rjhelms/compe6502/README.md

# compe6502

A very much work-in-progress homebrew 6502 system.

Hardware is currently built off of a 6502 protoboard, available at https://github.com/rjhelms/6502proto.

All hardware CC-BY-SA 4.0. All software zlib license unless otherwise specified.
