rjhelms/compe6502/examples/clock/README.md

# Clock

An analog clock display, as a demonstration of TGI and clock implementations.

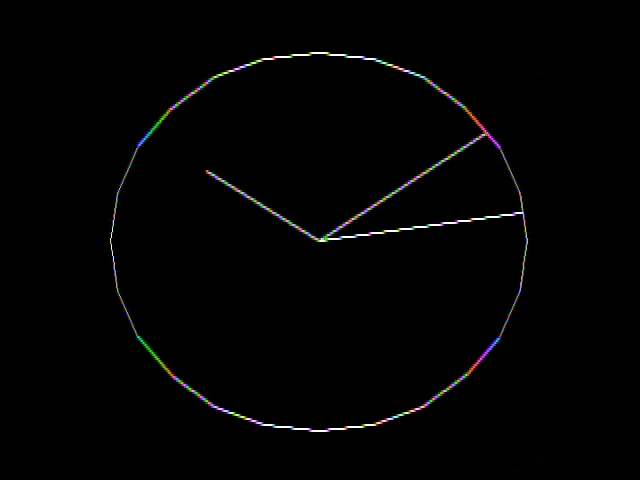
[picture p1: examples/clock/img/clock_1.jpg]

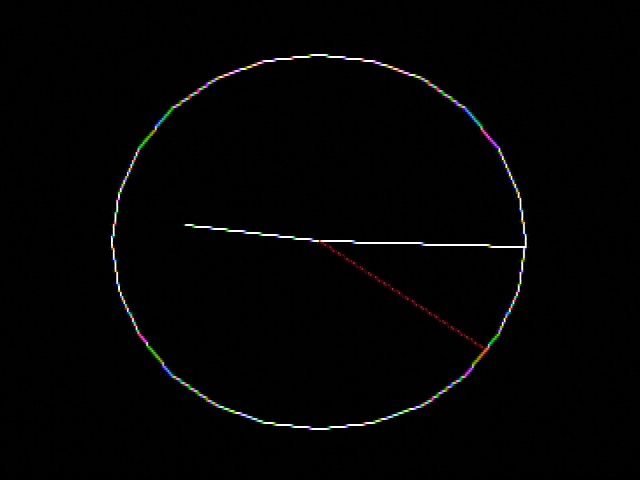
[picture p2: examples/clock/img/clock_2.jpg]

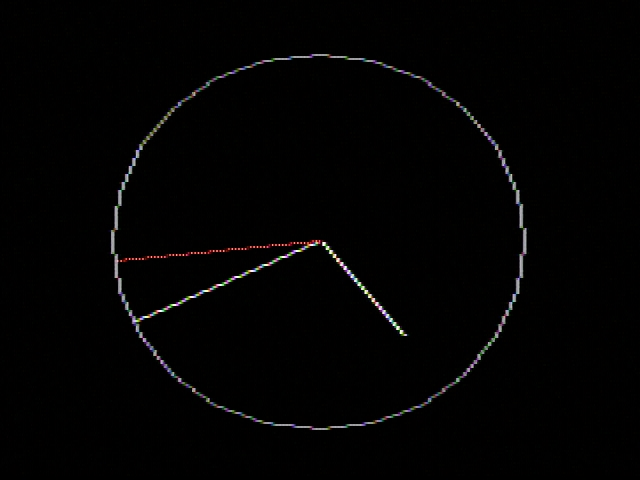
[picture p3: examples/clock/img/clock_3.jpg]


## Building

To choose a TGI driver (and therefore graphics mode), set the MODE variable when
building:

* `_1BPP`: 640x192 monochrome
* `_4BPP`: 320x192 16-color
* `_8BPP`: 160x192 256-color
