rjhelms/compe6502/examples/hangman/README.md

# Hangman

A simple implenetation of the classic game Hangman, as a modest example of the cc65 buildchain for the Compe6502.

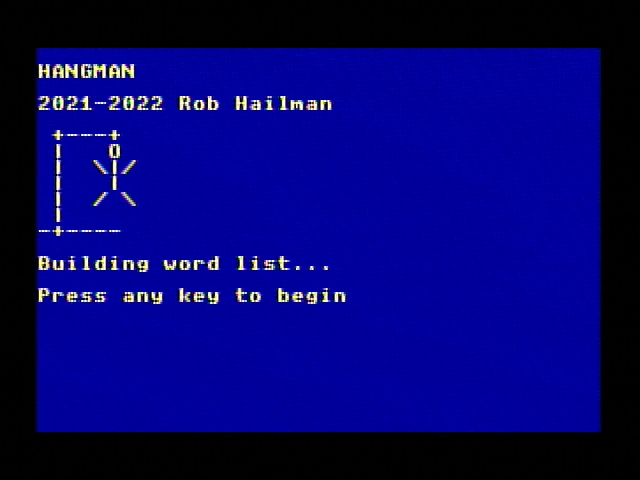
[picture p4: examples/hangman/img/hangman_1.jpg]

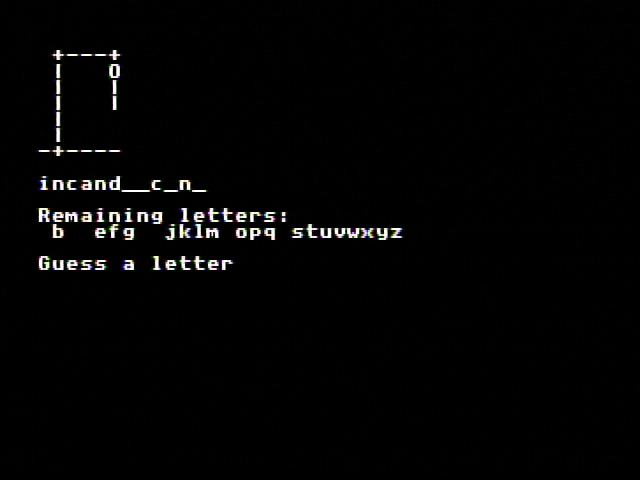
[picture p5: examples/hangman/img/hangman_2.jpg]

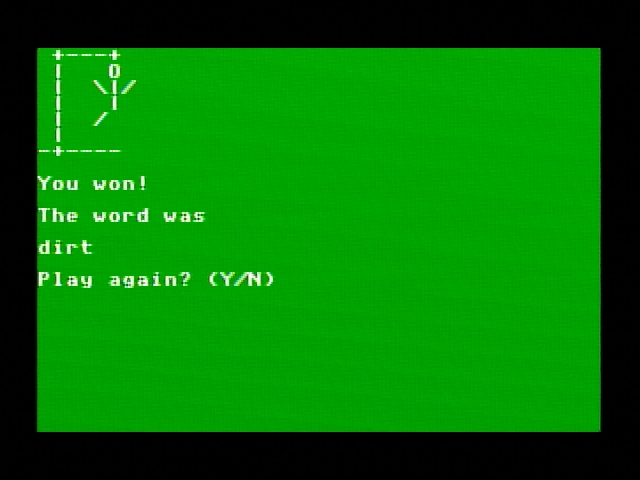
[picture p6: examples/hangman/img/hangman_3.jpg]
