rjhelms/compe6502/Hardware/backplane/backplane.png

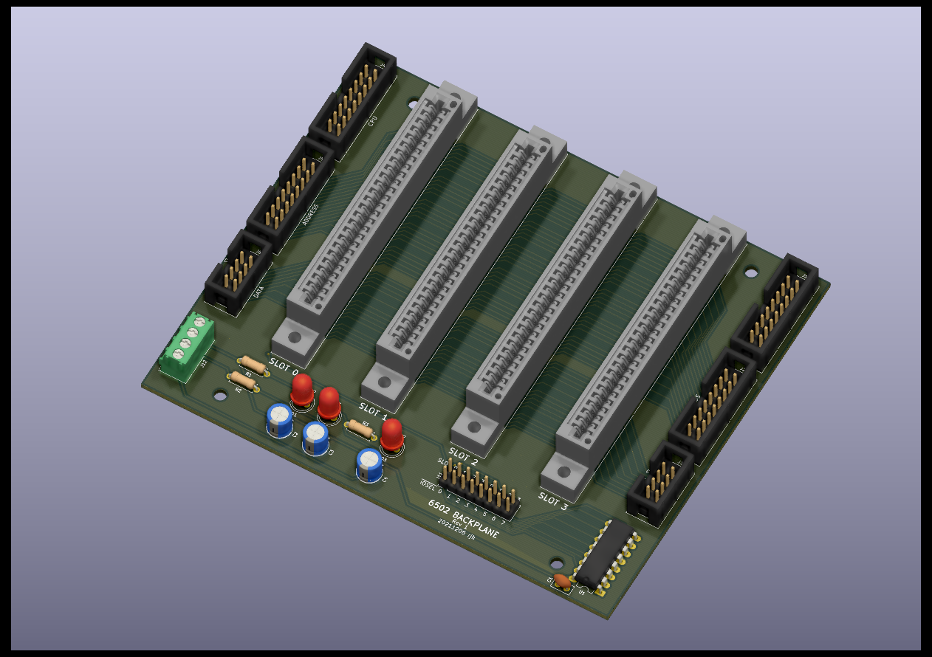
Hardware/backplane/backplane.png
