rjhelms/compe6502/Hardware/io_card/io_card.png

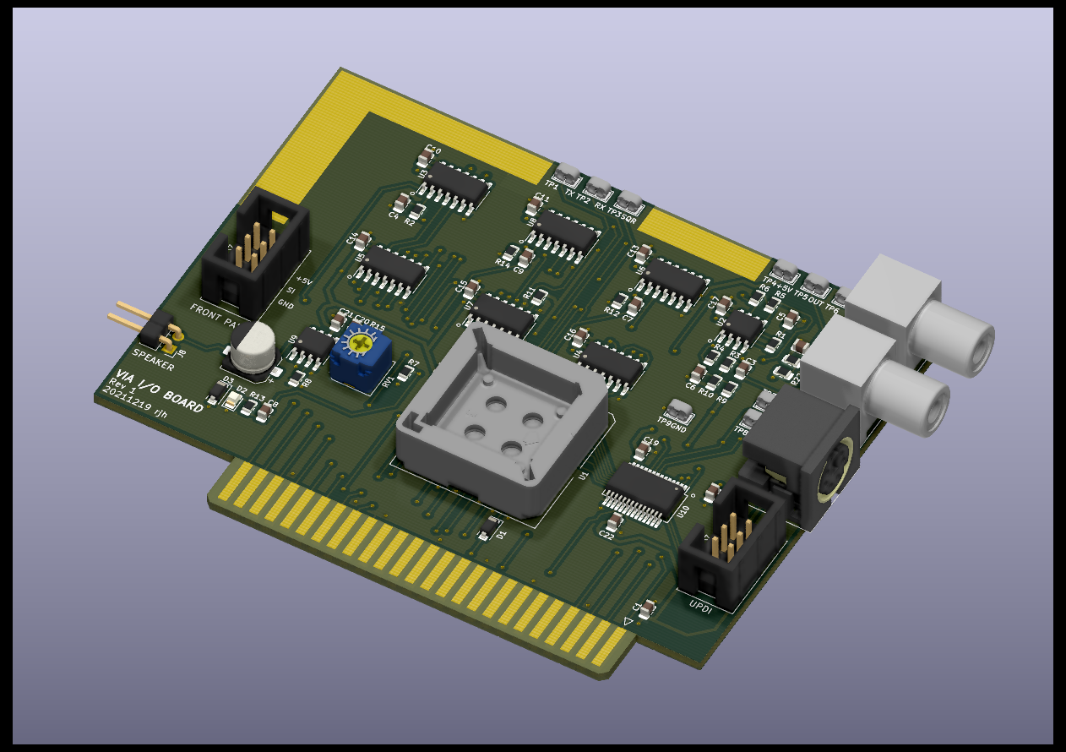
Hardware/io_card/io_card.png
