rjhelms/compe6502/Hardware/proto_card/proto_card.png

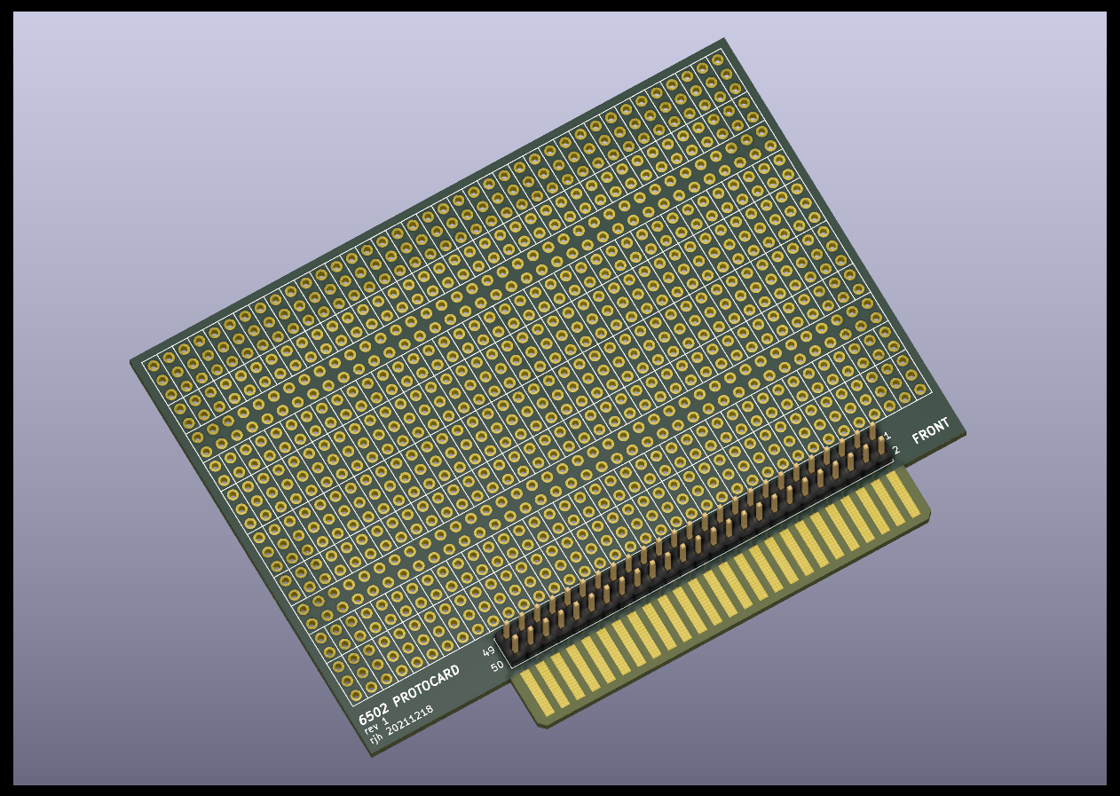
Hardware/proto_card/proto_card.png
