rjhelms/compe6502/Hardware/video_ribbons/video_ribbons.png

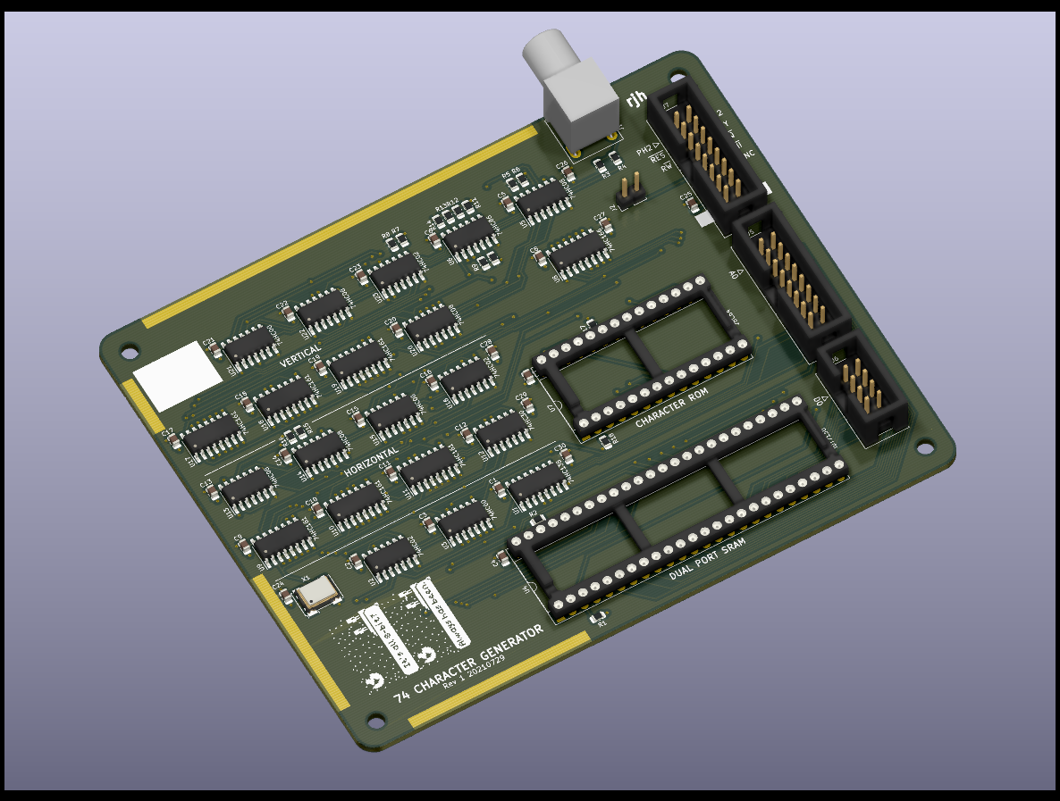
Hardware/video_ribbons/video_ribbons.png
