rjhelms/compe6502/(threads)

Thread 3 (2021-12-24):

Address decode bits wrong on backplane

rjhelms, 2021-12-24:
This is fine for prototyping, but not what I intended.

Select bits should be A11-A13, to give each IOSEL a 1kB space. Backplane currently uses A12-A14, so each IOSEL space is 2kb and IOSEL4-7 are in ROM space.

rjhelms, 2022-01-03:
Verified working on bodged backplane

Closed 2022-01-03.

Thread 4 (2021-12-24):

Bad resistors on backplane power LEDs

rjhelms, 2021-12-24:
R3 should be between -12V LED and -12V rail, not between LED and ground.

rjhelms, 2022-01-03:
Verified working on bodged backplane

Closed 2022-01-03.

Thread 5 (2021-12-24):

Video: Clear on U8 tied to ground, preventing video output

rjhelms, 2021-12-24:
Clear (pin 9) is active low, so should be tied to +5V.

rjhelms, 2022-01-03:
Verified working on bodged video card

Closed 2022-01-03.

Thread 7 (2022-01-04):

VIO I/O Card: Cassette output generates half expected frequency

rjhelms, 2022-01-04:
Generating 600Hz and 1200Hz, instead of 1200Hz and 2400Hz.

Seems to be because of the wrong outputs on U3 - using Q5 and Q6 when it should be Q4 and Q5.

Thread 9 (2022-01-05):

VIA I/O Card: occasional erroneous cassette input

rjhelms, 2022-01-05:
Under some unknown circumstance, cassette input 0 can momentarily be received as a 1:

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

This seems to not occur when a scope probe is attached to pin 3 (Q7) of U6 - perhaps it is ringing on that signal which could be resolved by a small (30pF-ish?) capacitor.

rjhelms, 2022-01-06:
Seems to be resolved by bodging on a 47pF capacitor between pin 3 of U6 and ground

rjhelms, 2022-08-08:
47pF cap has seemingly fully resolved this. Need to check if this is reflected in the KiCad project.

Thread 16 (2022-01-10):

BASIC: cast tokens to uppercase

rjhelms, 2022-01-10:
GET_UPPER in misc3.s (KBD patch) should point in the right direction.

rjhelms, 2022-01-10:
This is working for tokens but not for variable names, which still need to be all upper case or throw a syntax error. Perhaps there is another KBD patch that accomplishes this?

rjhelms, 2022-02-02:
Last commit gets variables cast to uppercase at runtime - which is OK but could be better.

Thread 20 (2022-08-08):

Add cursor support to PicoVGA

rjhelms, 2022-08-08:
Probably a command to show / hide cursor - blink (ie flip high bit) of current text location.

Need some way to remember what the value _should_ be so can be restored when cursor moves. Also probably need new text position routines as a result.

rjhelms, 2022-08-16:
Gonna call this done at cd69d0797e4d5688349c50266f85382210b345ff

Closed 2022-08-16.

Thread 29 (2022-08-18):

Add cc65 clock support

rjhelms, 2022-08-18:
Need to consider if I want this in cc65 lib or in ROM - but could use VIA timer to fire an interrupt that increments a counter.

Need to consider how many ticks per second is desired - balancing time spent in interrupt, accuracy of timer, and amount of data stored.

Some possibilities:
1000 ticks per second: timer 1000, 4.6 hours in 24 bits, 49 days in 32 bits
100 ticks per second: timer 10000, 46 hours in 24 bits, 497 days in 32 bits
60 ticks per second: timer 16666, 77 hours in 24 bits, 828 days in 32 bits
16 ticks per second: timer 62500, 291 hours in 24 bits,  3106 days in 32 bits

rjhelms, 2022-08-28:
Ended up at 64 ticks per second as it divides evenly into 1MHz. Will need to reconsider after switching to 1.023MHz clock.

Closed 2022-08-28.
