rjhelms/compe6502/Hardware/video_ribbons/video_ribbons.pdf

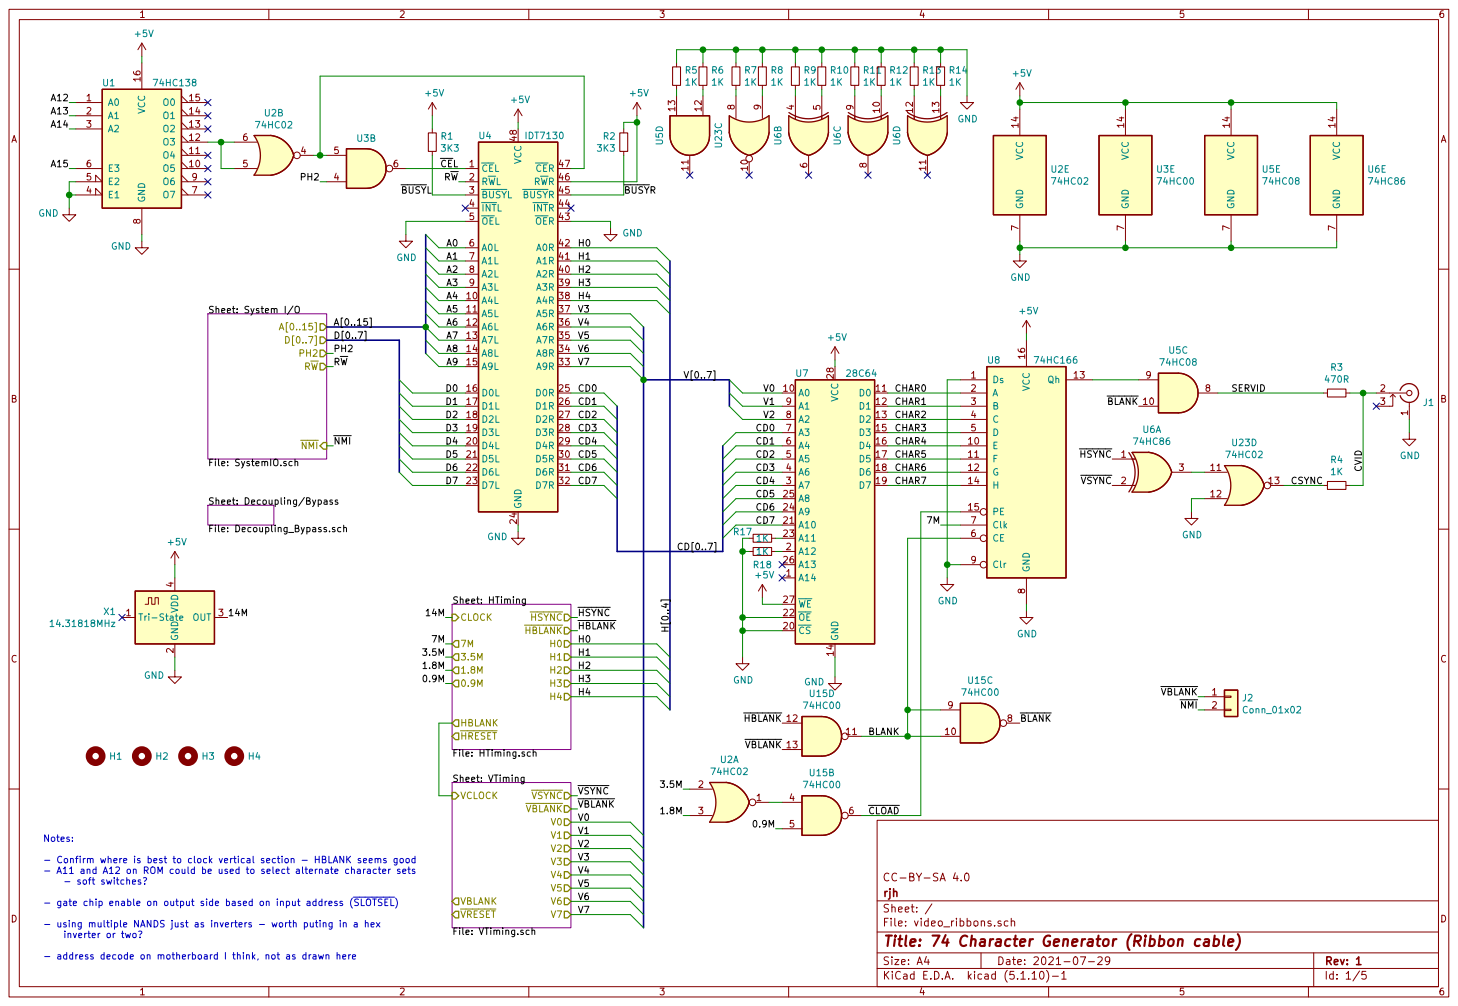
[picture p15: page 1]

8 Clr 9 U8 74HC166 A14 1 A0 10 D0 11 D1 12 D2 13 GND 14 D3 15 D4 16 D5 17 D6 18 D7 19 A12 2 CS 20 A10 21 OE 22 A11 23 A9 24 A8 25 A13 26 WE 27 VCC 28 A7 3 A6 4 A5 5 A4 6 A3 7 A2 8 A1 9 U7 28C64 +5V GND

NMI Sheet: Decoupling/Bypass
File: SystemIO.sch

File: video_ribbons.sch Sheet: / rjhCC-BY-SA 4.0 Sheet: HTiming

HBLANK Notes: - Confirm where is best to clock vertical section - HBLANK seems good

- A11 and A12 on ROM could be used to select alternate character sets
- soft switches?

- gate chip enable on output side based on input address (SLOTSEL)
- using multiple NANDS just as inverters - worth puting in a hex
inverter or two?

Id: 1/5 Title: 74 Character Generator (Ribbon cable)

- address decode on motherboard I think, not as drawn here

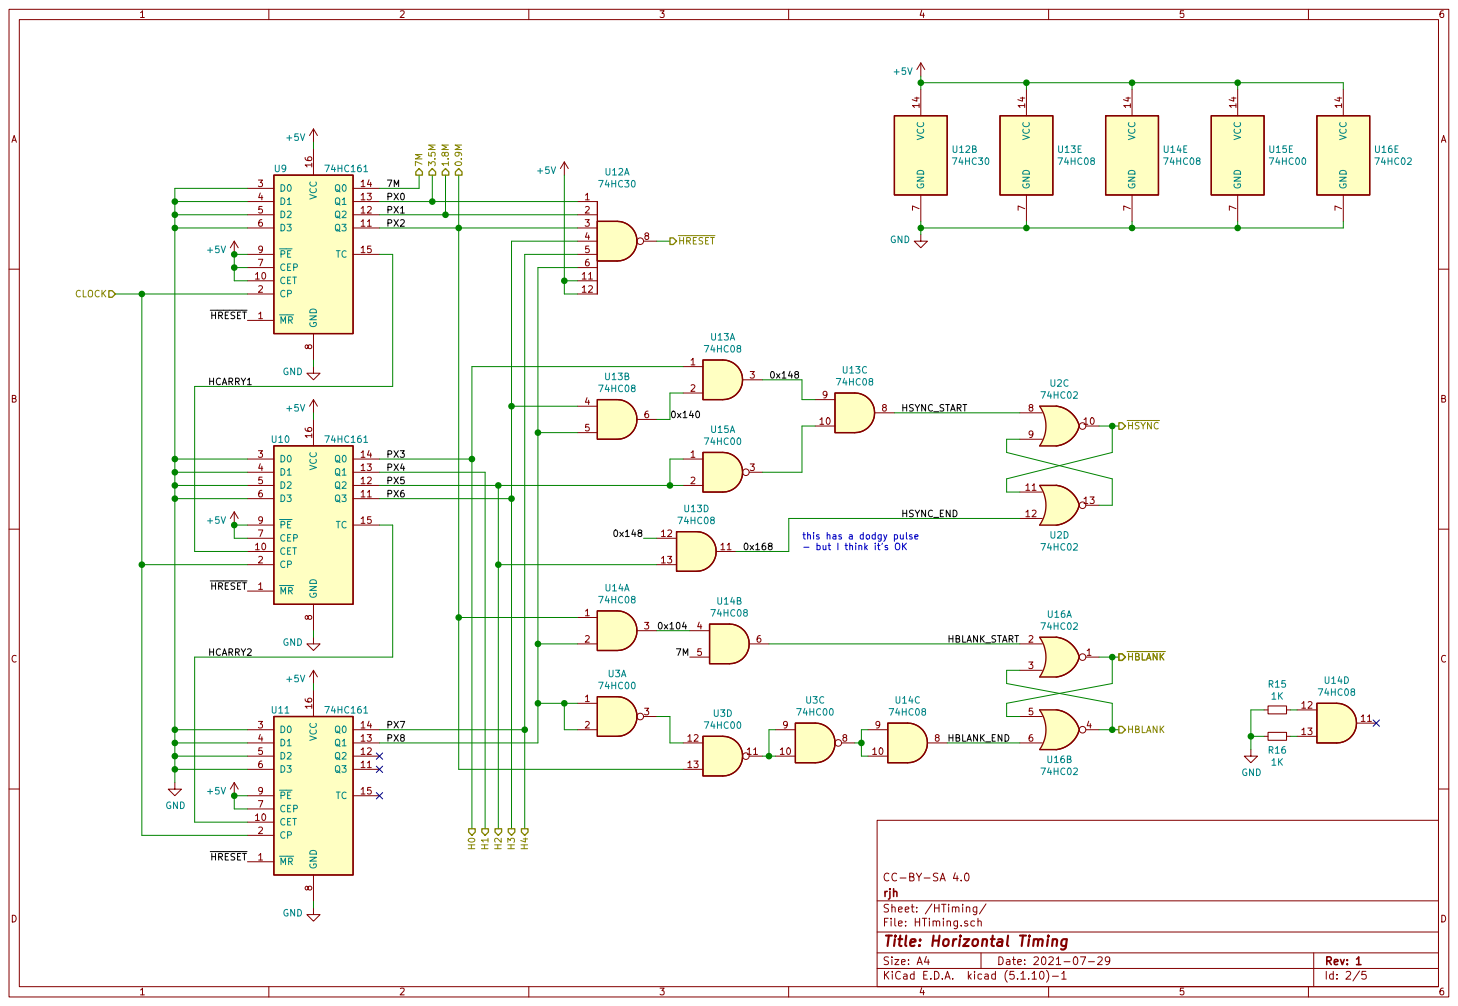
[picture p16: page 2]

this has a dodgy pulse
- but I think it's OK

Sheet: /HTiming/
File: HTiming.sch
Id: 2/5 Title: Horizontal Timing

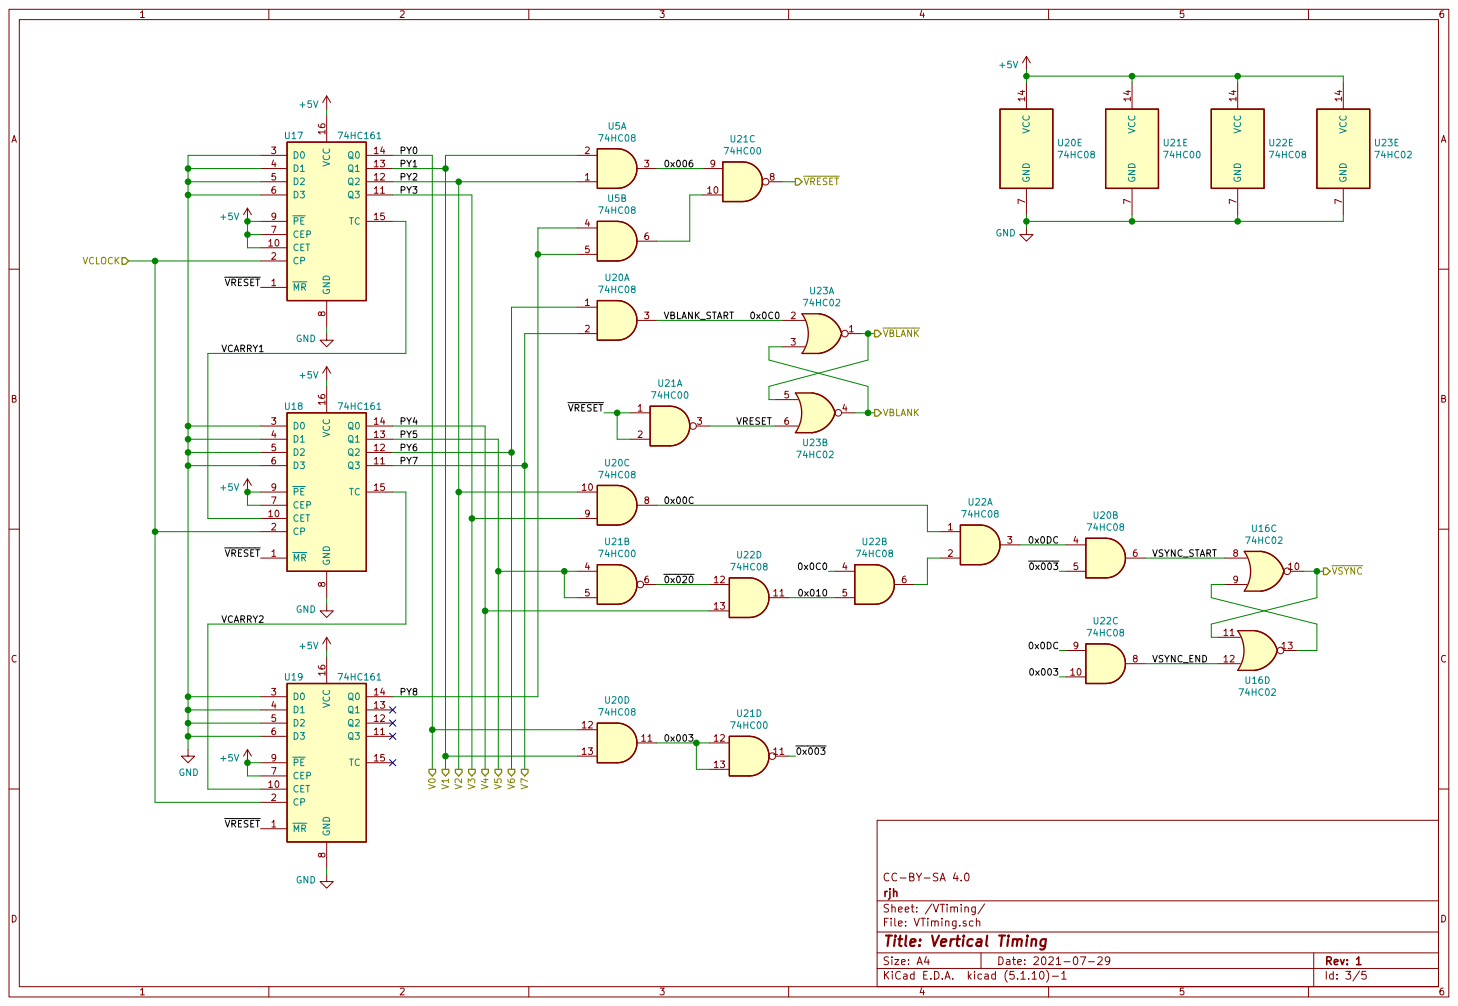
[picture p17: page 3]

8 PE 9 U18 74HC161 MR 1 CET 10 Q3 11 Q2 12 Q1 13 Q0 14 TC 15 VCC 16 CP 2 D0 3 D1 4 D2 5 D3 6 CEP 7 GND

Sheet: /VTiming/
File: VTiming.sch
Id: 3/5 Title: Vertical Timing

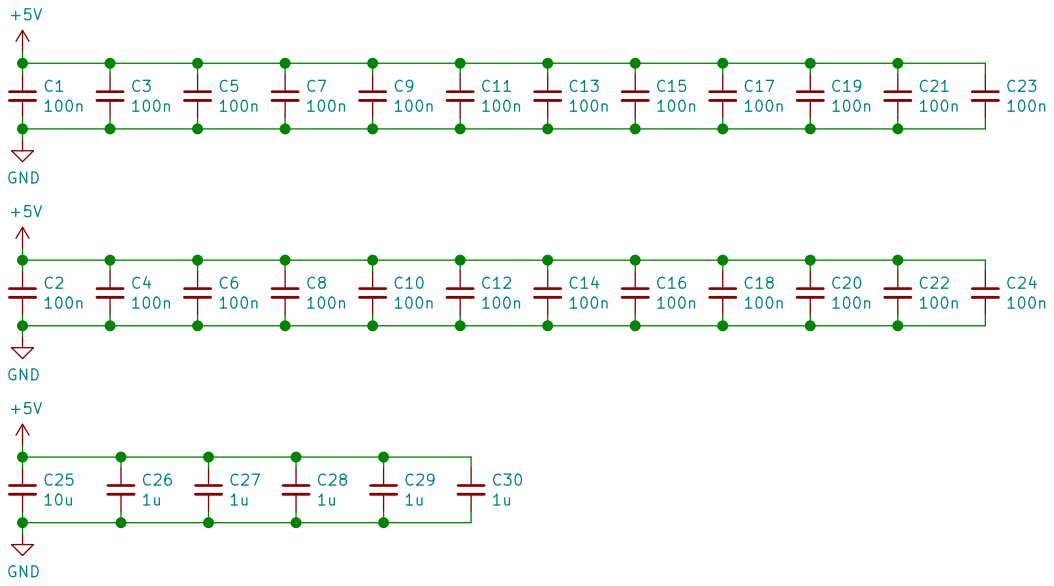
[picture p18: page 4]

Sheet: /Decoupling/Bypass/
File: Decoupling_Bypass.sch
Id: 4/5 Title: Decoupling / Bypass Capacitors

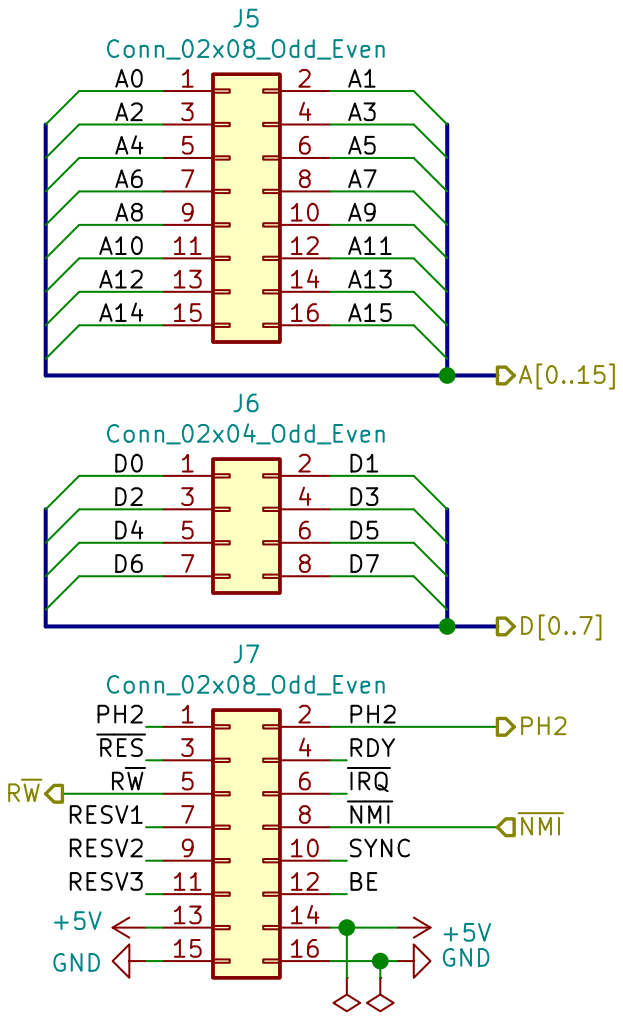
[picture p19: page 5]
