rjhelms/compe6502/Hardware/backplane/backplane.pdf

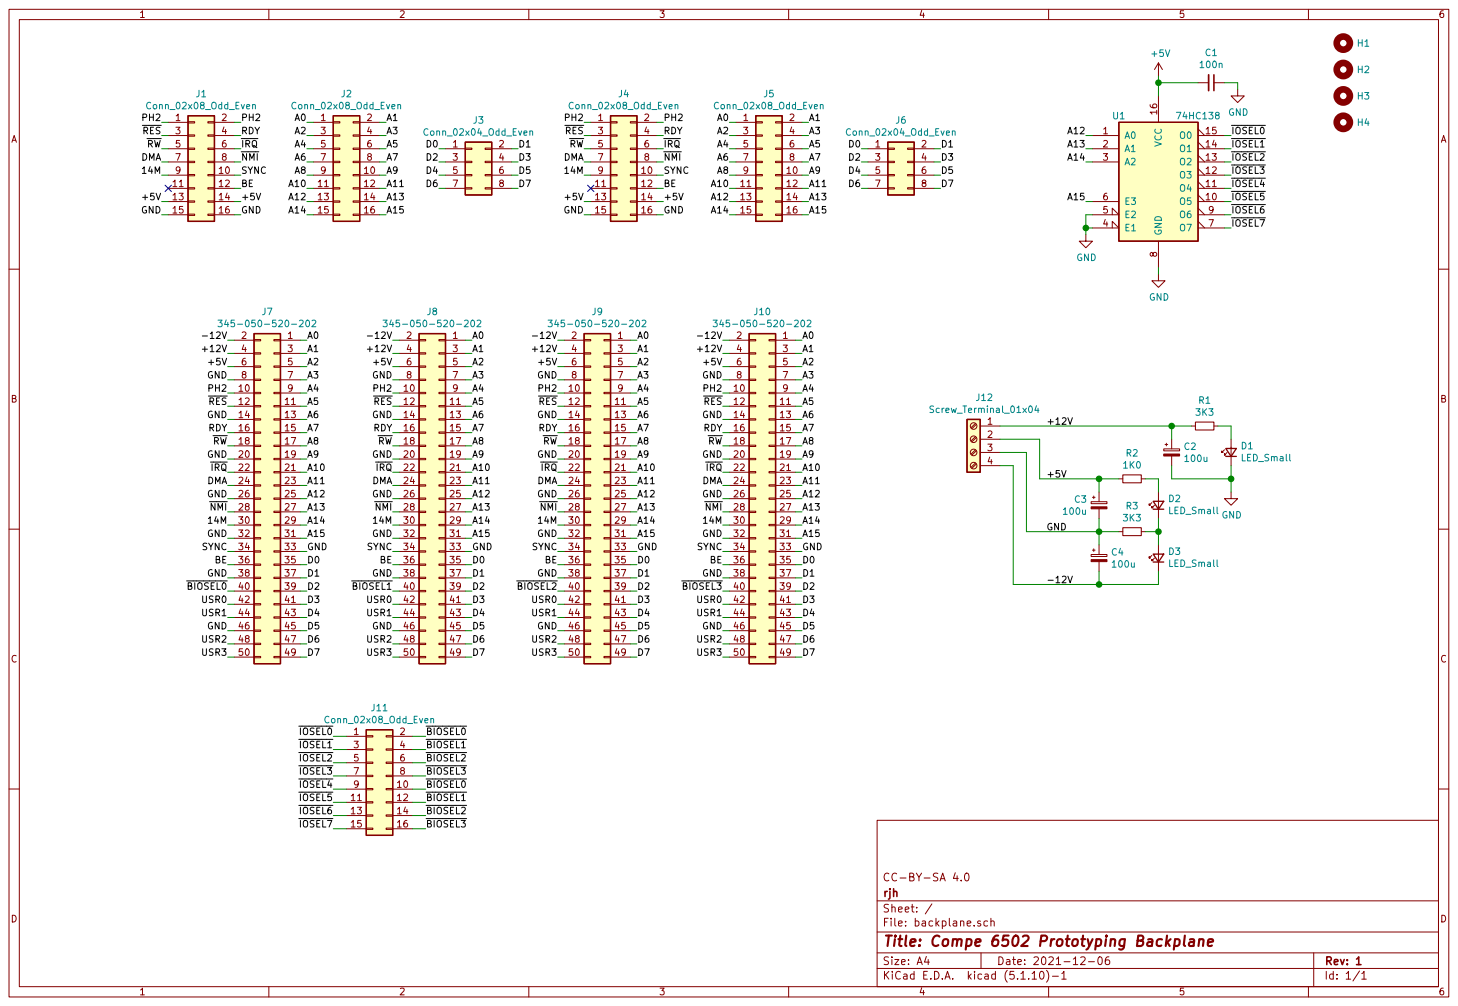
[picture p20: page 1]

File: backplane.sch Sheet: / rjhCC-BY-SA 4.0

Id: 1/1 Title: Compe 6502 Prototyping Backplane
