rjhelms/compe6502/Hardware/io_card/io_card.pdf

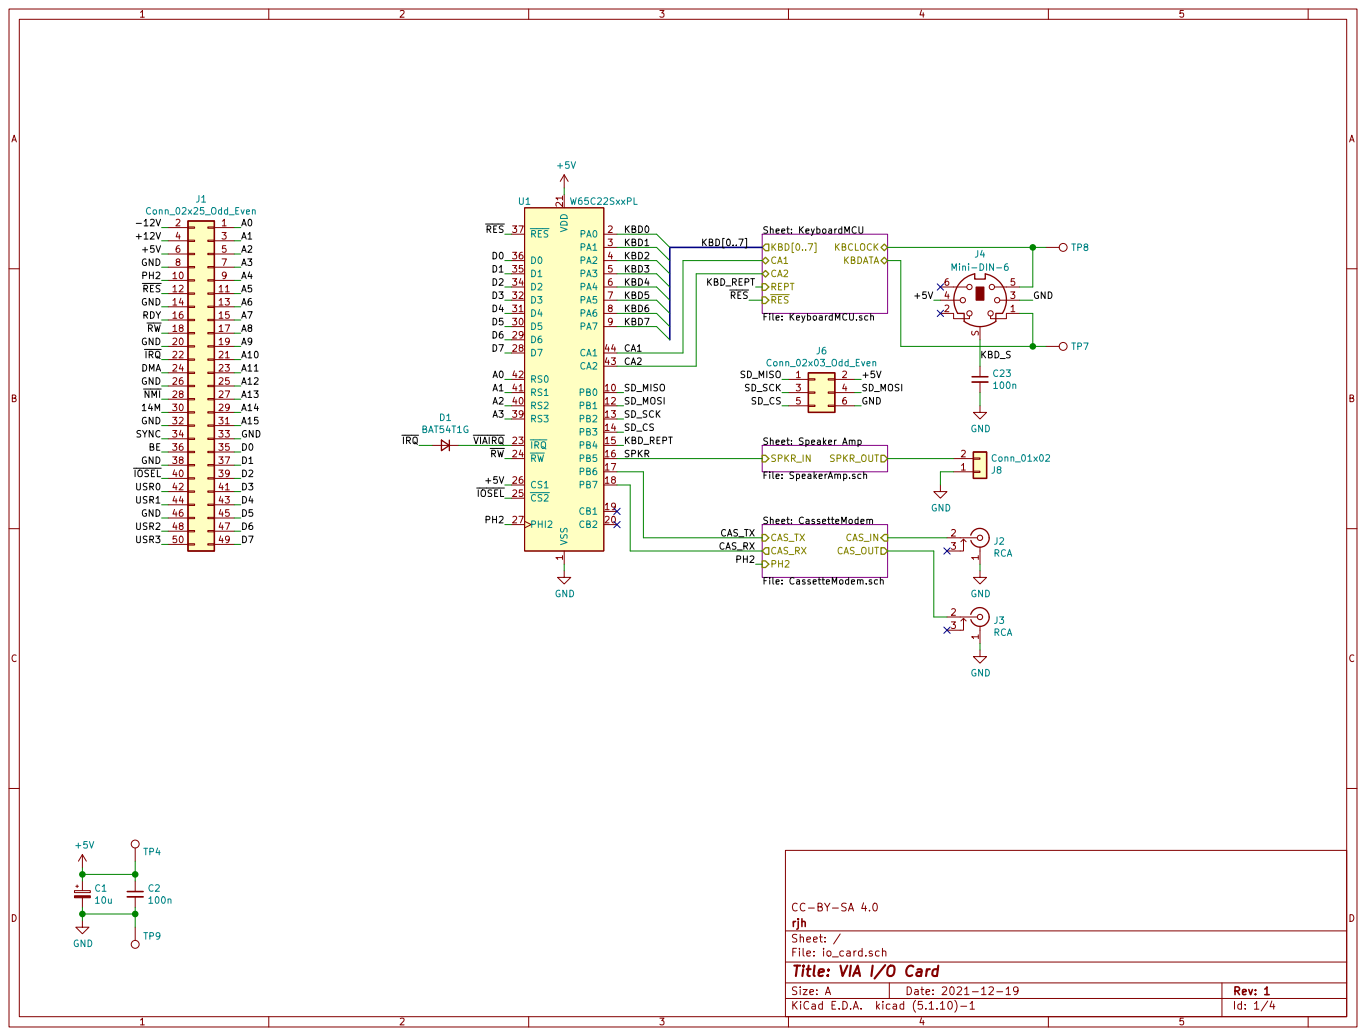
[picture p21: page 1]

File: io_card.sch Sheet: / rjhCC-BY-SA 4.0

Id: 1/4 Title: VIA I/O Card

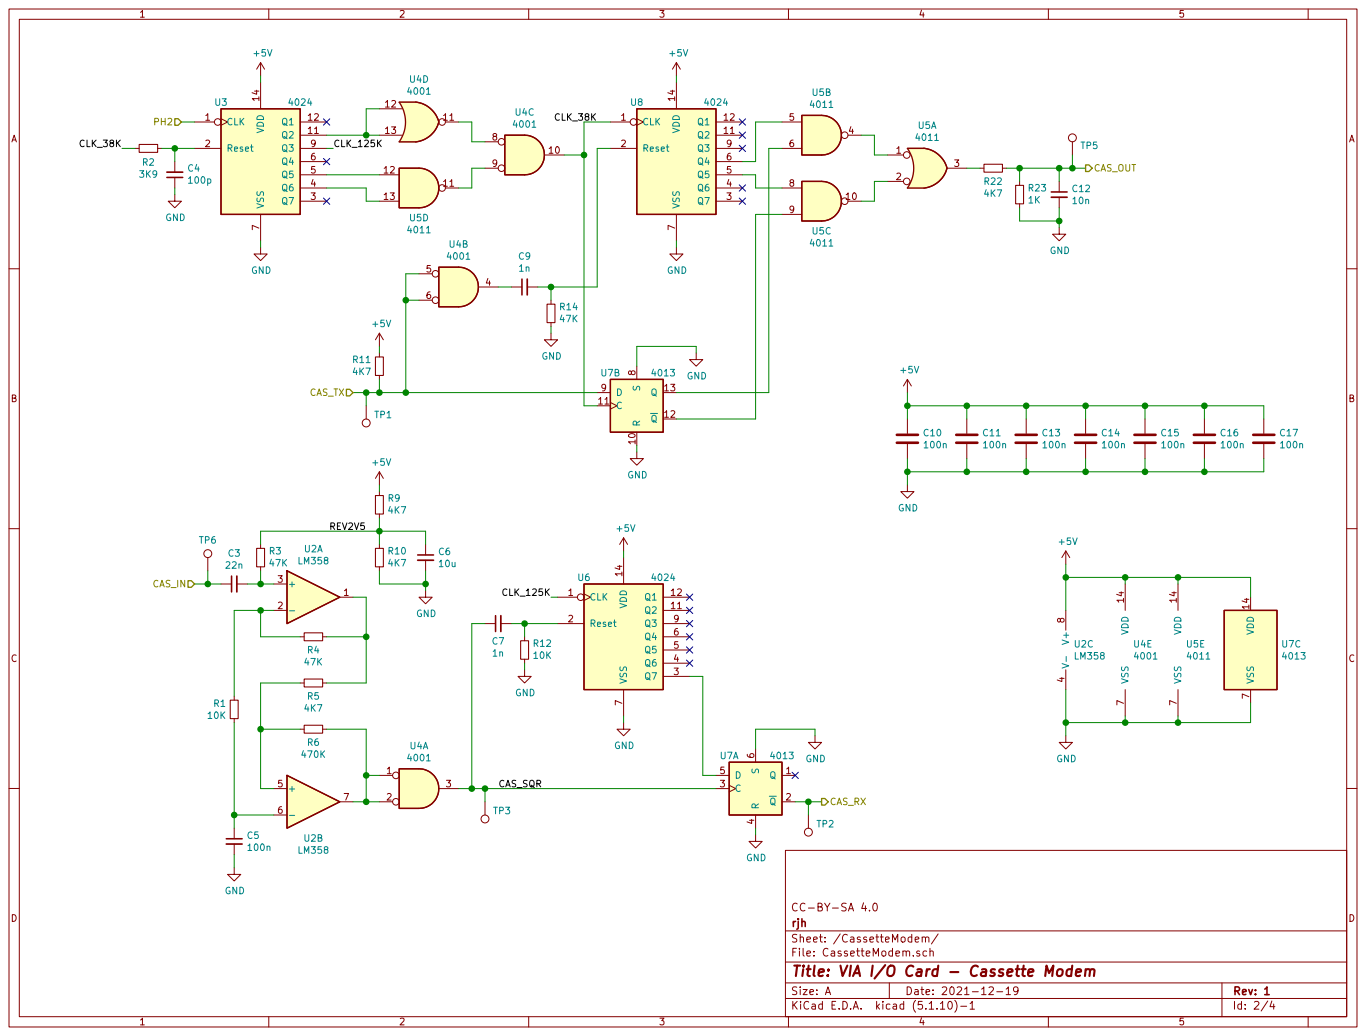
[picture p22: page 2]

File: CassetteModem.sch Sheet: /CassetteModem/ rjhCC-BY-SA 4.0

Id: 2/4 Title: VIA I/O Card - Cassette Modem

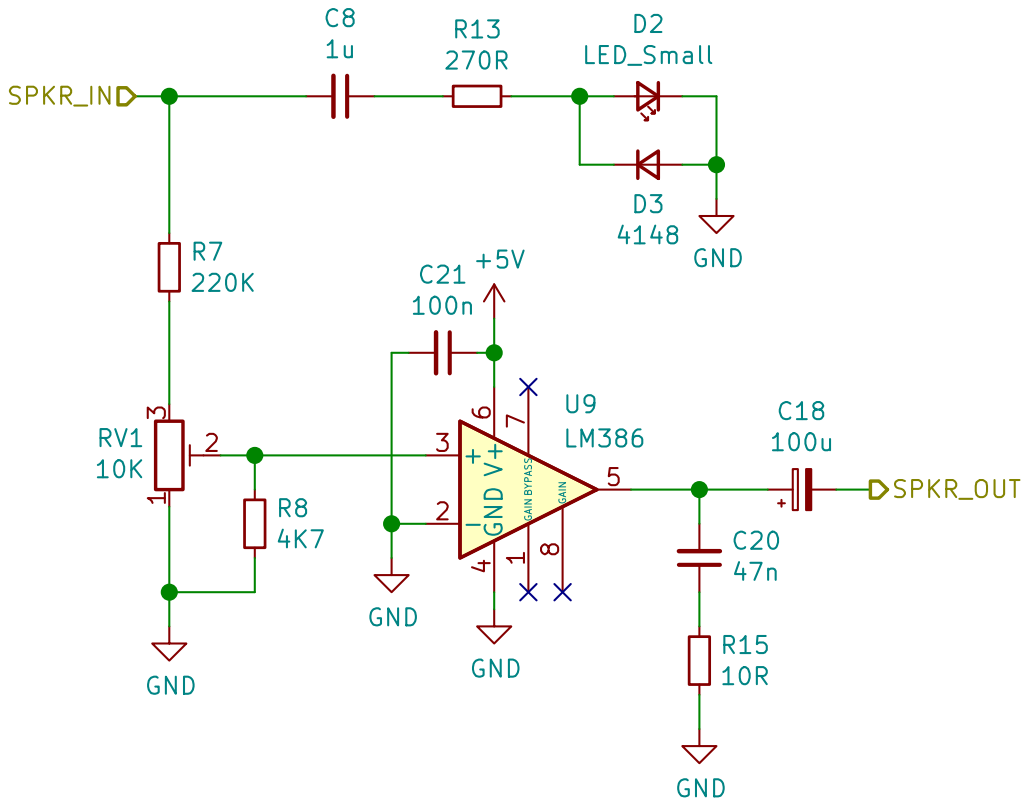
[picture p23: page 3]

rjhCC-BY-SA 4.0
Sheet: /Speaker Amp/
File: SpeakerAmp.sch
Id: 3/4 Title: VIA I/O Card - Speaker Amplifier

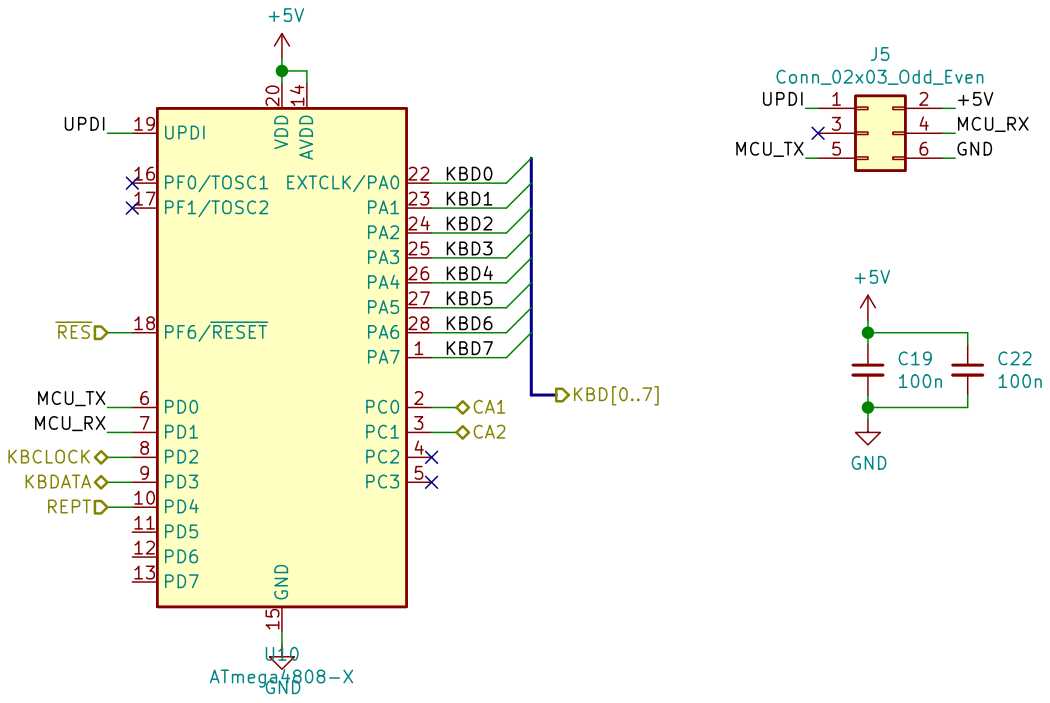
[picture p24: page 4]

rjhCC-BY-SA 4.0 GND

Sheet: /KeyboardMCU/
File: KeyboardMCU.sch
Id: 4/4 Title: VIA I/O Card - Keyboard MCU
