rjhelms/compe6502/Hardware/proto_card/proto_card.pdf

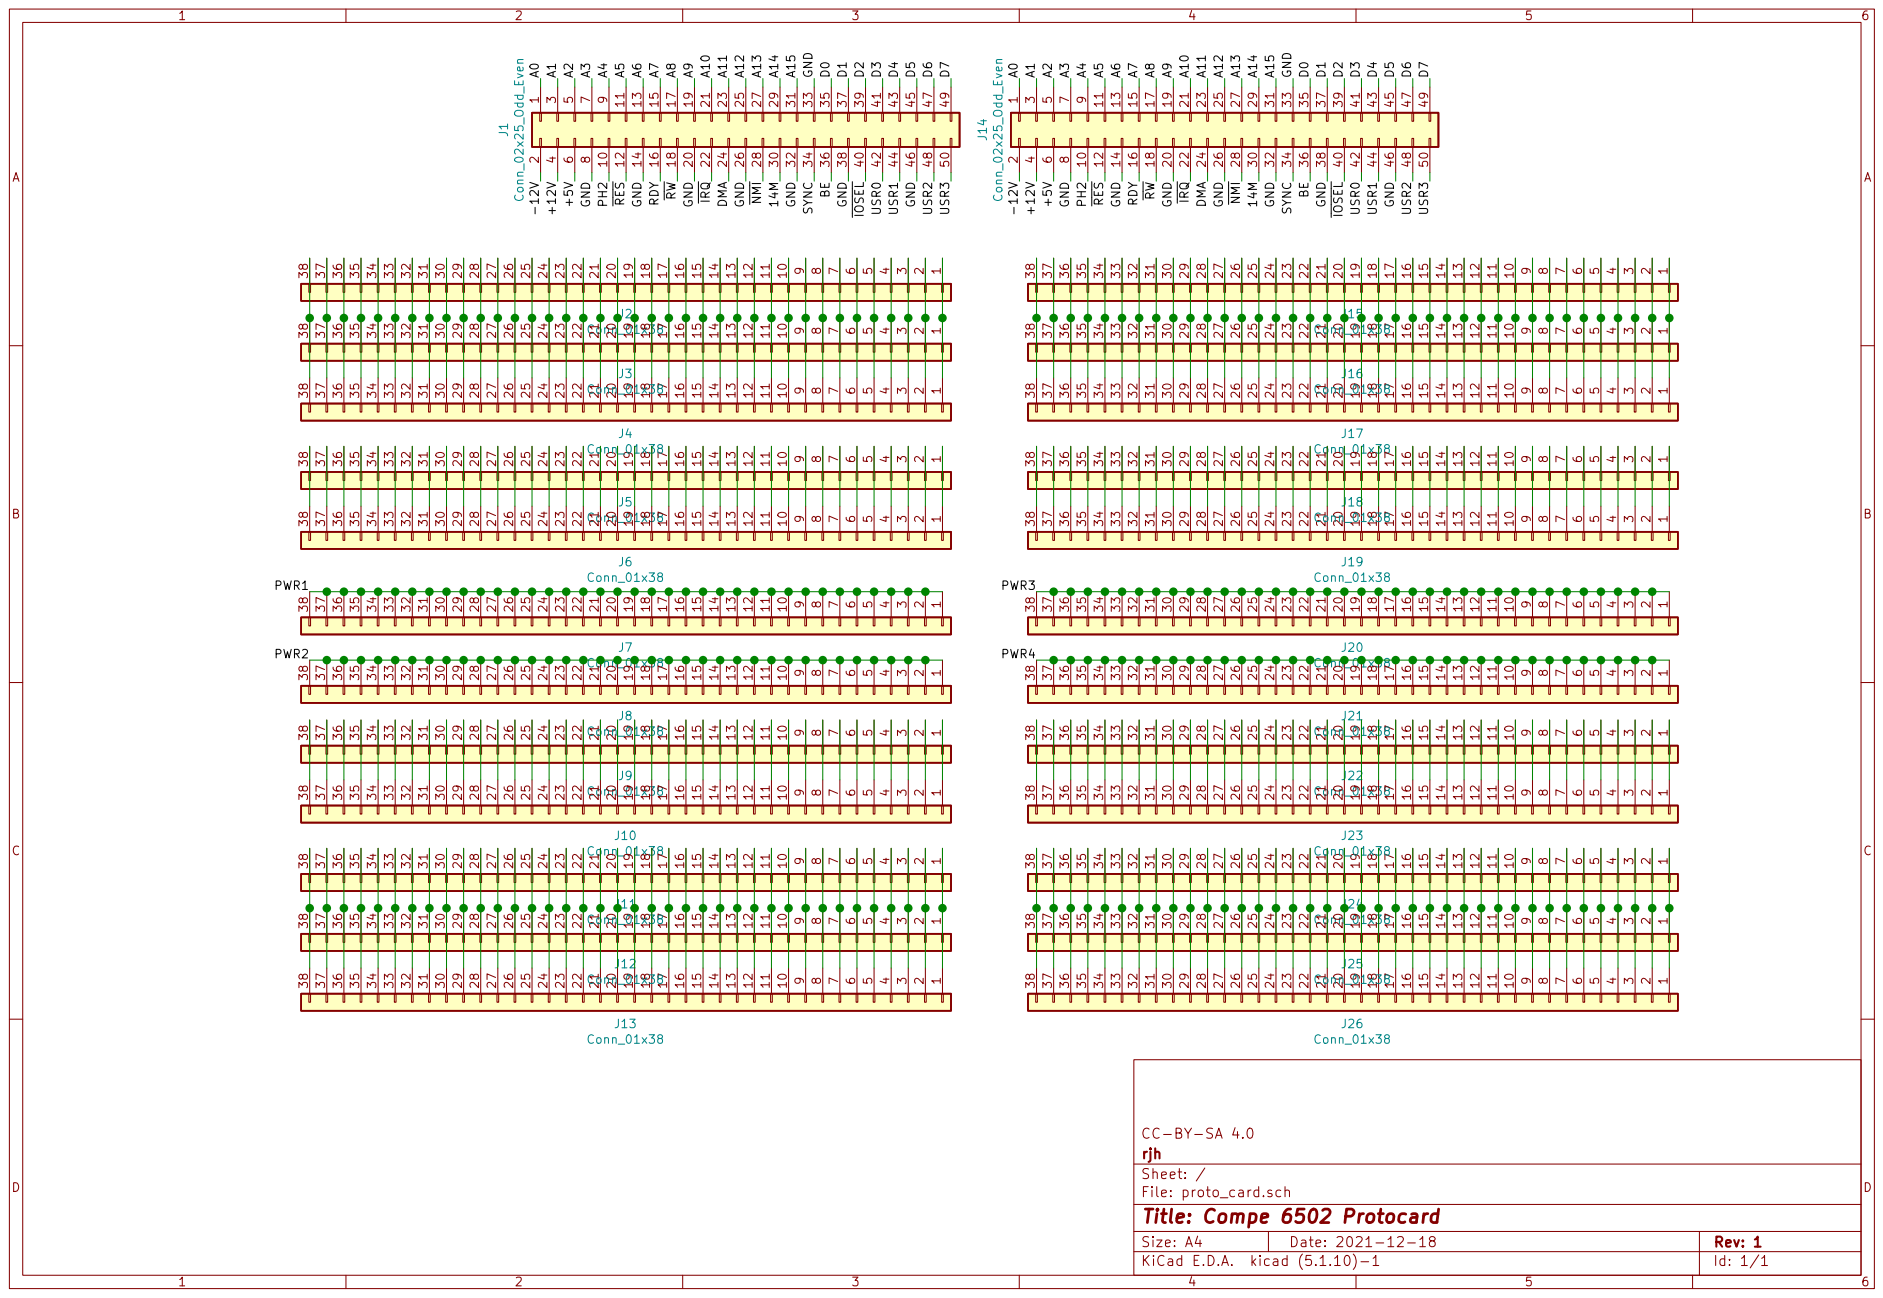
[picture p25: page 1]

Id: 1/1 Title: Compe 6502 Protocard
