rjhelms/compe6502/Hardware/motherboard/motherboard.kicad_pcb

## KiCad design Hardware/motherboard/motherboard.kicad_pcb (2022-02-02)

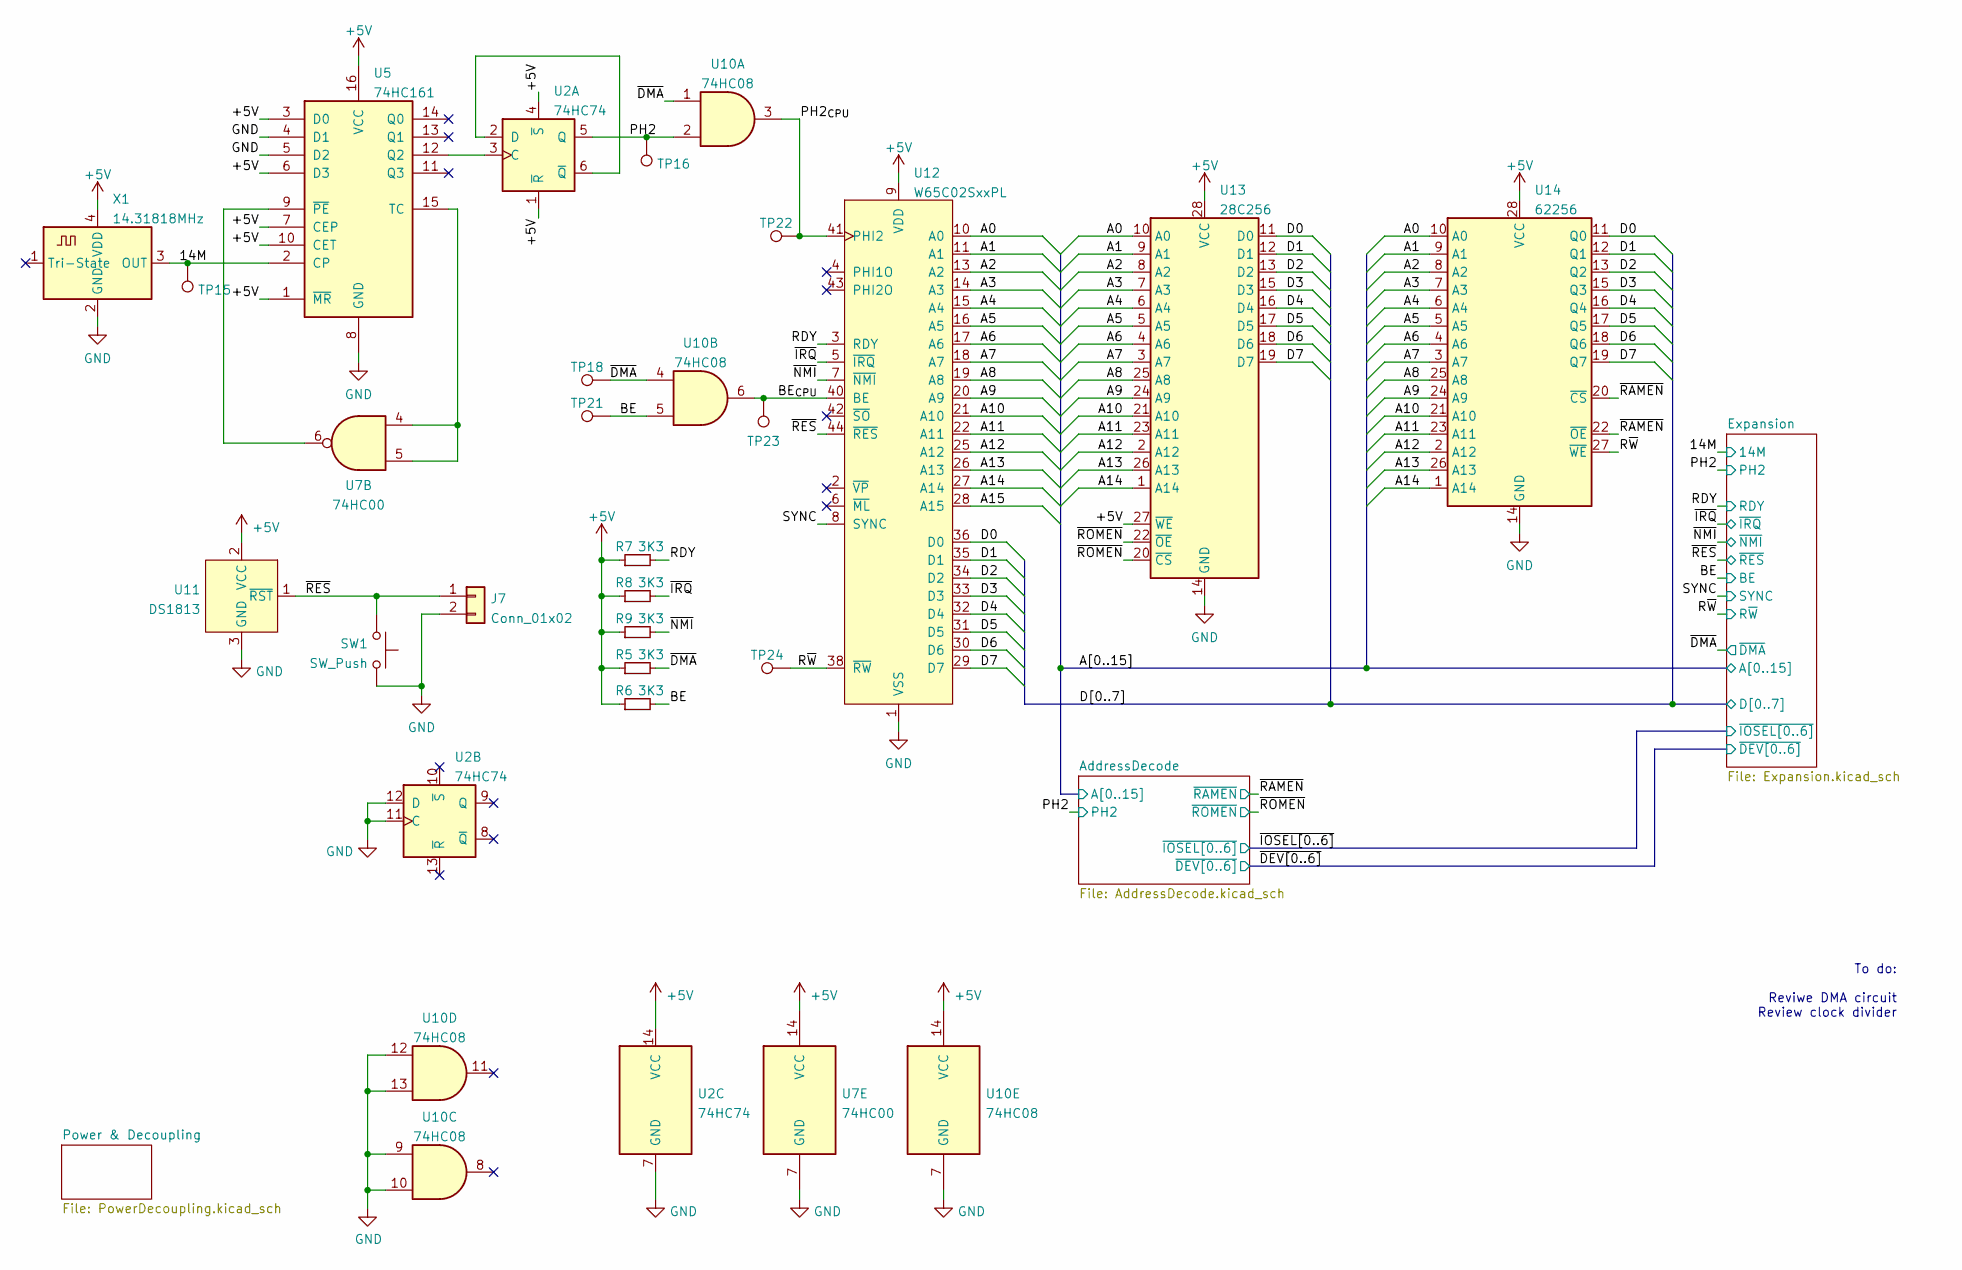
[picture p26: schematic motherboard.kicad_sch]

Parts:
J7: Conn_01x02; PinHeader_1x02_P2.54mm_Vertical
R5, R6, R7, R8, R9: 3K3; R_0805_2012Metric
SW1: SW_Push; SW_SPST_B3S-1000
TP15, TP16, TP18, TP21, TP22, TP23, TP24: TestPoint; TestPoint_THTPad_D1.5mm_Drill0.7mm
U2: 74HC74; SOIC-14_3.9x8.7mm_P1.27mm
U5: 74HC161; SOIC-16_3.9x9.9mm_P1.27mm
U7: 74HC00; SOIC-14_3.9x8.7mm_P1.27mm
U10: 74HC08; SOIC-14_3.9x8.7mm_P1.27mm
U11: DS1813; TO-92_Inline
U12: W65C02SxxPL; PLCC-44_THT-Socket
U13: 28C256; DIP-28_W15.24mm_Socket_LongPads
U14: 62256; SOIC-28W_7.5x18.7mm_P1.27mm
X1: 14.31818MHz; Oscillator_SMD_IQD_IQXO70-4Pin_7.5x5.0mm

Connections:
+5V: R5.1, R6.1, R7.1, R8.1, R9.1, U2.1 (~R), U2.4 (~S), U2.14 (VCC), U5.1 (~MR), U5.3 (D0), U5.6 (D3), U5.7 (CEP), U5.10 (CET), U5.16 (VCC), U7.14 (VCC), U10.14 (VCC), U11.2 (VCC), U12.9 (VDD), U12.37 (VDD), U13.27 (~WE), U13.28 (VCC), U14.28 (VCC), X1.4 (VDD); also elsewhere on the board
/14M: TP15.1, U5.2 (CP), X1.3 (OUT); also elsewhere on the board
/A0: U12.10 (A0), U13.10 (A0), U14.10 (A0); also elsewhere on the board
/A1: U12.11 (A1), U13.9 (A1), U14.9 (A1); also elsewhere on the board
/A2: U12.13 (A2), U13.8 (A2), U14.8 (A2); also elsewhere on the board
/A3: U12.14 (A3), U13.7 (A3), U14.7 (A3); also elsewhere on the board
/A4: U12.15 (A4), U13.6 (A4), U14.6 (A4); also elsewhere on the board
/A5: U12.16 (A5), U13.5 (A5), U14.5 (A5); also elsewhere on the board
/A6: U12.17 (A6), U13.4 (A6), U14.4 (A6); also elsewhere on the board
/A7: U12.18 (A7), U13.3 (A7), U14.3 (A7); also elsewhere on the board
/A8: U12.19 (A8), U13.25 (A8), U14.25 (A8); also elsewhere on the board
/A9: U12.20 (A9), U13.24 (A9), U14.24 (A9); also elsewhere on the board
/A10: U12.21 (A10), U13.21 (A10), U14.21 (A10); also elsewhere on the board
/A11: U12.22 (A11), U13.23 (A11), U14.23 (A11); also elsewhere on the board
/A12: U12.25 (A12), U13.2 (A12), U14.2 (A12); also elsewhere on the board
/A13: U12.26 (A13), U13.26 (A13), U14.26 (A13); also elsewhere on the board
/A14: U12.27 (A14), U13.1 (A14), U14.1 (A14); also elsewhere on the board
/A15: U12.28 (A15); also elsewhere on the board
/BE: R6.2, TP21.1, U10.5; also elsewhere on the board
/BE_{CPU}: TP23.1, U10.6, U12.40 (BE)
/D0: U12.36 (D0), U13.11 (D0), U14.11 (Q0); also elsewhere on the board
/D1: U12.35 (D1), U13.12 (D1), U14.12 (Q1); also elsewhere on the board
/D2: U12.34 (D2), U13.13 (D2), U14.13 (Q2); also elsewhere on the board
/D3: U12.33 (D3), U13.15 (D3), U14.15 (Q3); also elsewhere on the board
/D4: U12.32 (D4), U13.16 (D4), U14.16 (Q4); also elsewhere on the board
/D5: U12.31 (D5), U13.17 (D5), U14.17 (Q5); also elsewhere on the board
/D6: U12.30 (D6), U13.18 (D6), U14.18 (Q6); also elsewhere on the board
/D7: U12.29 (D7), U13.19 (D7), U14.19 (Q7); also elsewhere on the board
/PH2: TP16.1, U2.5 (Q), U10.2; also elsewhere on the board
/PH2_{CPU}: TP22.1, U10.3, U12.41 (PHI2)
/RDY: R7.2, U12.3 (RDY); also elsewhere on the board
/R~W: TP24.1, U12.38 (~RW), U14.27 (~WE); also elsewhere on the board
/SYNC: U12.8 (SYNC); also elsewhere on the board
/~DMA: R5.2, TP18.1, U10.1, U10.4; also elsewhere on the board
/~IRQ: R8.2, U12.5 (~IRQ); also elsewhere on the board
/~NMI: R9.2, U12.7 (~NMI); also elsewhere on the board
/~RAMEN: U14.20 (~CS), U14.22 (~OE); also elsewhere on the board
/~RES: J7.1, SW1.1, U11.1 (~RST), U12.44 (~RES); also elsewhere on the board
/~ROMEN: U13.20 (~CS), U13.22 (~OE); also elsewhere on the board
GND: J7.2, SW1.2, U2.7 (GND), U2.11 (C), U2.12 (D), U5.4 (D1), U5.5 (D2), U5.8 (GND), U7.7 (GND), U10.7 (GND), U10.9, U10.10, U10.12, U10.13, U11.3 (GND), U12.1 (VSS), U12.23 (VSS), U12.24 (VSS), U13.14 (GND), U14.14 (GND), X1.2 (GND); also elsewhere on the board
unnamed: U2.2 (D), U2.6 (~Q)
unnamed: U2.3 (C), U5.12 (Q2)
unnamed: U5.9 (~PE), U7.6
unnamed: U5.15 (TC), U7.4, U7.5

Notes on the sheet:
To do: Reviwe DMA circuit Review clock divider

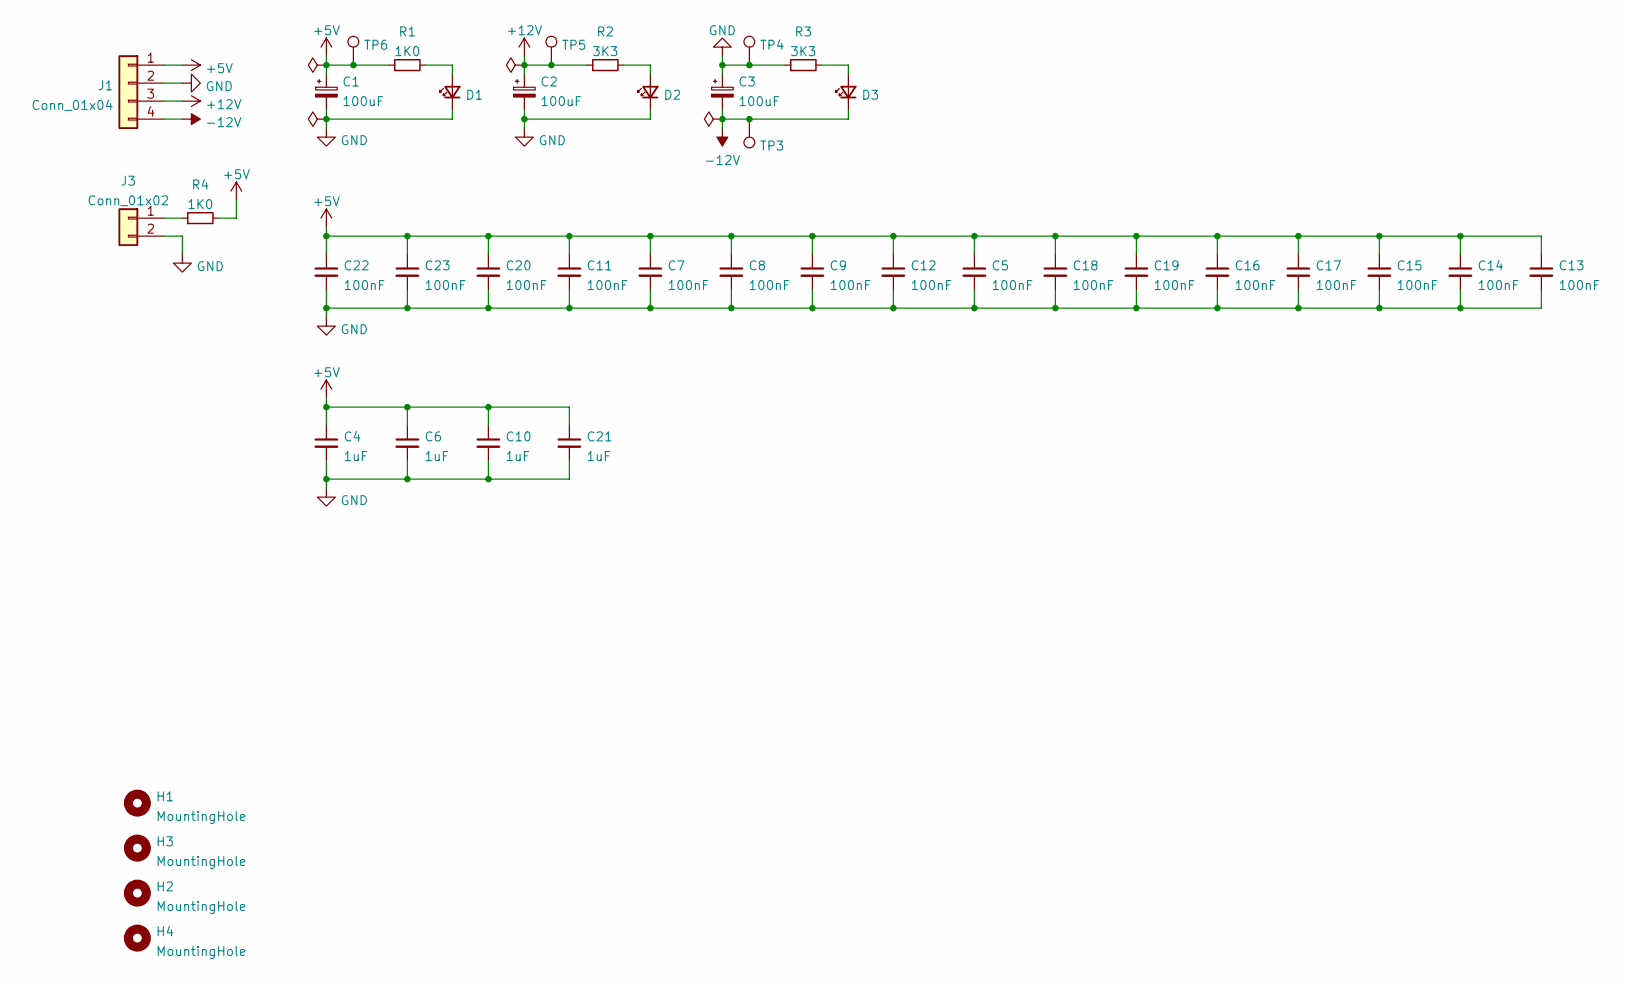
[picture p27: schematic PowerDecoupling.kicad_sch]

Parts:
C1, C2, C3: 100uF; CP_Elec_6.3x7.7
C4, C6, C10, C21: 1uF; C_0805_2012Metric
C5, C7, C8, C9, C11, C12, C13, C14, C15, C16, C17, C18, C19, C20, C22, C23: 100nF; C_0805_2012Metric
D1, D2, D3: LED; LED_0805_2012Metric
H1, H2, H3, H4: MountingHole; MountingHole_3.2mm_M3
J1: Conn_01x04; Molex_Micro-Fit_3.0_43045-0400_2x02_P3.00mm_Horizontal
J3: Conn_01x02; PinHeader_1x02_P2.54mm_Vertical
R1, R4: 1K0; R_0805_2012Metric
R2, R3: 3K3; R_0805_2012Metric
TP3, TP4, TP5, TP6: TestPoint; TestPoint_THTPad_D1.5mm_Drill0.7mm

Connections:
+5V: C1.1, C4.1, C5.1, C6.1, C7.1, C8.1, C9.1, C10.1, C11.1, C12.1, C13.1, C14.1, C15.1, C16.1, C17.1, C18.1, C19.1, C20.1, C21.1, C22.1, C23.1, J1.1, R1.1, R4.2, TP6.1; also elsewhere on the board
+12V: C2.1, J1.3, R2.1, TP5.1; also elsewhere on the board
-12V: C3.2, D3.1 (K), J1.4, TP3.1; also elsewhere on the board
GND: C1.2, C2.2, C3.1, C4.2, C5.2, C6.2, C7.2, C8.2, C9.2, C10.2, C11.2, C12.2, C13.2, C14.2, C15.2, C16.2, C17.2, C18.2, C19.2, C20.2, C21.2, C22.2, C23.2, D1.1 (K), D2.1 (K), J1.2, J3.2, R3.1, TP4.1; also elsewhere on the board
unnamed: D1.2 (A), R1.2
unnamed: D2.2 (A), R2.2
unnamed: D3.2 (A), R3.2
unnamed: J3.1, R4.1

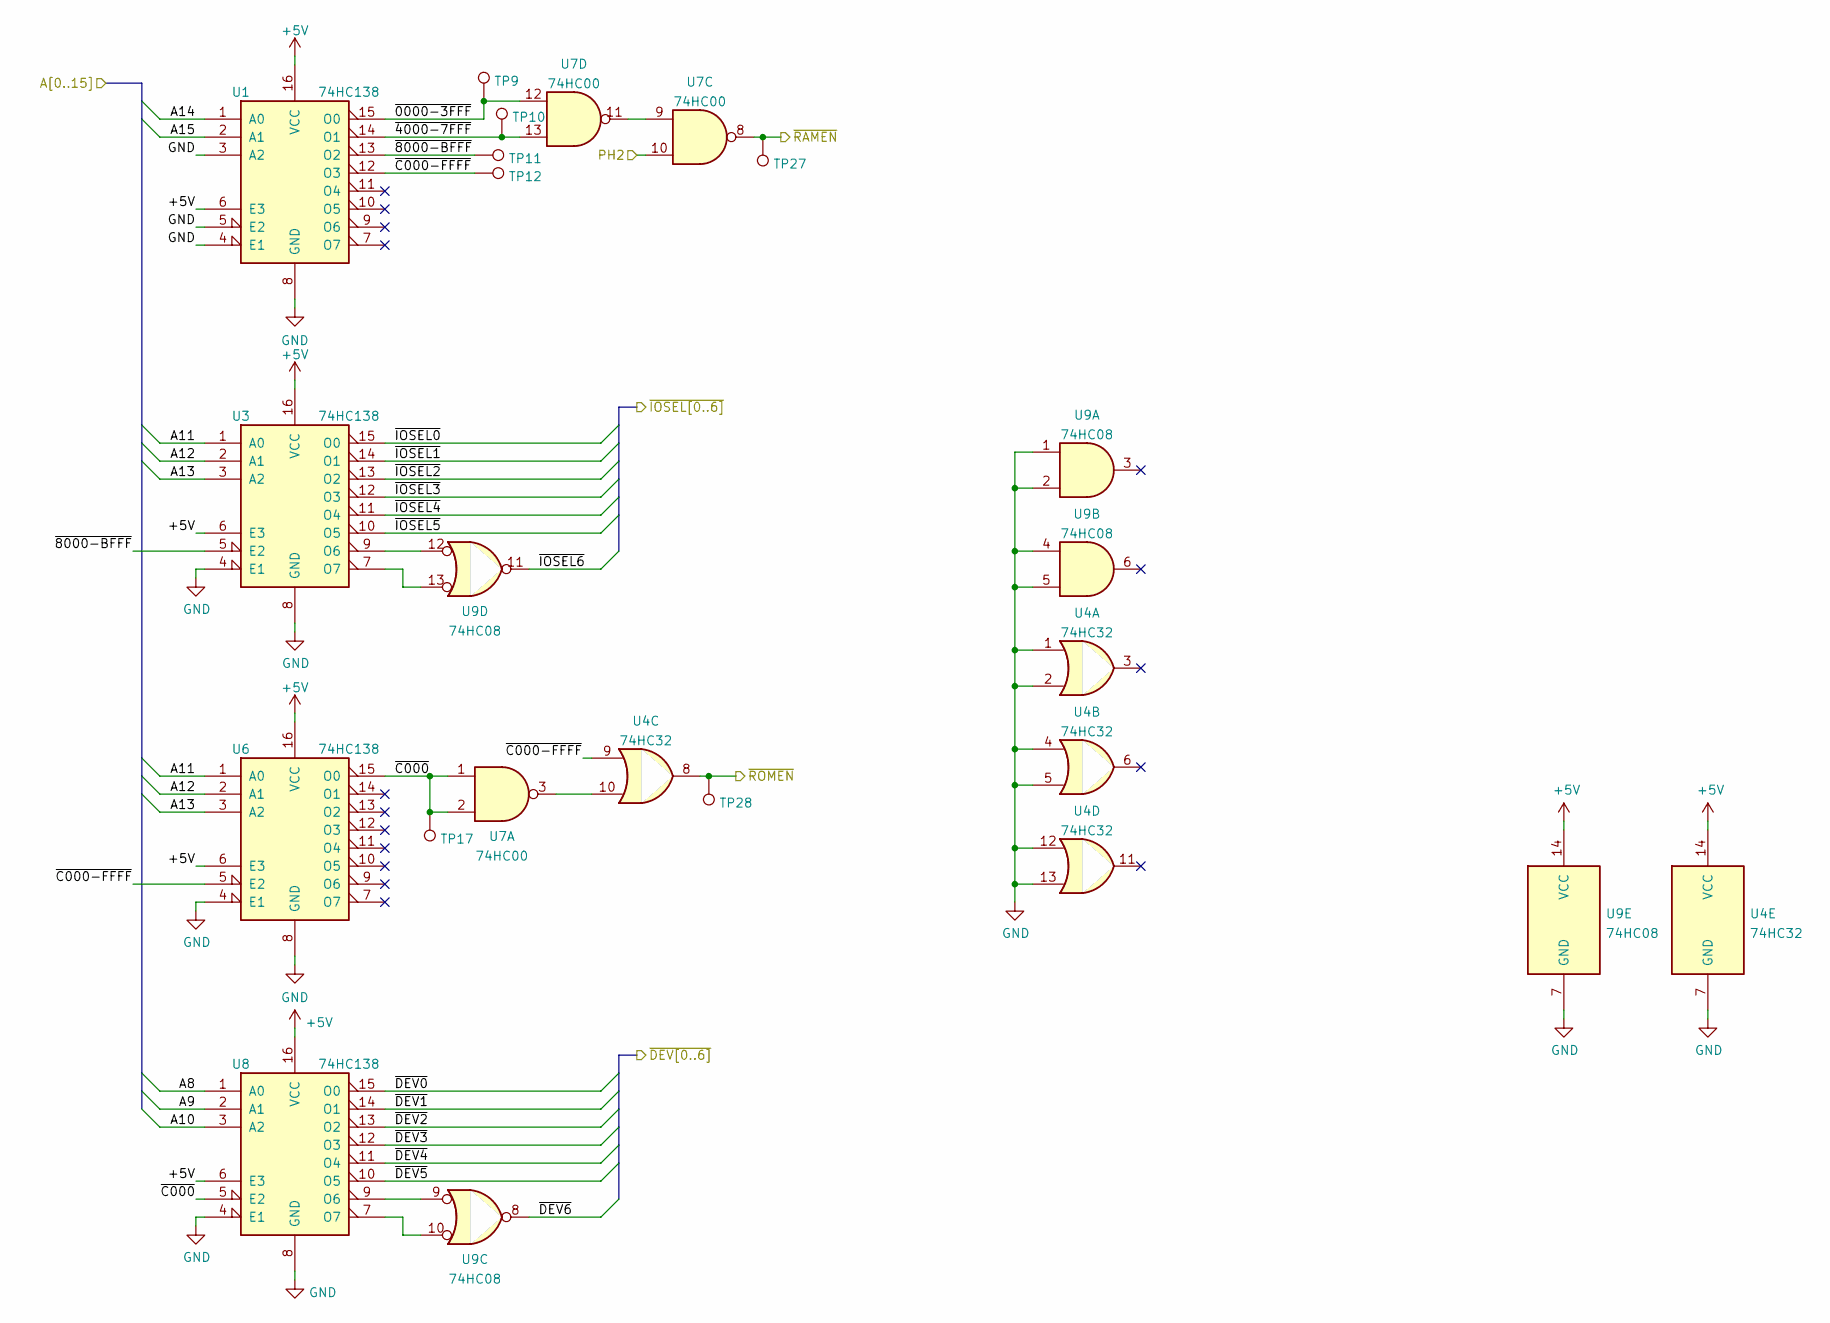
[picture p28: schematic AddressDecode.kicad_sch]

Parts:
TP9, TP10, TP11, TP12, TP17, TP27, TP28: TestPoint; TestPoint_THTPad_D1.5mm_Drill0.7mm
U1, U3, U6, U8: 74HC138; SOIC-16_3.9x9.9mm_P1.27mm; MPN SN74HC138N
U4: 74HC32; SOIC-14_3.9x8.7mm_P1.27mm
U7: 74HC00; SOIC-14_3.9x8.7mm_P1.27mm
U9: 74HC08; SOIC-14_3.9x8.7mm_P1.27mm

Connections:
+5V: U1.6 (E3), U1.16 (VCC), U3.6 (E3), U3.16 (VCC), U4.14 (VCC), U6.6 (E3), U6.16 (VCC), U8.6 (E3), U8.16 (VCC), U9.14 (VCC); also elsewhere on the board
/A8: U8.1 (A0); also elsewhere on the board
/A9: U8.2 (A1); also elsewhere on the board
/A10: U8.3 (A2); also elsewhere on the board
/A11: U3.1 (A0), U6.1 (A0); also elsewhere on the board
/A12: U3.2 (A1), U6.2 (A1); also elsewhere on the board
/A13: U3.3 (A2), U6.3 (A2); also elsewhere on the board
/A14: U1.1 (A0); also elsewhere on the board
/A15: U1.2 (A1); also elsewhere on the board
/AddressDecode/~0000-3FFF: TP9.1, U1.15 (O0), U7.12
/AddressDecode/~4000-7FFF: TP10.1, U1.14 (O1), U7.13
/AddressDecode/~8000-BFFF: TP11.1, U1.13 (O2), U3.5 (E2)
/AddressDecode/~C000-FFFF: TP12.1, U1.12 (O3), U4.9, U6.5 (E2)
/AddressDecode/~C000: TP17.1, U6.15 (O0), U7.1, U7.2, U8.5 (E2)
/PH2: U7.10; also elsewhere on the board
/~DEV0: U8.15 (O0); also elsewhere on the board
/~DEV1: U8.14 (O1); also elsewhere on the board
/~DEV2: U8.13 (O2); also elsewhere on the board
/~DEV3: U8.12 (O3); also elsewhere on the board
/~DEV4: U8.11 (O4); also elsewhere on the board
/~DEV5: U8.10 (O5); also elsewhere on the board
/~DEV6: U9.8; also elsewhere on the board
/~IOSEL0: U3.15 (O0); also elsewhere on the board
/~IOSEL1: U3.14 (O1); also elsewhere on the board
/~IOSEL2: U3.13 (O2); also elsewhere on the board
/~IOSEL3: U3.12 (O3); also elsewhere on the board
/~IOSEL4: U3.11 (O4); also elsewhere on the board
/~IOSEL5: U3.10 (O5); also elsewhere on the board
/~IOSEL6: U9.11; also elsewhere on the board
/~RAMEN: TP27.1, U7.8; also elsewhere on the board
/~ROMEN: TP28.1, U4.8; also elsewhere on the board
GND: U1.3 (A2), U1.4 (E1), U1.5 (E2), U1.8 (GND), U3.4 (E1), U3.8 (GND), U4.1, U4.2, U4.4, U4.5, U4.7 (GND), U4.12, U4.13, U6.4 (E1), U6.8 (GND), U8.4 (E1), U8.8 (GND), U9.1, U9.2, U9.4, U9.5, U9.7 (GND); also elsewhere on the board
unnamed: U3.7 (O7), U9.13
unnamed: U3.9 (O6), U9.12
unnamed: U4.10, U7.3
unnamed: U7.9, U7.11
unnamed: U8.7 (O7), U9.10
unnamed: U8.9 (O6), U9.9

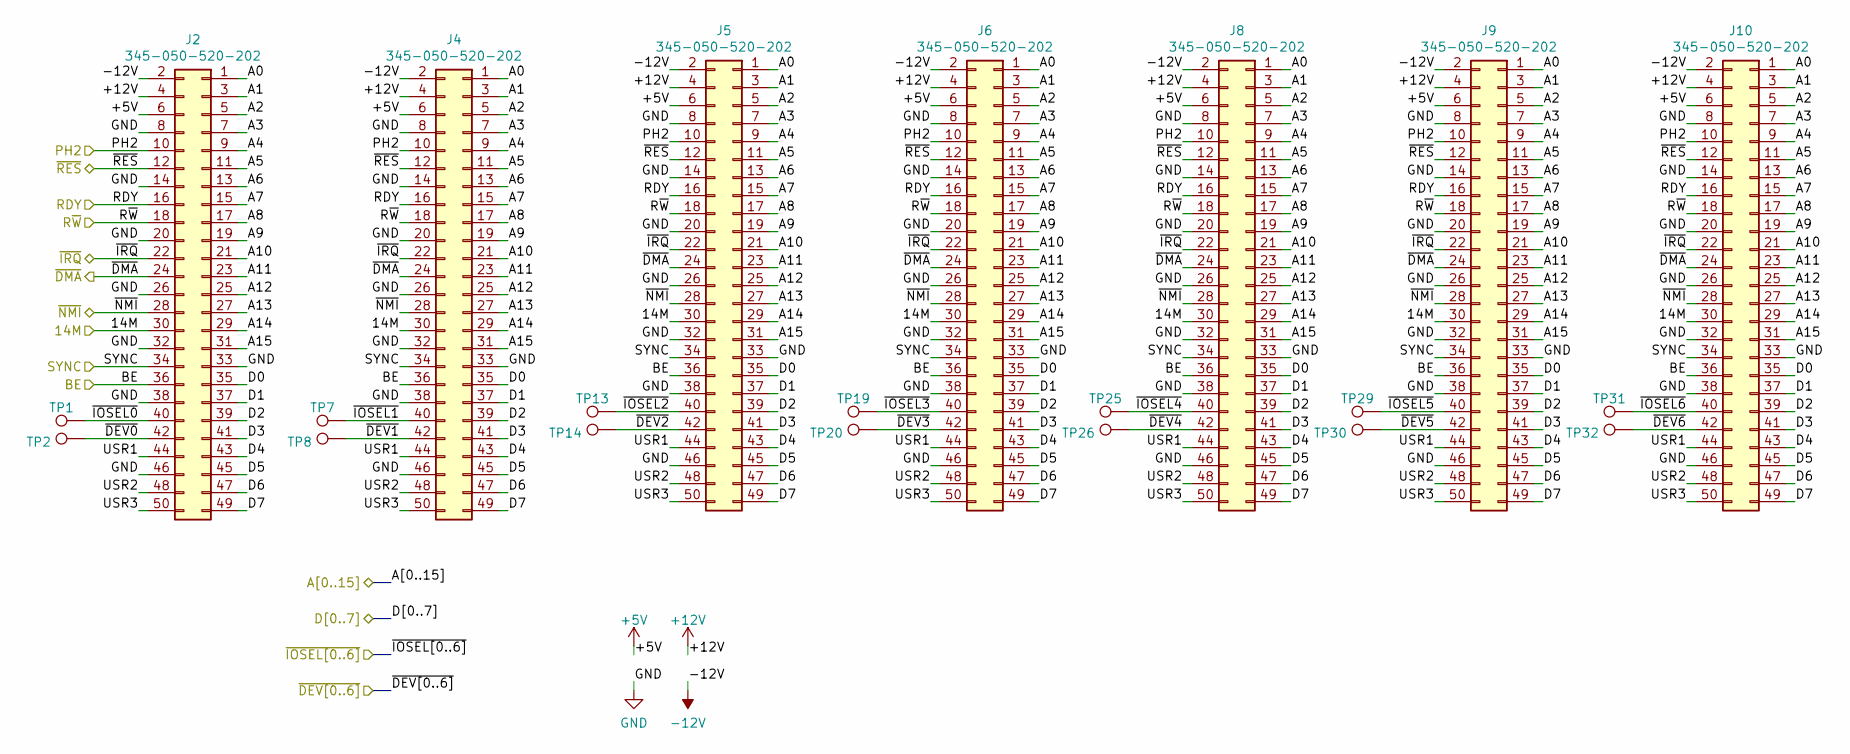
[picture p29: schematic Expansion.kicad_sch]

Parts:
J2, J4, J5, J6, J8, J9, J10: 345-050-520-202; EDAC_345-050-520-202; MPN 345-050-520-202
TP1, TP2, TP7, TP8, TP13, TP14, TP19, TP20, TP25, TP26, TP29, TP30, TP31, TP32: TestPoint; TestPoint_THTPad_D1.5mm_Drill0.7mm

Connections:
+5V: J2.6, J4.6, J5.6, J6.6, J8.6, J9.6, J10.6; also elsewhere on the board
+12V: J2.4, J4.4, J5.4, J6.4, J8.4, J9.4, J10.4; also elsewhere on the board
-12V: J2.2, J4.2, J5.2, J6.2, J8.2, J9.2, J10.2; also elsewhere on the board
/14M: J2.30, J4.30, J5.30, J6.30, J8.30, J9.30, J10.30; also elsewhere on the board
/A0: J2.1, J4.1, J5.1, J6.1, J8.1, J9.1, J10.1; also elsewhere on the board
/A1: J2.3, J4.3, J5.3, J6.3, J8.3, J9.3, J10.3; also elsewhere on the board
/A2: J2.5, J4.5, J5.5, J6.5, J8.5, J9.5, J10.5; also elsewhere on the board
/A3: J2.7, J4.7, J5.7, J6.7, J8.7, J9.7, J10.7; also elsewhere on the board
/A4: J2.9, J4.9, J5.9, J6.9, J8.9, J9.9, J10.9; also elsewhere on the board
/A5: J2.11, J4.11, J5.11, J6.11, J8.11, J9.11, J10.11; also elsewhere on the board
/A6: J2.13, J4.13, J5.13, J6.13, J8.13, J9.13, J10.13; also elsewhere on the board
/A7: J2.15, J4.15, J5.15, J6.15, J8.15, J9.15, J10.15; also elsewhere on the board
/A8: J2.17, J4.17, J5.17, J6.17, J8.17, J9.17, J10.17; also elsewhere on the board
/A9: J2.19, J4.19, J5.19, J6.19, J8.19, J9.19, J10.19; also elsewhere on the board
/A10: J2.21, J4.21, J5.21, J6.21, J8.21, J9.21, J10.21; also elsewhere on the board
/A11: J2.23, J4.23, J5.23, J6.23, J8.23, J9.23, J10.23; also elsewhere on the board
/A12: J2.25, J4.25, J5.25, J6.25, J8.25, J9.25, J10.25; also elsewhere on the board
/A13: J2.27, J4.27, J5.27, J6.27, J8.27, J9.27, J10.27; also elsewhere on the board
/A14: J2.29, J4.29, J5.29, J6.29, J8.29, J9.29, J10.29; also elsewhere on the board
/A15: J2.31, J4.31, J5.31, J6.31, J8.31, J9.31, J10.31; also elsewhere on the board
/BE: J2.36, J4.36, J5.36, J6.36, J8.36, J9.36, J10.36; also elsewhere on the board
/D0: J2.35, J4.35, J5.35, J6.35, J8.35, J9.35, J10.35; also elsewhere on the board
/D1: J2.37, J4.37, J5.37, J6.37, J8.37, J9.37, J10.37; also elsewhere on the board
/D2: J2.39, J4.39, J5.39, J6.39, J8.39, J9.39, J10.39; also elsewhere on the board
/D3: J2.41, J4.41, J5.41, J6.41, J8.41, J9.41, J10.41; also elsewhere on the board
/D4: J2.43, J4.43, J5.43, J6.43, J8.43, J9.43, J10.43; also elsewhere on the board
/D5: J2.45, J4.45, J5.45, J6.45, J8.45, J9.45, J10.45; also elsewhere on the board
/D6: J2.47, J4.47, J5.47, J6.47, J8.47, J9.47, J10.47; also elsewhere on the board
/D7: J2.49, J4.49, J5.49, J6.49, J8.49, J9.49, J10.49; also elsewhere on the board
/Expansion/USR1: J2.44, J4.44, J5.44, J6.44, J8.44, J9.44, J10.44
/Expansion/USR2: J2.48, J4.48, J5.48, J6.48, J8.48, J9.48, J10.48
/Expansion/USR3: J2.50, J4.50, J5.50, J6.50, J8.50, J9.50, J10.50
/PH2: J2.10, J4.10, J5.10, J6.10, J8.10, J9.10, J10.10; also elsewhere on the board
/RDY: J2.16, J4.16, J5.16, J6.16, J8.16, J9.16, J10.16; also elsewhere on the board
/R~W: J2.18, J4.18, J5.18, J6.18, J8.18, J9.18, J10.18; also elsewhere on the board
/SYNC: J2.34, J4.34, J5.34, J6.34, J8.34, J9.34, J10.34; also elsewhere on the board
/~DEV0: J2.42, TP2.1; also elsewhere on the board
/~DEV1: J4.42, TP8.1; also elsewhere on the board
/~DEV2: J5.42, TP14.1; also elsewhere on the board
/~DEV3: J6.42, TP20.1; also elsewhere on the board
/~DEV4: J8.42, TP26.1; also elsewhere on the board
/~DEV5: J9.42, TP30.1; also elsewhere on the board
/~DEV6: J10.42, TP32.1; also elsewhere on the board
/~DMA: J2.24, J4.24, J5.24, J6.24, J8.24, J9.24, J10.24; also elsewhere on the board
/~IOSEL0: J2.40, TP1.1; also elsewhere on the board
/~IOSEL1: J4.40, TP7.1; also elsewhere on the board
/~IOSEL2: J5.40, TP13.1; also elsewhere on the board
/~IOSEL3: J6.40, TP19.1; also elsewhere on the board
/~IOSEL4: J8.40, TP25.1; also elsewhere on the board
/~IOSEL5: J9.40, TP29.1; also elsewhere on the board
/~IOSEL6: J10.40, TP31.1; also elsewhere on the board
/~IRQ: J2.22, J4.22, J5.22, J6.22, J8.22, J9.22, J10.22; also elsewhere on the board
/~NMI: J2.28, J4.28, J5.28, J6.28, J8.28, J9.28, J10.28; also elsewhere on the board
/~RES: J2.12, J4.12, J5.12, J6.12, J8.12, J9.12, J10.12; also elsewhere on the board
GND: J2.8, J2.14, J2.20, J2.26, J2.32, J2.33, J2.38, J2.46, J4.8, J4.14, J4.20, J4.26, J4.32, J4.33, J4.38, J4.46, J5.8, J5.14, J5.20, J5.26, J5.32, J5.33, J5.38, J5.46, J6.8, J6.14, J6.20, J6.26, J6.32, J6.33, J6.38, J6.46, J8.8, J8.14, J8.20, J8.26, J8.32, J8.33, J8.38, J8.46, J9.8, J9.14, J9.20, J9.26, J9.32, J9.33, J9.38, J9.46, J10.8, J10.14, J10.20, J10.26, J10.32, J10.33, J10.38, J10.46; also elsewhere on the board

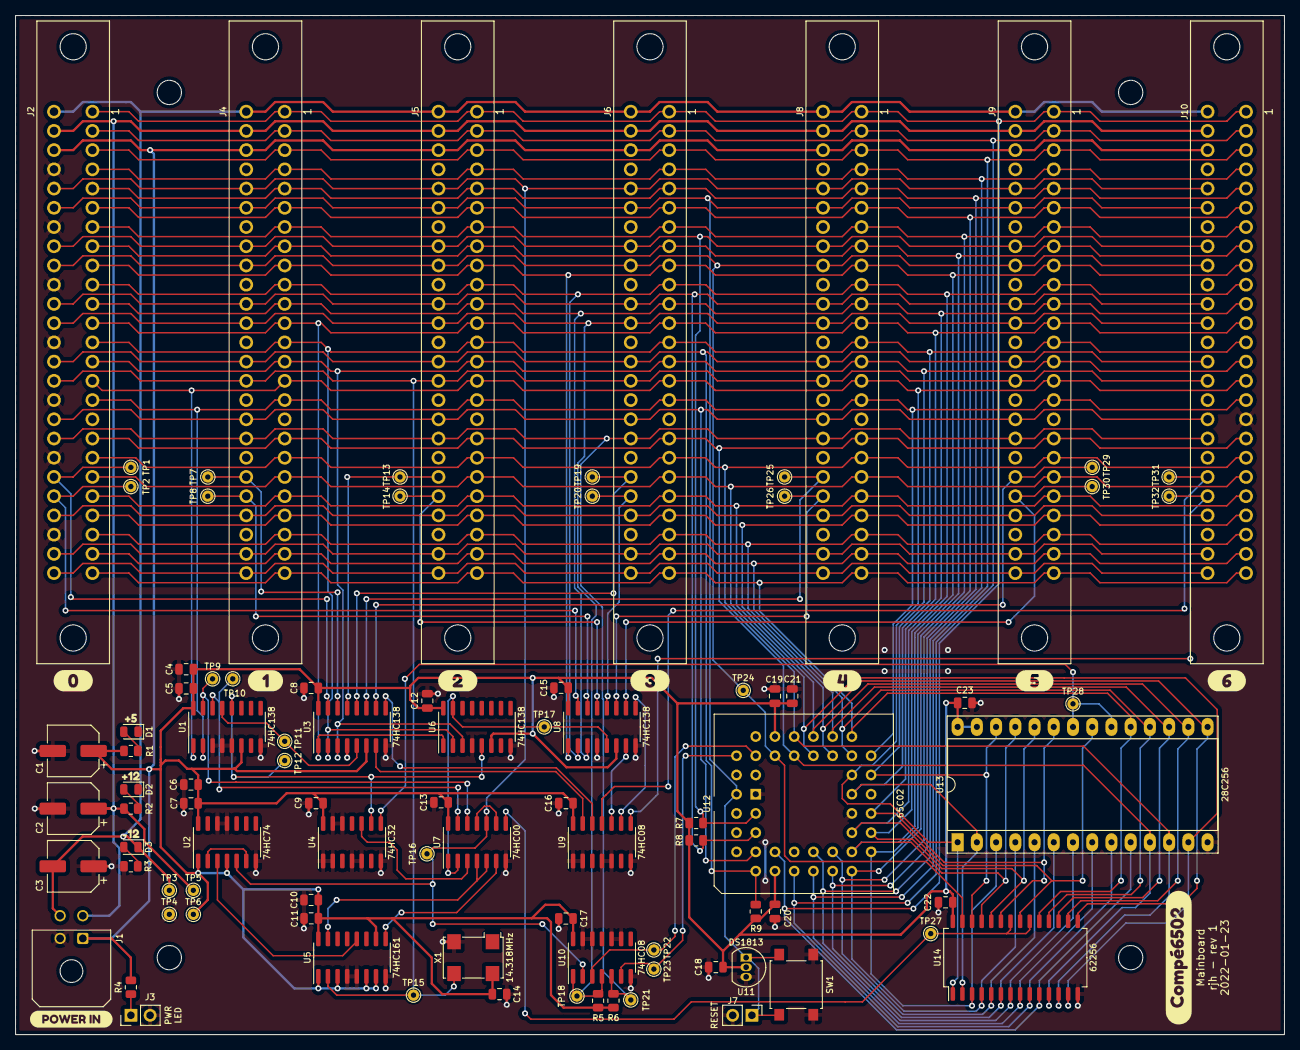
[picture p30: board motherboard.kicad_pcb from above]

Board: 2 copper layers, 167.6 x 134.6 mm, 110 parts (1 on the bottom side), 78 nets.

Other parts of the board:
kibuzzard-1: G***; kibuzzard-61E47B61
kibuzzard-2: G***; kibuzzard-61E4A308
kibuzzard-3: G***; kibuzzard-61E48162
kibuzzard-4: G***; kibuzzard-61E4816D
kibuzzard-5: G***; kibuzzard-61E48181
kibuzzard-6: G***; kibuzzard-61E47B68
kibuzzard-7: G***; kibuzzard-61E47B6E
kibuzzard-8: G***; kibuzzard-61E47B74
kibuzzard-9: G***; kibuzzard-61E47B79
kibuzzard-10: G***; kibuzzard-61E47B7F
kibuzzard-11, kibuzzard-13: G***; kibuzzard-61E4DE7F
kibuzzard-12: G***; kibuzzard-61E47B85
