rjhelms/compe6502/Hardware/sd_panel/sd_panel.kicad_pcb

## KiCad design Hardware/sd_panel/sd_panel.kicad_pcb (2022-02-02)

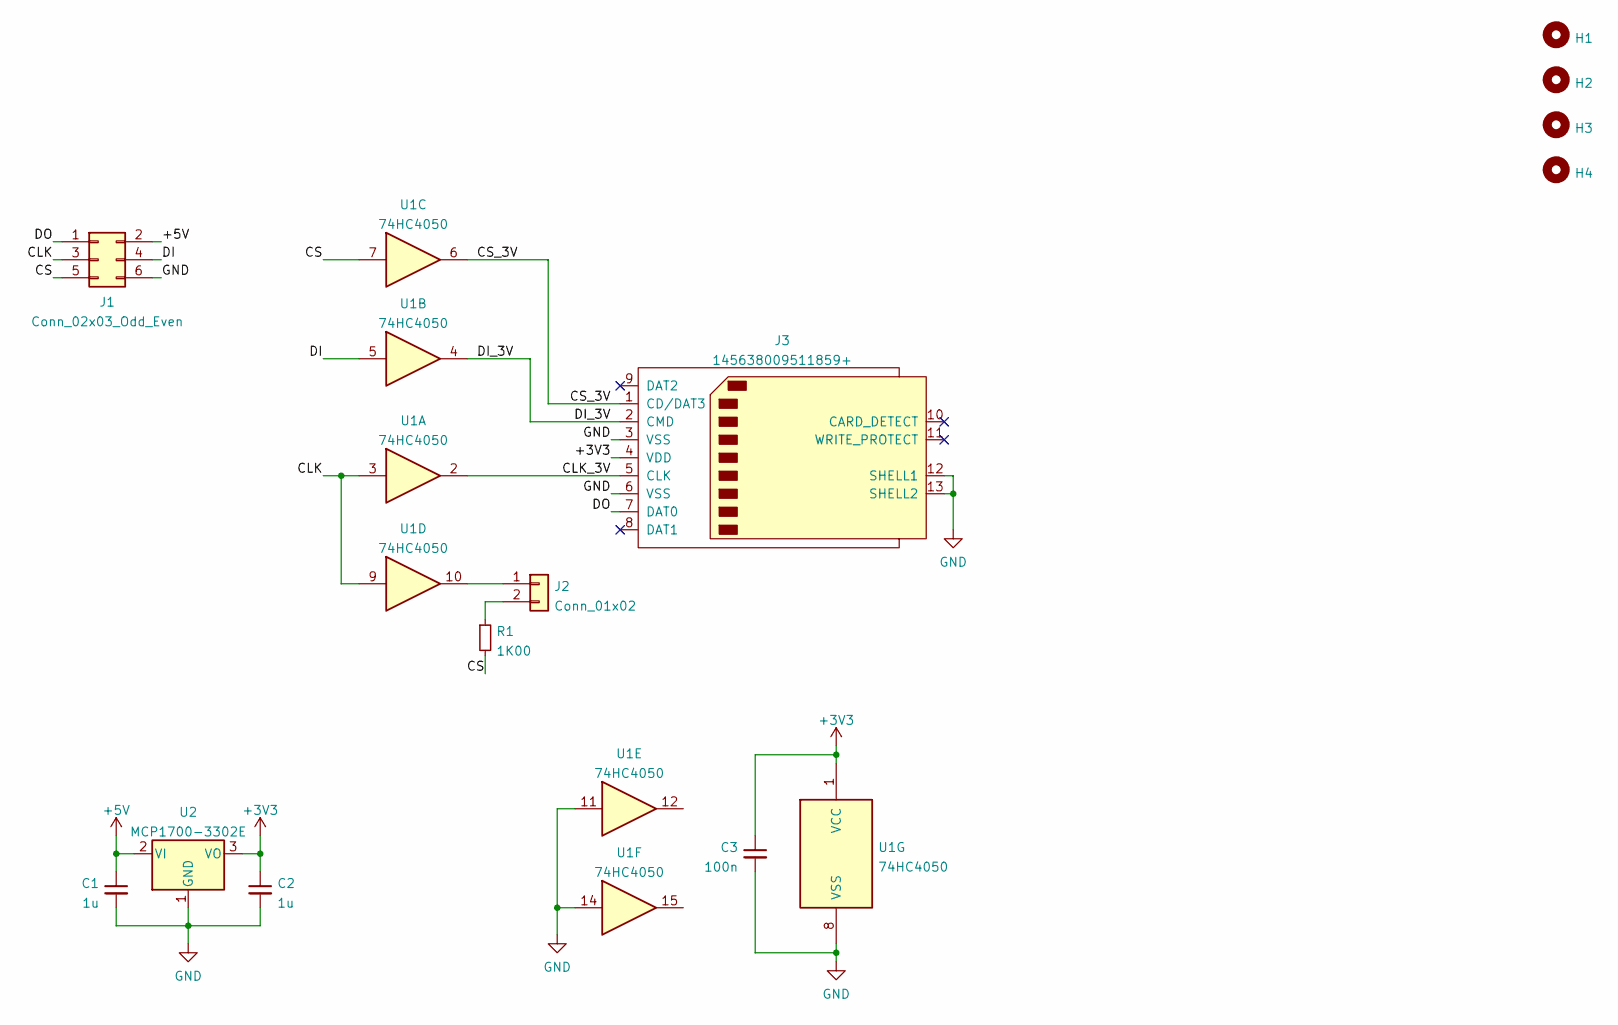
[picture p31: schematic sd_panel.kicad_sch, Compe6502 SD Breakout]

Parts:
C1, C2: 1u; C_0805_2012Metric
C3: 100n; C_0805_2012Metric
H1, H2, H3, H4: MountingHole; MountingHole_3.2mm_M3
J1: Conn_02x03_Odd_Even; PinHeader_2x03_P2.54mm_Vertical
J2: Conn_01x02; PinHeader_1x02_P2.54mm_Vertical
J3: 145638009511859+; SD_Kyocera_145638009511859+
R1: 1K00; R_0805_2012Metric
U1: 74HC4050; SOIC-16_3.9x9.9mm_P1.27mm
U2: MCP1700-3302E; SOT-23

Connections:
+3V3: C2.1, C3.1, J3.4 (VDD), U1.1 (VCC), U2.3 (VO)
+5V: C1.1, J1.2, U2.2 (VI)
/CLK: J1.3, U1.3, U1.9
/CLK_3V: J3.5 (CLK), U1.2
/CS: J1.5, R1.2, U1.7
/CS_3V: J3.1 (CD/DAT3), U1.6
/DI: J1.4, U1.5
/DI_3V: J3.2 (CMD), U1.4
/DO: J1.1, J3.7 (DAT0)
GND: C1.2, C2.2, C3.2, J1.6, J3.3 (VSS), J3.6 (VSS), J3.12 (SHELL1), J3.13 (SHELL2), U1.8 (VSS), U1.11, U1.14, U2.1 (GND)
unnamed: J2.2, R1.1
unnamed: J2.1, U1.10

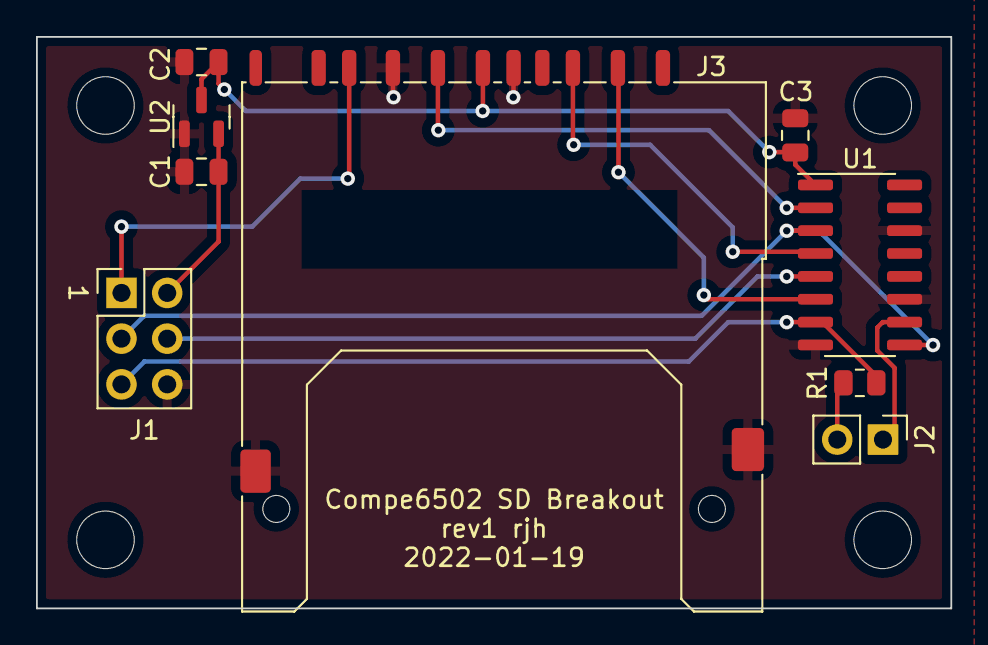
[picture p32: board sd_panel.kicad_pcb from above]

Board: 2 copper layers, 50.8 x 31.8 mm, 13 parts (0 on the bottom side), 12 nets.
