rjhelms/compe6502/Hardware/video_ribbons/video_ribbons.kicad_pcb

## KiCad design Hardware/video_ribbons/video_ribbons.kicad_pcb (2022-01-03)

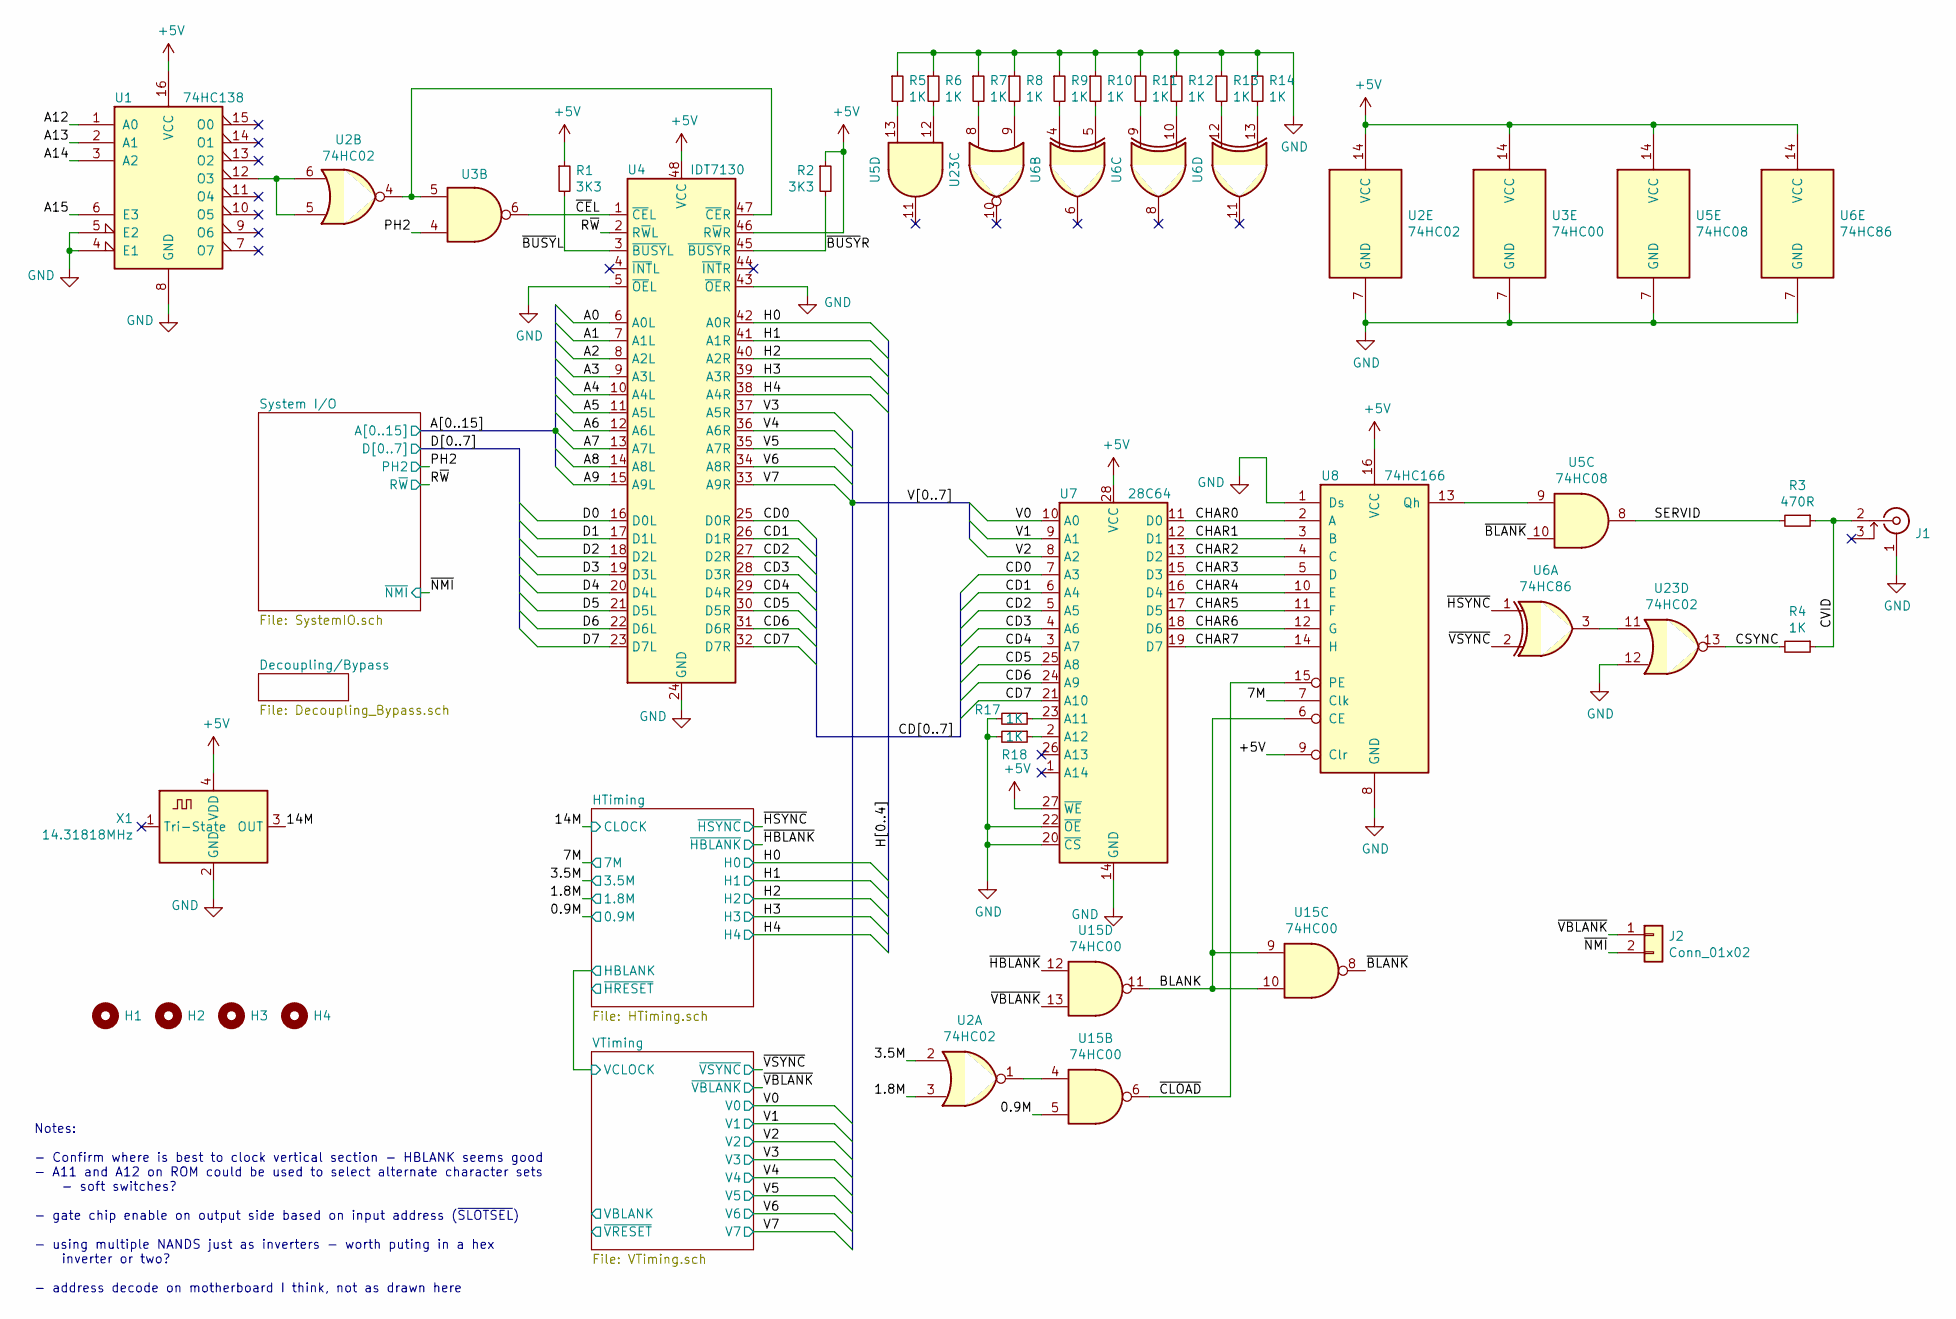
[picture p33: schematic video_ribbons.sch, 74 Character Generator (Ribbon cable)]

Parts:
H1, H2, H3, H4: MountingHole; MountingHole_3.2mm_M3
J1: Conn_Coaxial_Sleeve_Pin2Tip; Jack_RCA_Switchcraft_PJRAN1X1UxxX
J2: Conn_01x02; PinHeader_1x02_P2.54mm_Vertical
R1, R2: 3K3; R_0805_2012Metric
R3: 470R; R_0805_2012Metric
R4, R5, R6, R7, R8, R9, R10, R11, R12, R13, R14, R17, R18: 1K; R_0805_2012Metric
U1: 74HC138; SOIC-16_3.9x9.9mm_P1.27mm
U2, U23: 74HC02; SOIC-14_3.9x8.7mm_P1.27mm
U3, U15: 74HC00; SOIC-14_3.9x8.7mm_P1.27mm
U4: IDT7130; DIP-48_W15.24mm_Socket_LongPads
U5: 74HC08; SOIC-14_3.9x8.7mm_P1.27mm
U6: 74HC86; SOIC-14_3.9x8.7mm_P1.27mm
U7: 28C64; DIP-28_W15.24mm_Socket_LongPads
U8: 74HC166; SOIC-16_3.9x9.9mm_P1.27mm
X1: 14.31818MHz; Oscillator_SMD_IQD_IQXO70-4Pin_7.5x5.0mm

Connections:
+5V: R1.1, R2.1, U1.16 (VCC), U2.14 (VCC), U3.14 (VCC), U4.46 (R~W~R), U4.48 (VCC), U5.14 (VCC), U6.14 (VCC), U7.27 (~WE), U7.28 (VCC), U8.9 (Clr), U8.16 (VCC), X1.4 (VDD); also elsewhere on the board
/0.9M: U15.5; also elsewhere on the board
/1.8M: U2.3; also elsewhere on the board
/3.5M: U2.2; also elsewhere on the board
/7M: U8.7 (Clk); also elsewhere on the board
/14M: X1.3 (OUT); also elsewhere on the board
/A0: U4.6 (A0L); also elsewhere on the board
/A1: U4.7 (A1L); also elsewhere on the board
/A2: U4.8 (A2L); also elsewhere on the board
/A3: U4.9 (A3L); also elsewhere on the board
/A4: U4.10 (A4L); also elsewhere on the board
/A5: U4.11 (A5L); also elsewhere on the board
/A6: U4.12 (A6L); also elsewhere on the board
/A7: U4.13 (A7L); also elsewhere on the board
/A8: U4.14 (A8L); also elsewhere on the board
/A9: U4.15 (A9L); also elsewhere on the board
/A12: U1.1 (A0); also elsewhere on the board
/A13: U1.2 (A1); also elsewhere on the board
/A14: U1.3 (A2); also elsewhere on the board
/A15: U1.6 (E3); also elsewhere on the board
/BLANK: U8.6 (CE), U15.9, U15.10, U15.11
/CD0: U4.25 (D0R), U7.7 (A3)
/CD1: U4.26 (D1R), U7.6 (A4)
/CD2: U4.27 (D2R), U7.5 (A5)
/CD3: U4.28 (D3R), U7.4 (A6)
/CD4: U4.29 (D4R), U7.3 (A7)
/CD5: U4.30 (D5R), U7.25 (A8)
/CD6: U4.31 (D6R), U7.24 (A9)
/CD7: U4.32 (D7R), U7.21 (A10)
/CHAR0: U7.11 (D0), U8.2 (A)
/CHAR1: U7.12 (D1), U8.3 (B)
/CHAR2: U7.13 (D2), U8.4 (C)
/CHAR3: U7.15 (D3), U8.5 (D)
/CHAR4: U7.16 (D4), U8.10 (E)
/CHAR5: U7.17 (D5), U8.11 (F)
/CHAR6: U7.18 (D6), U8.12 (G)
/CHAR7: U7.19 (D7), U8.14 (H)
/CSYNC: R4.2, U23.13
/CVID: J1.2 (In), R3.1, R4.1
/D0: U4.16 (D0L); also elsewhere on the board
/D1: U4.17 (D1L); also elsewhere on the board
/D2: U4.18 (D2L); also elsewhere on the board
/D3: U4.19 (D3L); also elsewhere on the board
/D4: U4.20 (D4L); also elsewhere on the board
/D5: U4.21 (D5L); also elsewhere on the board
/D6: U4.22 (D6L); also elsewhere on the board
/D7: U4.23 (D7L); also elsewhere on the board
/H0: U4.42 (A0R); also elsewhere on the board
/H1: U4.41 (A1R); also elsewhere on the board
/H2: U4.40 (A2R); also elsewhere on the board
/H3: U4.39 (A3R); also elsewhere on the board
/H4: U4.38 (A4R); also elsewhere on the board
/PH2: U3.4; also elsewhere on the board
/R~W: U4.2 (R~W~L); also elsewhere on the board
/SERVID: R3.2, U5.8
/V0: U7.10 (A0); also elsewhere on the board
/V1: U7.9 (A1); also elsewhere on the board
/V2: U7.8 (A2); also elsewhere on the board
/V3: U4.37 (A5R); also elsewhere on the board
/V4: U4.36 (A6R); also elsewhere on the board
/V5: U4.35 (A7R); also elsewhere on the board
/V6: U4.34 (A8R); also elsewhere on the board
/V7: U4.33 (A9R); also elsewhere on the board
/~BLANK: U5.10, U15.8
/~BUSY~L: R1.2, U4.3 (~BUSY~L)
/~BUSY~R: R2.2, U4.45 (~BUSY~R)
/~CE~L: U3.6, U4.1 (~CE~L)
/~CLOAD: U8.15 (PE), U15.6
/~HBLANK: U15.12; also elsewhere on the board
/~HSYNC: U6.1; also elsewhere on the board
/~NMI: J2.2; also elsewhere on the board
/~VBLANK: J2.1, U15.13; also elsewhere on the board
/~VSYNC: U6.2; also elsewhere on the board
GND: J1.1 (Ext), R5.1, R6.1, R7.1, R8.1, R9.1, R10.1, R11.1, R12.1, R13.1, R14.1, R17.2, R18.2, U1.4 (E1), U1.5 (E2), U1.8 (GND), U2.7 (GND), U3.7 (GND), U4.5 (~OE~L), U4.24 (GND), U4.43 (~OE~R), U5.7 (GND), U6.7 (GND), U7.14 (GND), U7.20 (~CS), U7.22 (~OE), U8.1 (Ds), U8.8 (GND), U23.12, X1.2 (GND); also elsewhere on the board
unnamed: R5.2, U5.13
unnamed: R6.2, U5.12
unnamed: R7.2, U23.8
unnamed: R8.2, U23.9
unnamed: R9.2, U6.4
unnamed: R10.2, U6.5
unnamed: R11.2, U6.9
unnamed: R12.2, U6.10
unnamed: R13.2, U6.12
unnamed: R14.2, U6.13
unnamed: R17.1, U7.23 (A11)
unnamed: R18.1, U7.2 (A12)
unnamed: U1.12 (O3), U2.5, U2.6
unnamed: U2.4, U3.5, U4.47 (~CE~R)
unnamed: U5.9, U8.13 (Qh)
unnamed: U2.1, U15.4
unnamed: U6.3, U23.11

Notes on the sheet:
Notes: - Confirm where is best to clock vertical section - HBLANK seems good - A11 and A12 on ROM could be used to select alternate character sets - soft switches? - gate chip enable on output side based on input address (~SLOTSEL~) - using multiple NANDS just as inverters - worth puting in a hex i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

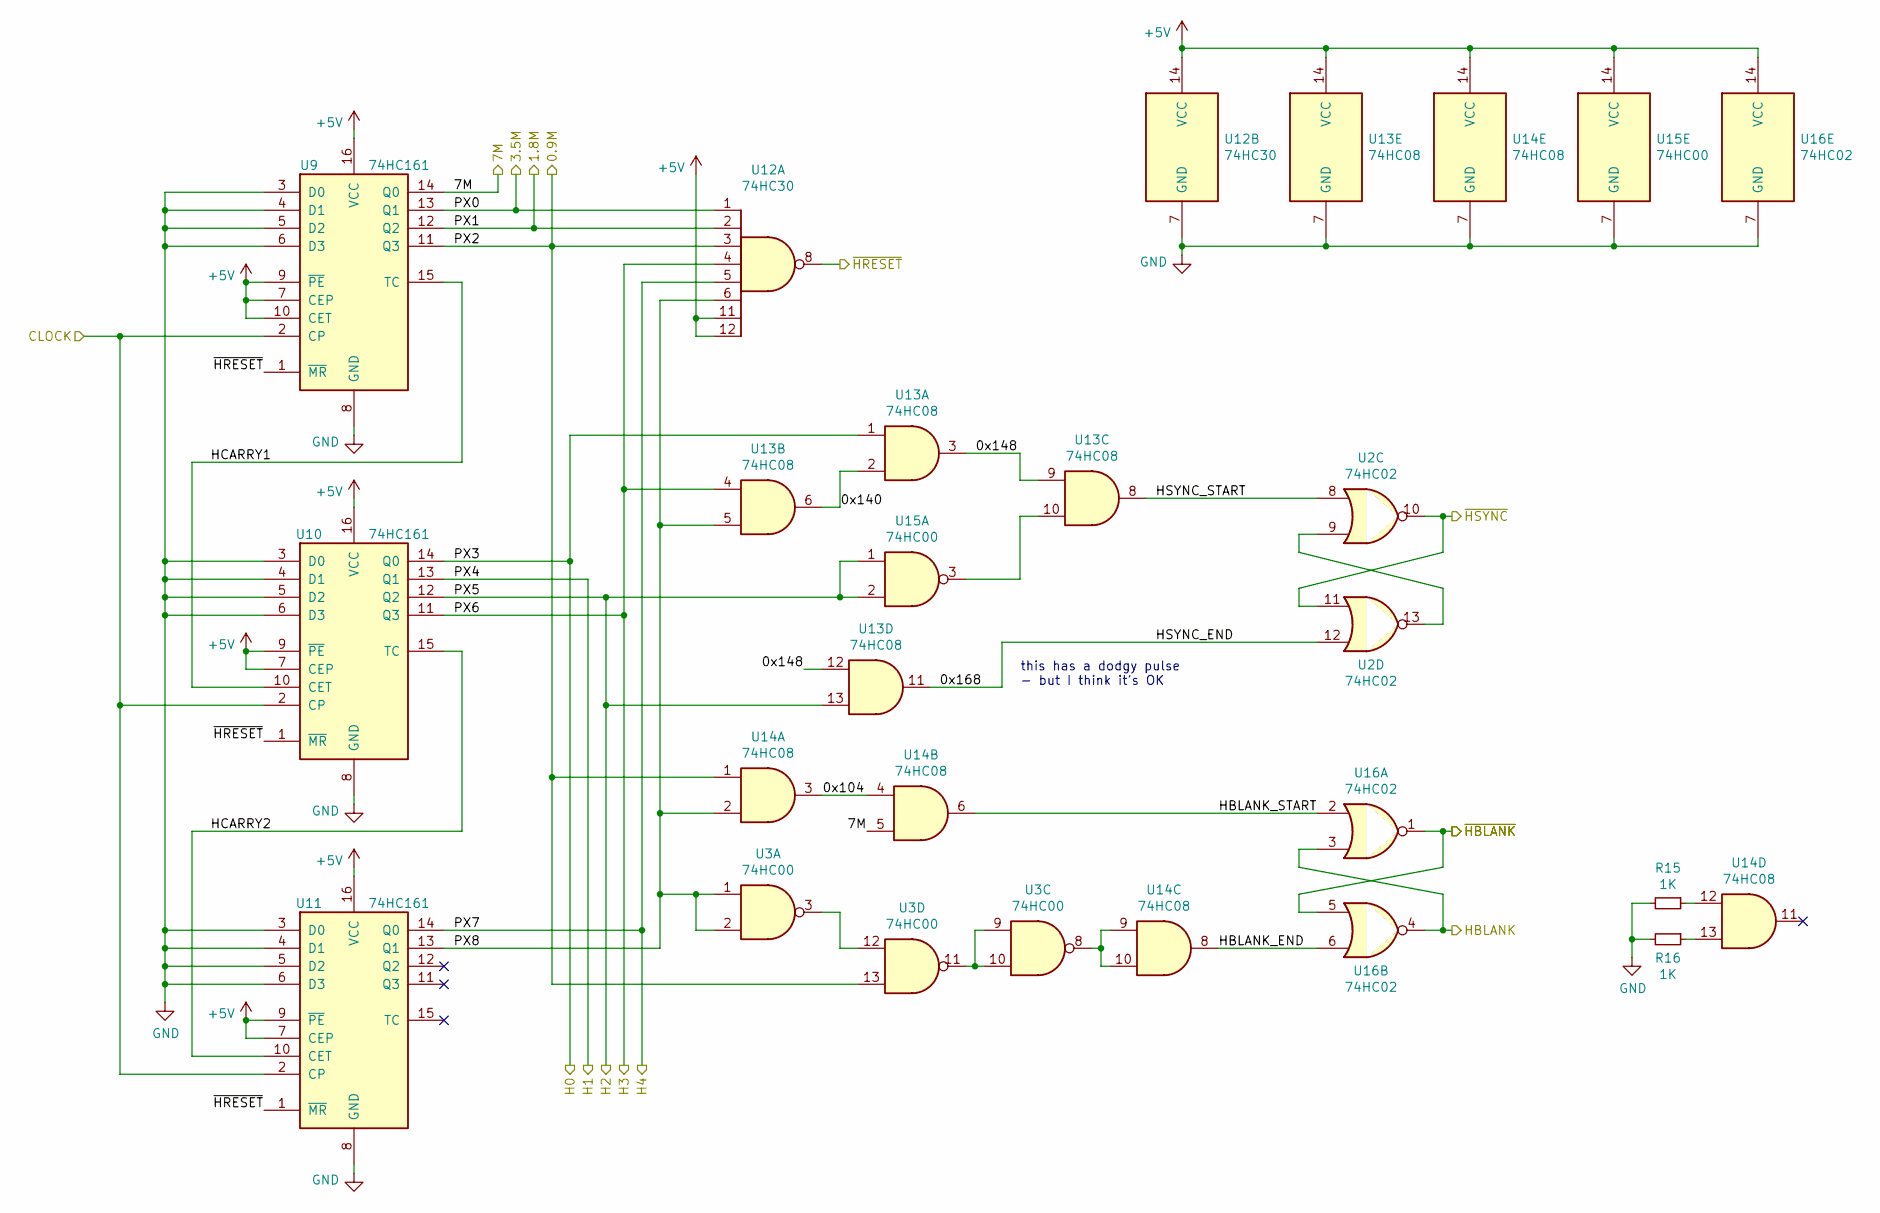
[picture p34: schematic HTiming.sch, Horizontal Timing]

Parts:
R15, R16: 1K; R_0805_2012Metric
U2, U16: 74HC02; SOIC-14_3.9x8.7mm_P1.27mm
U3, U15: 74HC00; SOIC-14_3.9x8.7mm_P1.27mm
U9, U10, U11: 74HC161; SOIC-16_3.9x9.9mm_P1.27mm
U12: 74HC30; SOIC-14_3.9x8.7mm_P1.27mm
U13, U14: 74HC08; SOIC-14_3.9x8.7mm_P1.27mm

Connections:
+5V: U9.7 (CEP), U9.9 (~PE), U9.10 (CET), U9.16 (VCC), U10.7 (CEP), U10.9 (~PE), U10.16 (VCC), U11.7 (CEP), U11.9 (~PE), U11.16 (VCC), U12.11, U12.12, U12.14 (VCC), U13.14 (VCC), U14.14 (VCC), U15.14 (VCC), U16.14 (VCC); also elsewhere on the board
/0.9M: U3.13, U9.11 (Q3), U12.3, U14.1; also elsewhere on the board
/1.8M: U9.12 (Q2), U12.2; also elsewhere on the board
/3.5M: U9.13 (Q1), U12.1; also elsewhere on the board
/7M: U9.14 (Q0), U14.5; also elsewhere on the board
/14M: U9.2 (CP), U10.2 (CP), U11.2 (CP); also elsewhere on the board
/H0: U10.14 (Q0), U13.1; also elsewhere on the board
/H1: U10.13 (Q1); also elsewhere on the board
/H2: U10.12 (Q2), U13.13, U15.1, U15.2; also elsewhere on the board
/H3: U10.11 (Q3), U12.4, U13.4; also elsewhere on the board
/H4: U11.14 (Q0), U12.5; also elsewhere on the board
/HTiming/0x104: U14.3, U14.4
/HTiming/0x140: U13.2, U13.6
/HTiming/0x148: U13.3, U13.9, U13.12
/HTiming/0x168: U2.12, U13.11
/HTiming/HBLANK: U16.3, U16.4; also elsewhere on the board
/HTiming/HBLANK_END: U14.8, U16.6
/HTiming/HBLANK_START: U14.6, U16.2
/HTiming/HCARRY1: U9.15 (TC), U10.10 (CET)
/HTiming/HCARRY2: U10.15 (TC), U11.10 (CET)
/HTiming/HSYNC_START: U2.8, U13.8
/HTiming/PX8: U3.1, U3.2, U11.13 (Q1), U12.6, U13.5, U14.2
/HTiming/~HRESET: U9.1 (~MR), U10.1 (~MR), U11.1 (~MR), U12.8
/~HBLANK: U16.1, U16.5; also elsewhere on the board
/~HSYNC: U2.10, U2.11; also elsewhere on the board
GND: R15.2, R16.2, U9.3 (D0), U9.4 (D1), U9.5 (D2), U9.6 (D3), U9.8 (GND), U10.3 (D0), U10.4 (D1), U10.5 (D2), U10.6 (D3), U10.8 (GND), U11.3 (D0), U11.4 (D1), U11.5 (D2), U11.6 (D3), U11.8 (GND), U12.7 (GND), U13.7 (GND), U14.7 (GND), U15.7 (GND), U16.7 (GND); also elsewhere on the board
unnamed: R15.1, U14.12
unnamed: R16.1, U14.13
unnamed: U2.9, U2.13
unnamed: U3.9, U3.10, U3.11
unnamed: U3.3, U3.12
unnamed: U13.10, U15.3
unnamed: U3.8, U14.9, U14.10

Notes on the sheet:
this has a dodgy pulse - but I think it's OK

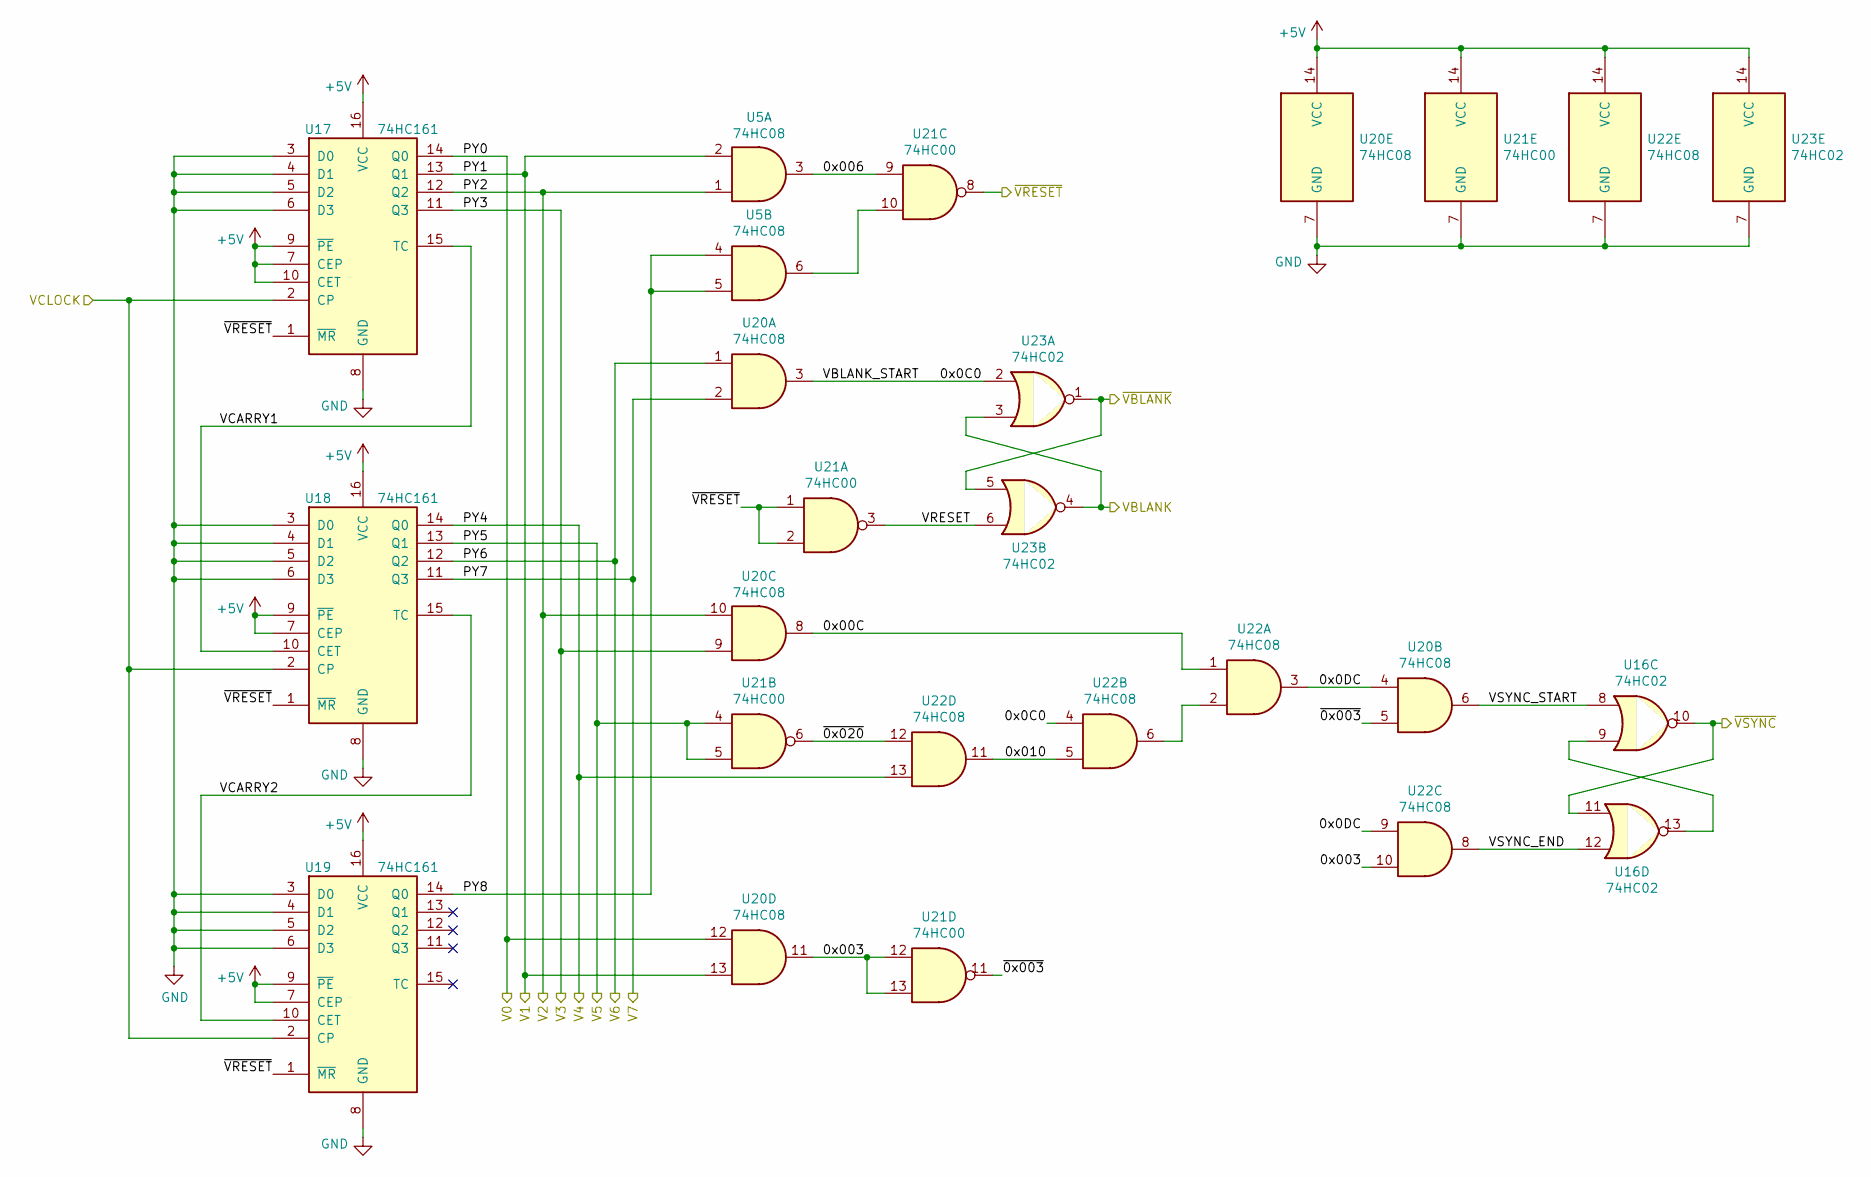
[picture p35: schematic VTiming.sch, Vertical Timing]

Parts:
U5, U20, U22: 74HC08; SOIC-14_3.9x8.7mm_P1.27mm
U16, U23: 74HC02; SOIC-14_3.9x8.7mm_P1.27mm
U17, U18, U19: 74HC161; SOIC-16_3.9x9.9mm_P1.27mm
U21: 74HC00; SOIC-14_3.9x8.7mm_P1.27mm

Connections:
+5V: U17.7 (CEP), U17.9 (~PE), U17.10 (CET), U17.16 (VCC), U18.7 (CEP), U18.9 (~PE), U18.16 (VCC), U19.7 (CEP), U19.9 (~PE), U19.16 (VCC), U20.14 (VCC), U21.14 (VCC), U22.14 (VCC), U23.14 (VCC); also elsewhere on the board
/HTiming/HBLANK: U17.2 (CP), U18.2 (CP), U19.2 (CP); also elsewhere on the board
/V0: U17.14 (Q0), U20.12; also elsewhere on the board
/V1: U5.2, U17.13 (Q1), U20.13; also elsewhere on the board
/V2: U5.1, U17.12 (Q2), U20.10; also elsewhere on the board
/V3: U17.11 (Q3), U20.9; also elsewhere on the board
/V4: U18.14 (Q0), U22.13; also elsewhere on the board
/V5: U18.13 (Q1), U21.4, U21.5; also elsewhere on the board
/V6: U18.12 (Q2), U20.1; also elsewhere on the board
/V7: U18.11 (Q3), U20.2; also elsewhere on the board
/VTiming/0x00C: U20.8, U22.1
/VTiming/0x0C0: U20.3, U22.4, U23.2
/VTiming/0x0DC: U20.4, U22.3, U22.9
/VTiming/0x003: U20.11, U21.12, U21.13, U22.10
/VTiming/0x006: U5.3, U21.9
/VTiming/0x010: U22.5, U22.11
/VTiming/PY8: U5.4, U5.5, U19.14 (Q0)
/VTiming/VBLANK: U23.3, U23.4
/VTiming/VCARRY1: U17.15 (TC), U18.10 (CET)
/VTiming/VCARRY2: U18.15 (TC), U19.10 (CET)
/VTiming/VRESET: U21.3, U23.6
/VTiming/VSYNC_END: U16.12, U22.8
/VTiming/VSYNC_START: U16.8, U20.6
/VTiming/~0x003: U20.5, U21.11
/VTiming/~0x020: U21.6, U22.12
/VTiming/~VRESET: U17.1 (~MR), U18.1 (~MR), U19.1 (~MR), U21.1, U21.2, U21.8
/~VBLANK: U23.1, U23.5; also elsewhere on the board
/~VSYNC: U16.10, U16.11; also elsewhere on the board
GND: U17.3 (D0), U17.4 (D1), U17.5 (D2), U17.6 (D3), U17.8 (GND), U18.3 (D0), U18.4 (D1), U18.5 (D2), U18.6 (D3), U18.8 (GND), U19.3 (D0), U19.4 (D1), U19.5 (D2), U19.6 (D3), U19.8 (GND), U20.7 (GND), U21.7 (GND), U22.7 (GND), U23.7 (GND); also elsewhere on the board
unnamed: U16.9, U16.13
unnamed: U5.6, U21.10
unnamed: U22.2, U22.6

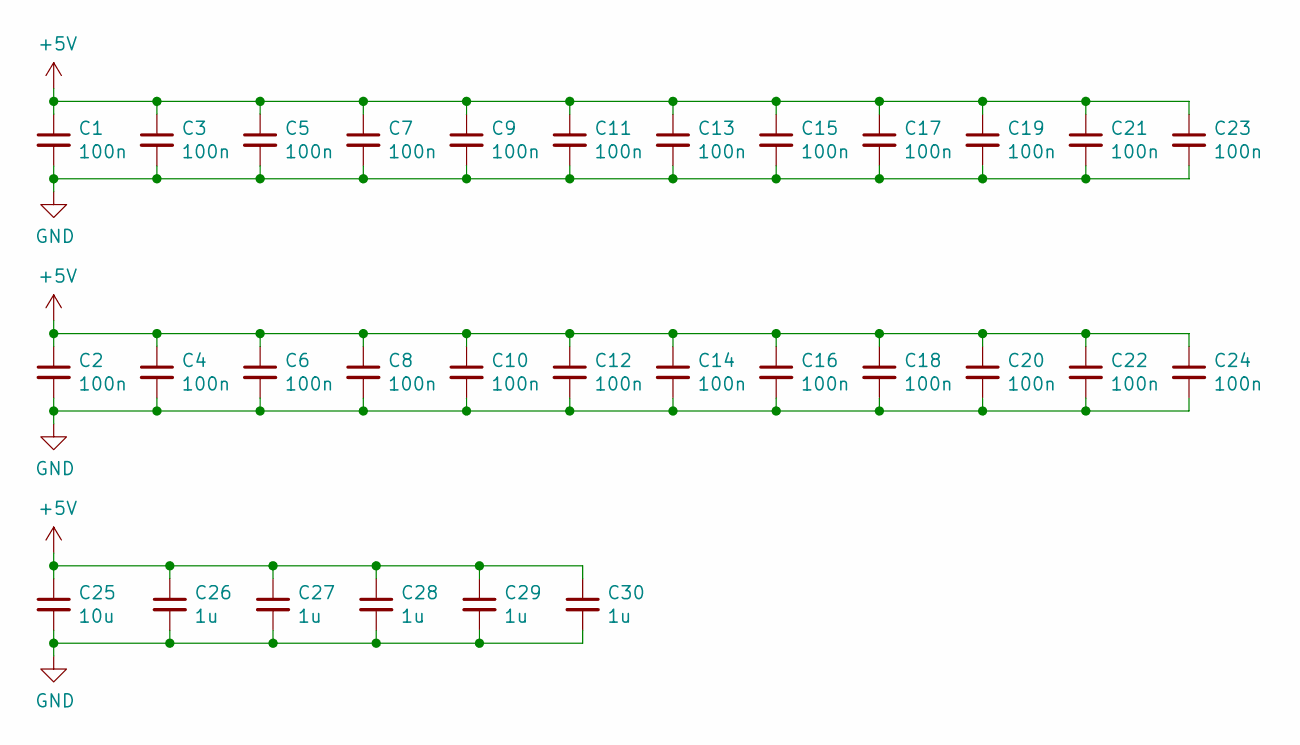
[picture p36: schematic Decoupling_Bypass.sch, Decoupling / Bypass Capacitors]

Parts:
C1, C2, C3, C4, C5, C6, C7, C8, C9, C10, C11, C12, C13, C14, C15, C16, C17, C18, C19, C20, C21, C22, C23, C24: 100n; C_0805_2012Metric
C25: 10u; C_0805_2012Metric
C26, C27, C28, C29, C30: 1u; C_0805_2012Metric

Connections:
+5V: C1.1, C2.1, C3.1, C4.1, C5.1, C6.1, C7.1, C8.1, C9.1, C10.1, C11.1, C12.1, C13.1, C14.1, C15.1, C16.1, C17.1, C18.1, C19.1, C20.1, C21.1, C22.1, C23.1, C24.1, C25.1, C26.1, C27.1, C28.1, C29.1, C30.1; also elsewhere on the board
GND: C1.2, C2.2, C3.2, C4.2, C5.2, C6.2, C7.2, C8.2, C9.2, C10.2, C11.2, C12.2, C13.2, C14.2, C15.2, C16.2, C17.2, C18.2, C19.2, C20.2, C21.2, C22.2, C23.2, C24.2, C25.2, C26.2, C27.2, C28.2, C29.2, C30.2; also elsewhere on the board

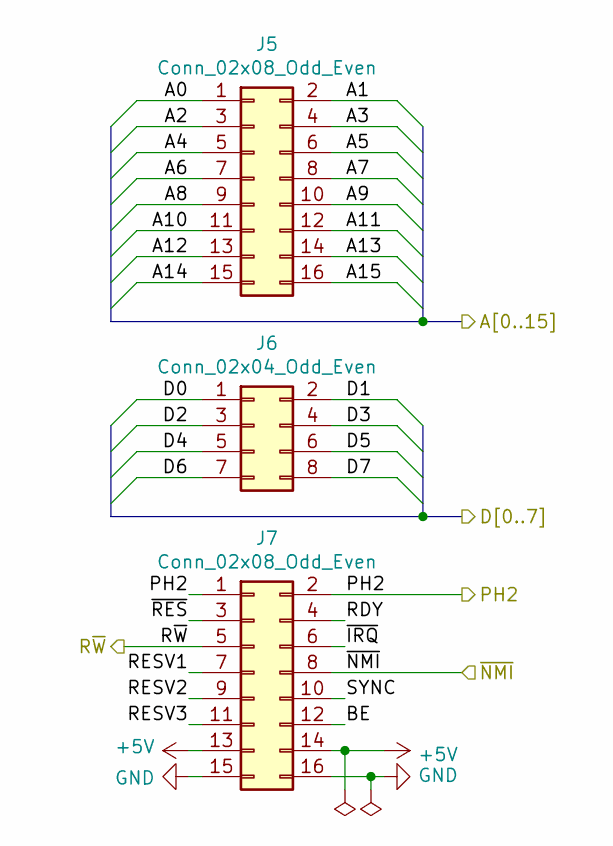
[picture p37: schematic SystemIO.sch, System I/O]

Parts:
J5, J7: Conn_02x08_Odd_Even; IDC-Header_2x08_P2.54mm_Vertical
J6: Conn_02x04_Odd_Even; IDC-Header_2x04_P2.54mm_Vertical

Connections:
+5V: J7.13, J7.14; also elsewhere on the board
/A0: J5.1; also elsewhere on the board
/A1: J5.2; also elsewhere on the board
/A2: J5.3; also elsewhere on the board
/A3: J5.4; also elsewhere on the board
/A4: J5.5; also elsewhere on the board
/A5: J5.6; also elsewhere on the board
/A6: J5.7; also elsewhere on the board
/A7: J5.8; also elsewhere on the board
/A8: J5.9; also elsewhere on the board
/A9: J5.10; also elsewhere on the board
/A12: J5.13; also elsewhere on the board
/A13: J5.14; also elsewhere on the board
/A14: J5.15; also elsewhere on the board
/A15: J5.16; also elsewhere on the board
/D0: J6.1; also elsewhere on the board
/D1: J6.2; also elsewhere on the board
/D2: J6.3; also elsewhere on the board
/D3: J6.4; also elsewhere on the board
/D4: J6.5; also elsewhere on the board
/D5: J6.6; also elsewhere on the board
/D6: J6.7; also elsewhere on the board
/D7: J6.8; also elsewhere on the board
/PH2: J7.1, J7.2; also elsewhere on the board
/R~W: J7.5; also elsewhere on the board
/System I/O/A10: J5.11
/System I/O/A11: J5.12
/System I/O/BE: J7.12
/System I/O/RDY: J7.4
/System I/O/RESV1: J7.7
/System I/O/RESV2: J7.9
/System I/O/RESV3: J7.11
/System I/O/SYNC: J7.10
/System I/O/~IRQ: J7.6
/System I/O/~RES: J7.3
/~NMI: J7.8; also elsewhere on the board
GND: J7.15, J7.16; also elsewhere on the board

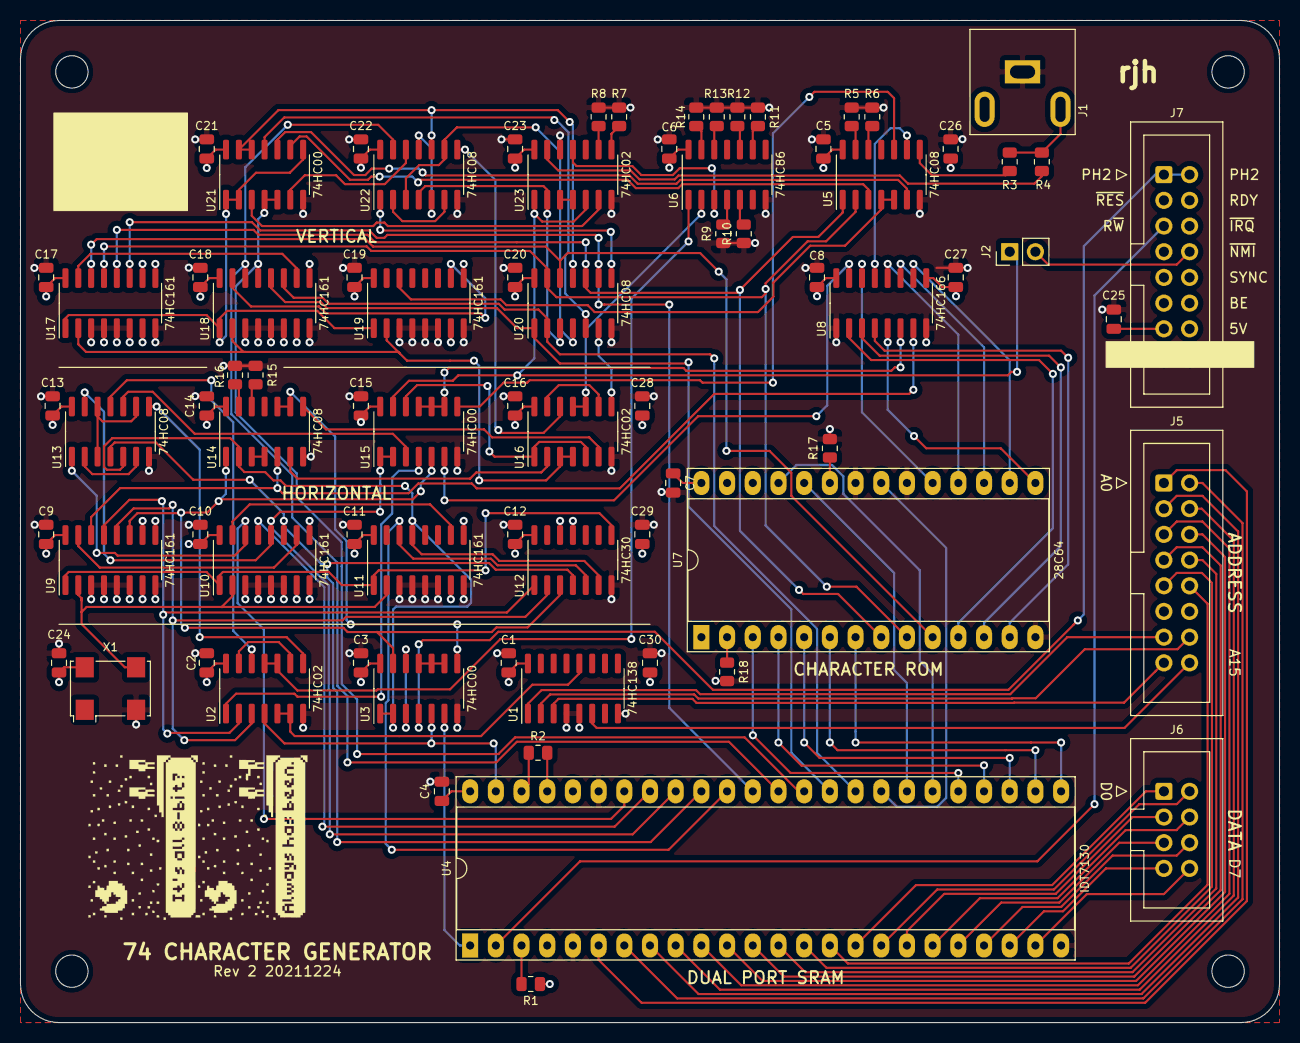
[picture p38: board video_ribbons.kicad_pcb from above]

Board: 4 copper layers, 124.5 x 99.1 mm, 81 parts (0 on the bottom side), 129 nets.
