rjhelms/compe6502/Hardware/backplane/backplane.kicad_pcb

## KiCad design Hardware/backplane/backplane.kicad_pcb (2022-01-03)

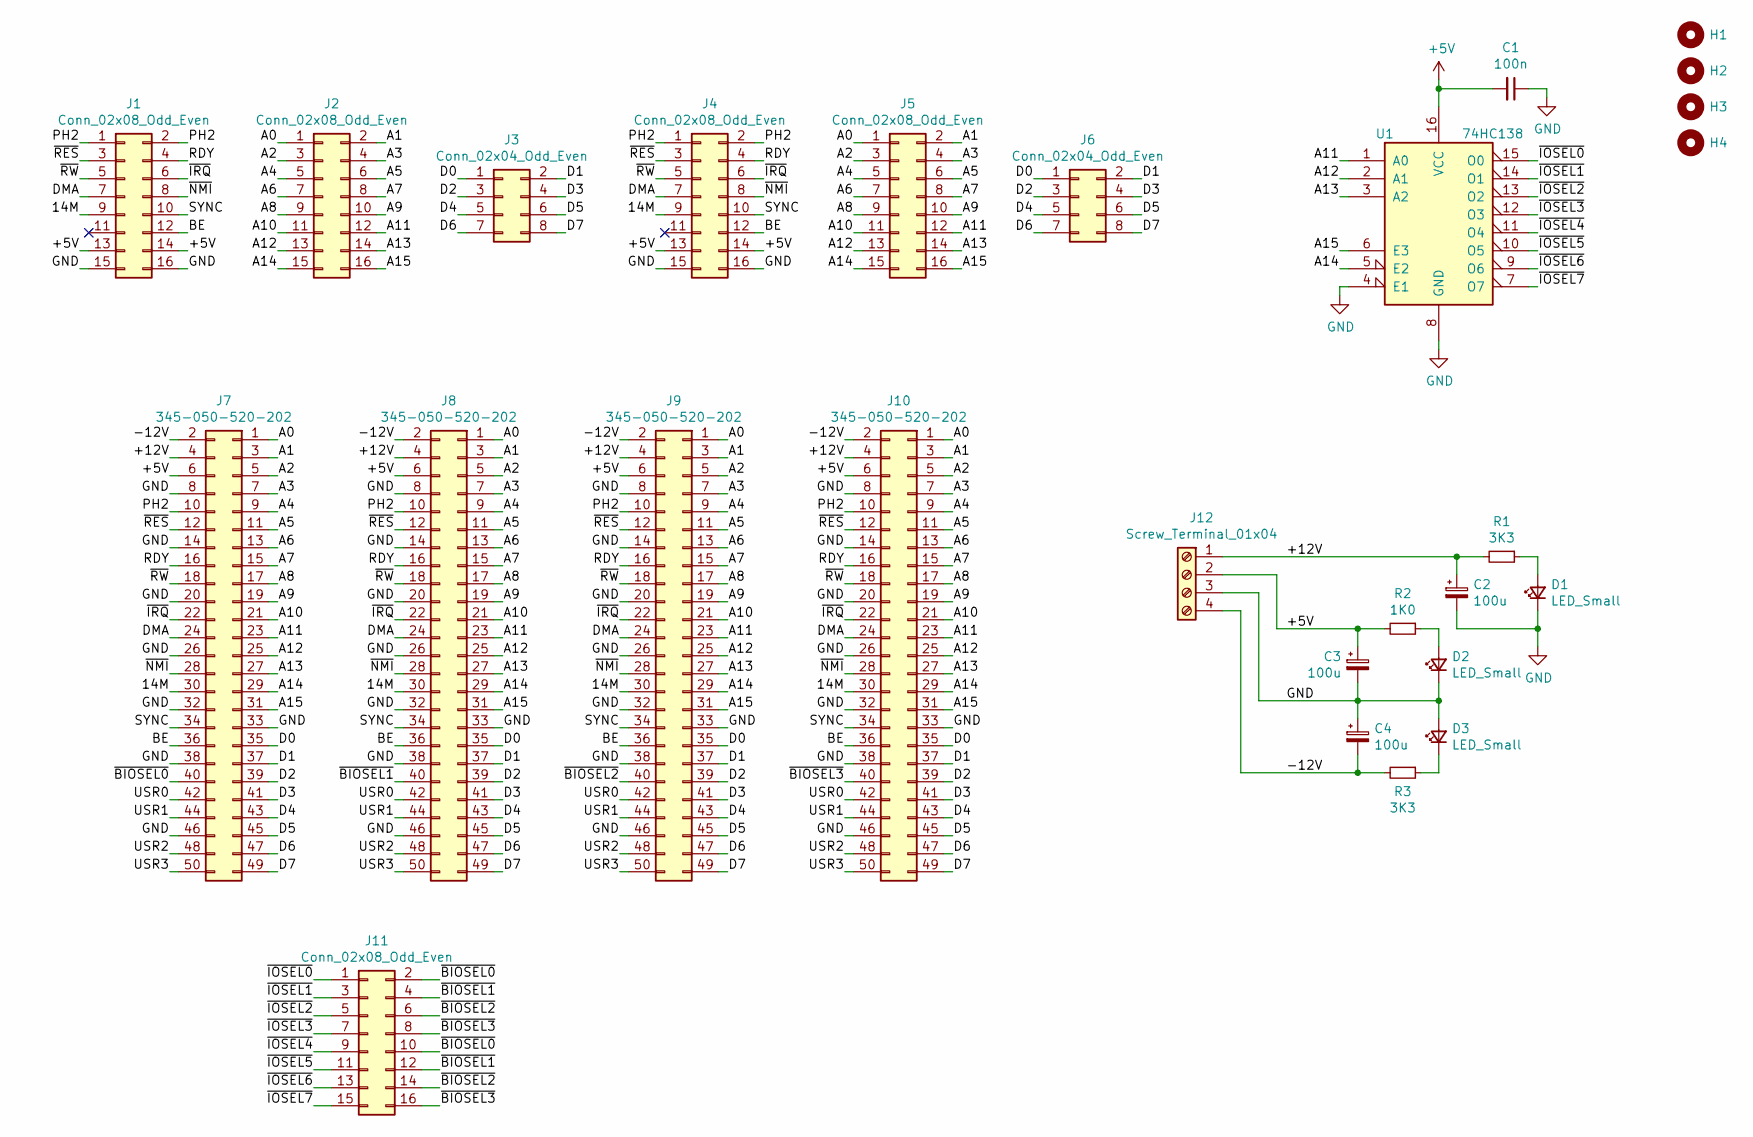
[picture p39: schematic backplane.sch, Compe 6502 Prototyping Backplane]

Parts:
C1: 100n; C_Disc_D5.0mm_W2.5mm_P2.50mm; MPN K104K15X7RF5TL2
C2, C3, C4: 100u; CP_Radial_D6.3mm_P2.50mm; MPN 860020573008
D1, D2, D3: LED_Small; LED_D5.0mm; MPN SLR-56MG3F
H1, H2, H3, H4: MountingHole; MountingHole_3.2mm_M3
J1, J2, J4, J5: Conn_02x08_Odd_Even; IDC-Header_2x08_P2.54mm_Vertical; MPN 302-S161
J3, J6: Conn_02x04_Odd_Even; IDC-Header_2x04_P2.54mm_Vertical; MPN 75869-132LF
J7, J8, J9, J10: 345-050-520-202; EDAC_345-050-520-202; MPN 345-050-520-202
J11: Conn_02x08_Odd_Even; PinHeader_2x08_P2.54mm_Vertical
J12: Screw_Terminal_01x04; TerminalBlock_Phoenix_PT-1,5-4-3.5-H_1x04_P3.50mm_Horizontal; MPN 1984633
R1, R3: 3K3; R_Axial_DIN0207_L6.3mm_D2.5mm_P7.62mm_Horizontal; MPN CF14JT3K30
R2: 1K0; R_Axial_DIN0207_L6.3mm_D2.5mm_P7.62mm_Horizontal; MPN CF14JT1K00
U1: 74HC138; DIP-16_W7.62mm_LongPads; MPN SN74HC138N

Connections:
+5V: C1.2, C3.1, J1.13, J1.14, J4.13, J4.14, J7.6, J8.6, J9.6, J10.6, J12.2, R2.2, U1.16 (VCC)
/14M: J1.9, J4.9, J7.30, J8.30, J9.30, J10.30
/+12V: C2.1, J7.4, J8.4, J9.4, J10.4, J12.1, R1.2
/-12V: C4.2, J7.2, J8.2, J9.2, J10.2, J12.4, R3.2
/A0: J2.1, J5.1, J7.1, J8.1, J9.1, J10.1
/A1: J2.2, J5.2, J7.3, J8.3, J9.3, J10.3
/A2: J2.3, J5.3, J7.5, J8.5, J9.5, J10.5
/A3: J2.4, J5.4, J7.7, J8.7, J9.7, J10.7
/A4: J2.5, J5.5, J7.9, J8.9, J9.9, J10.9
/A5: J2.6, J5.6, J7.11, J8.11, J9.11, J10.11
/A6: J2.7, J5.7, J7.13, J8.13, J9.13, J10.13
/A7: J2.8, J5.8, J7.15, J8.15, J9.15, J10.15
/A8: J2.9, J5.9, J7.17, J8.17, J9.17, J10.17
/A9: J2.10, J5.10, J7.19, J8.19, J9.19, J10.19
/A10: J2.11, J5.11, J7.21, J8.21, J9.21, J10.21
/A11: J2.12, J5.12, J7.23, J8.23, J9.23, J10.23, U1.1 (A0)
/A12: J2.13, J5.13, J7.25, J8.25, J9.25, J10.25, U1.2 (A1)
/A13: J2.14, J5.14, J7.27, J8.27, J9.27, J10.27, U1.3 (A2)
/A14: J2.15, J5.15, J7.29, J8.29, J9.29, J10.29, U1.5 (E2)
/A15: J2.16, J5.16, J7.31, J8.31, J9.31, J10.31, U1.6 (E3)
/BE: J1.12, J4.12, J7.36, J8.36, J9.36, J10.36
/D0: J3.1, J6.1, J7.35, J8.35, J9.35, J10.35
/D1: J3.2, J6.2, J7.37, J8.37, J9.37, J10.37
/D2: J3.3, J6.3, J7.39, J8.39, J9.39, J10.39
/D3: J3.4, J6.4, J7.41, J8.41, J9.41, J10.41
/D4: J3.5, J6.5, J7.43, J8.43, J9.43, J10.43
/D5: J3.6, J6.6, J7.45, J8.45, J9.45, J10.45
/D6: J3.7, J6.7, J7.47, J8.47, J9.47, J10.47
/D7: J3.8, J6.8, J7.49, J8.49, J9.49, J10.49
/DMA: J1.7, J4.7, J7.24, J8.24, J9.24, J10.24
/PH2: J1.1, J1.2, J4.1, J4.2, J7.10, J8.10, J9.10, J10.10
/RDY: J1.4, J4.4, J7.16, J8.16, J9.16, J10.16
/SYNC: J1.10, J4.10, J7.34, J8.34, J9.34, J10.34
/USR0: J7.42, J8.42, J9.42, J10.42
/USR1: J7.44, J8.44, J9.44, J10.44
/USR2: J7.48, J8.48, J9.48, J10.48
/USR3: J7.50, J8.50, J9.50, J10.50
/~BIOSEL0: J7.40, J11.2, J11.10
/~BIOSEL1: J8.40, J11.4, J11.12
/~BIOSEL2: J9.40, J11.6, J11.14
/~BIOSEL3: J10.40, J11.8, J11.16
/~IOSEL0: J11.1, U1.15 (O0)
/~IOSEL1: J11.3, U1.14 (O1)
/~IOSEL2: J11.5, U1.13 (O2)
/~IOSEL3: J11.7, U1.12 (O3)
/~IOSEL4: J11.9, U1.11 (O4)
/~IOSEL5: J11.11, U1.10 (O5)
/~IOSEL6: J11.13, U1.9 (O6)
/~IOSEL7: J11.15, U1.7 (O7)
/~IRQ: J1.6, J4.6, J7.22, J8.22, J9.22, J10.22
/~NMI: J1.8, J4.8, J7.28, J8.28, J9.28, J10.28
/~RES: J1.3, J4.3, J7.12, J8.12, J9.12, J10.12
/~RW: J1.5, J4.5, J7.18, J8.18, J9.18, J10.18
GND: C1.1, C2.2, C3.2, C4.1, D1.1 (K), D2.1 (K), D3.2 (A), J1.15, J1.16, J4.15, J4.16, J7.8, J7.14, J7.20, J7.26, J7.32, J7.33, J7.38, J7.46, J8.8, J8.14, J8.20, J8.26, J8.32, J8.33, J8.38, J8.46, J9.8, J9.14, J9.20, J9.26, J9.32, J9.33, J9.38, J9.46, J10.8, J10.14, J10.20, J10.26, J10.32, J10.33, J10.38, J10.46, J12.3, U1.4 (E1), U1.8 (GND)
unnamed: D1.2 (A), R1.1
unnamed: D2.2 (A), R2.1
unnamed: D3.1 (K), R3.1

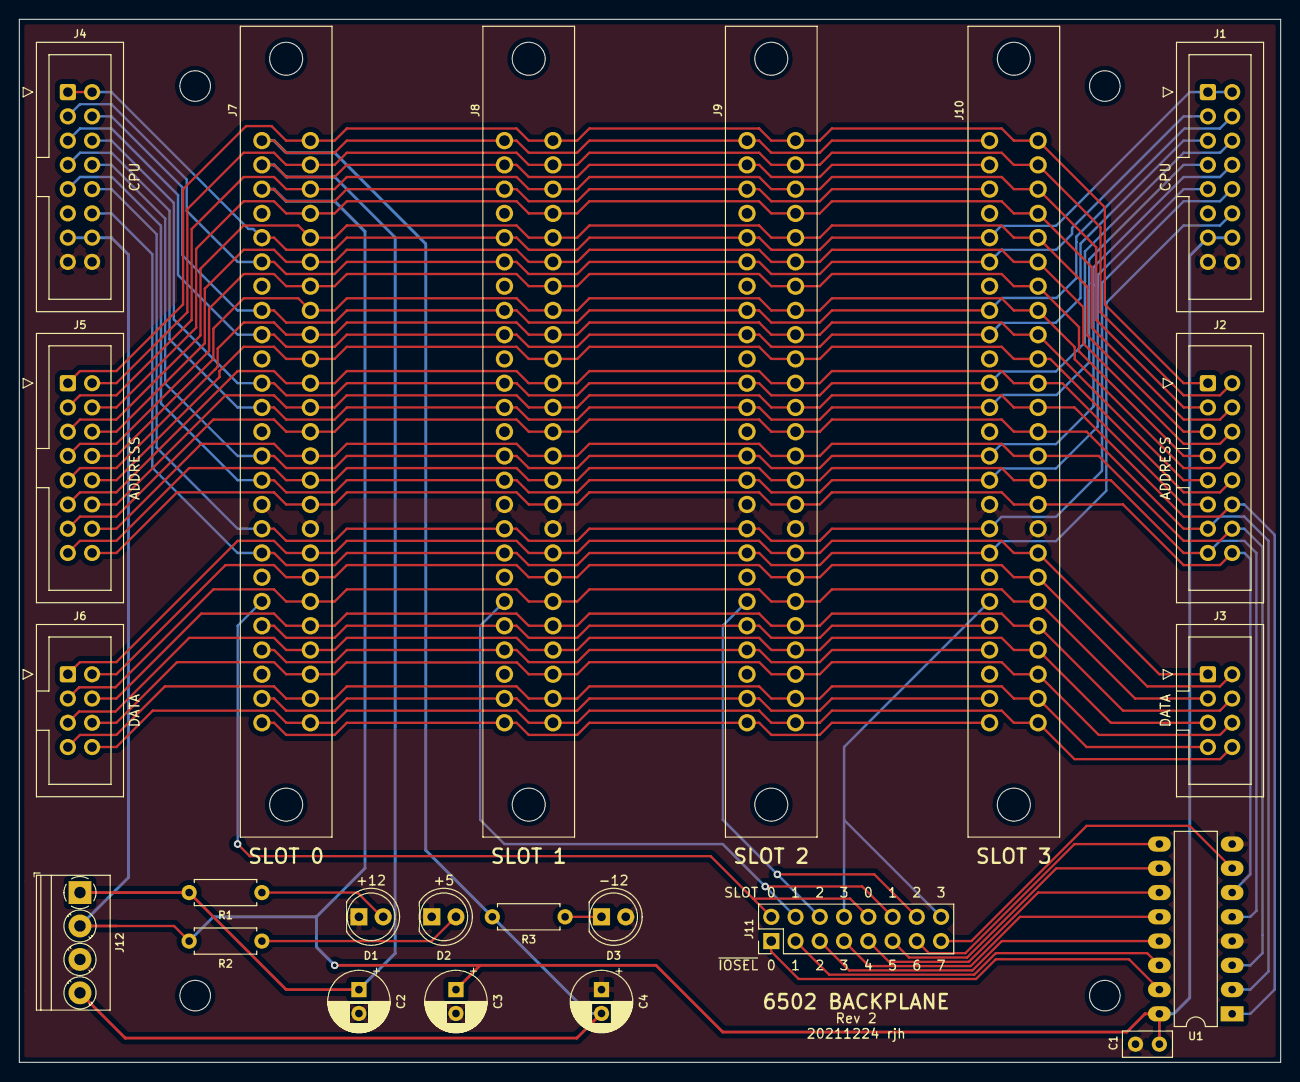
[picture p40: board backplane.kicad_pcb from above]

Board: 2 copper layers, 132.1 x 109.2 mm, 27 parts (0 on the bottom side), 57 nets.
