rjhelms/compe6502/Hardware/io_card/io_card.kicad_pcb

## KiCad design Hardware/io_card/io_card.kicad_pcb (2021-12-24)

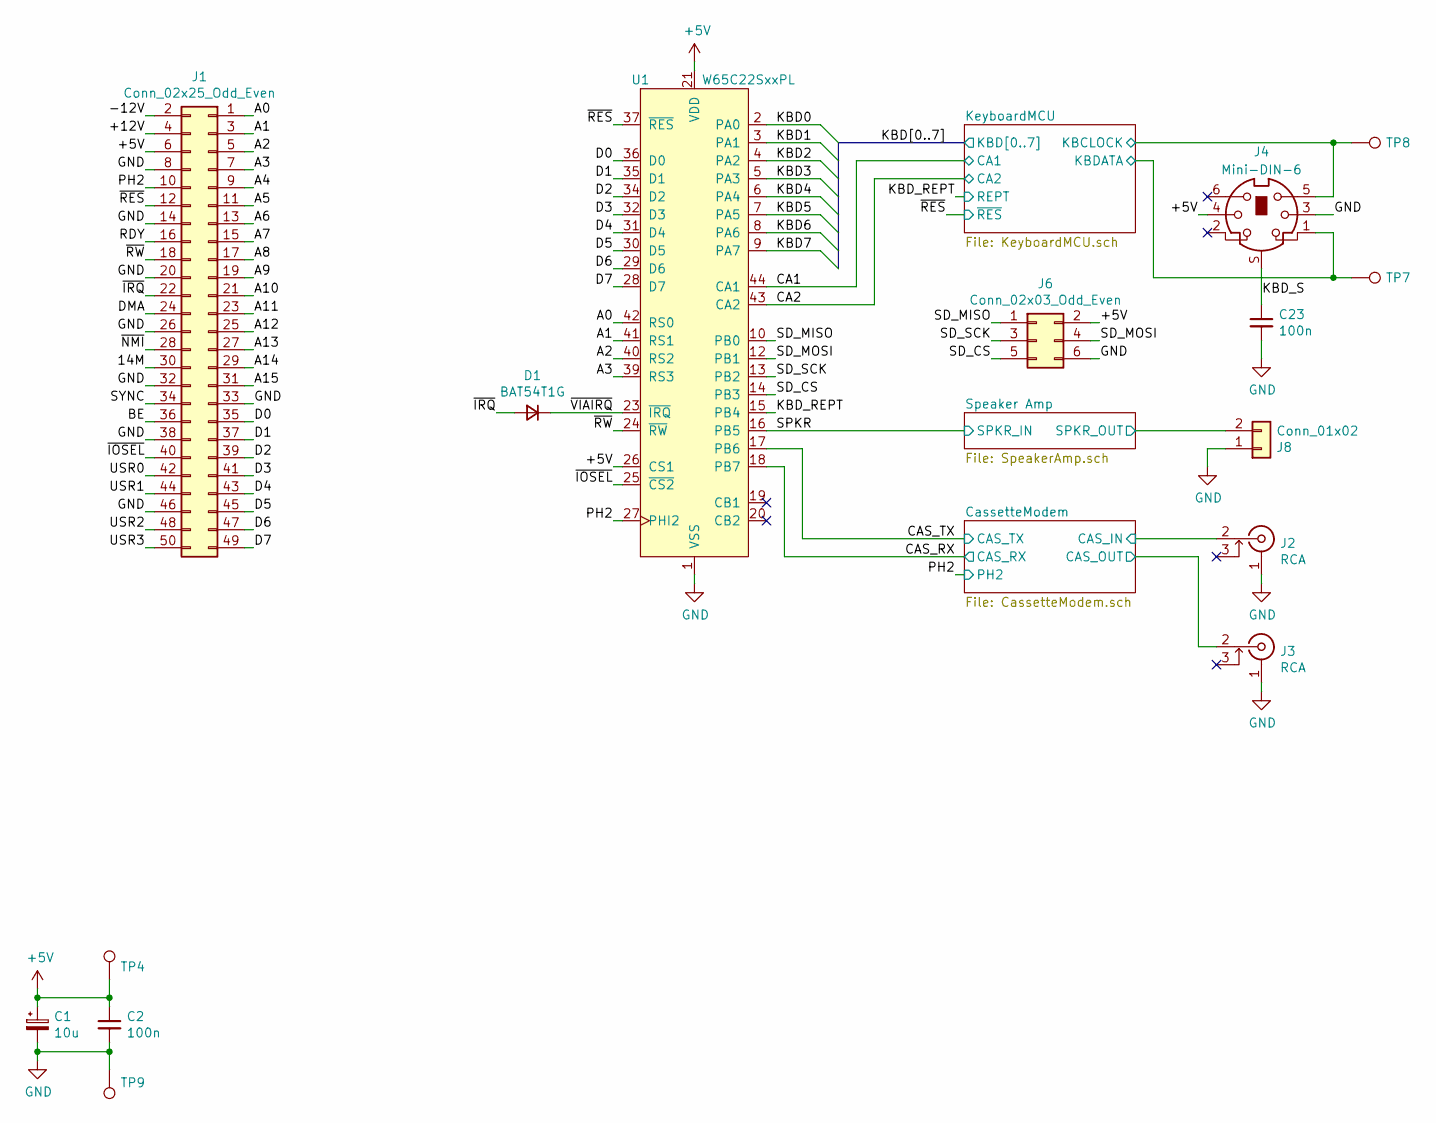
[picture p41: schematic io_card.sch, VIA I/O Card]

Parts:
C1: 10u; C_0805_2012Metric; MPN GRM21BR61E106KA73L
C2, C23: 100n; C_0805_2012Metric; MPN 08055C104JAT2A
D1: BAT54T1G; D_SOD-123; MPN BAT54T1G
J1: Conn_02x25_Odd_Even; EDAC_345-050-520-202_CardEdge; MPN 345-050-520-202
J2, J3: RCA; Jack_RCA_Switchcraft_PJRAN1X1UxxX; MPN PJRAN1X1U02AUX
J4: Mini-DIN-6; CUI_MD-60S; MPN MD-60S
J6: Conn_02x03_Odd_Even; IDC-Header_2x03_P2.54mm_Vertical; MPN 54020-44030LF
J8: Conn_01x02; PinHeader_1x02_P2.54mm_Horizontal
TP4, TP7, TP8, TP9: TestPoint; TestPoint_Keystone_5015_Micro-Minature; MPN S1751-46R
U1: W65C22SxxPL; PLCC-44_THT-Socket; MPN W65C22S6TPLG-14

Connections:
+5V: C1.1, C2.1, J1.6, J4.4, J6.2, TP4.1, U1.21 (VDD), U1.26 (CS1); also elsewhere on the board
/14M: J1.30
/+12V: J1.4
/-12V: J1.2
/A0: J1.1, U1.42 (RS0)
/A1: J1.3, U1.41 (RS1)
/A2: J1.5, U1.40 (RS2)
/A3: J1.7, U1.39 (RS3)
/A4: J1.9
/A5: J1.11
/A6: J1.13
/A7: J1.15
/A8: J1.17
/A9: J1.19
/A10: J1.21
/A11: J1.23
/A12: J1.25
/A13: J1.27
/A14: J1.29
/A15: J1.31
/BE: J1.36
/CA1: U1.44 (CA1); also elsewhere on the board
/CA2: U1.43 (CA2); also elsewhere on the board
/CAS_RX: U1.18 (PB7); also elsewhere on the board
/CAS_TX: U1.17 (PB6); also elsewhere on the board
/CassetteModem/CAS_IN: J2.2 (In); also elsewhere on the board
/CassetteModem/CAS_OUT: J3.2 (In); also elsewhere on the board
/D0: J1.35, U1.36 (D0)
/D1: J1.37, U1.35 (D1)
/D2: J1.39, U1.34 (D2)
/D3: J1.41, U1.32 (D3)
/D4: J1.43, U1.31 (D4)
/D5: J1.45, U1.30 (D5)
/D6: J1.47, U1.29 (D6)
/D7: J1.49, U1.28 (D7)
/DMA: J1.24
/KBD0: U1.2 (PA0); also elsewhere on the board
/KBD1: U1.3 (PA1); also elsewhere on the board
/KBD2: U1.4 (PA2); also elsewhere on the board
/KBD3: U1.5 (PA3); also elsewhere on the board
/KBD4: U1.6 (PA4); also elsewhere on the board
/KBD5: U1.7 (PA5); also elsewhere on the board
/KBD6: U1.8 (PA6); also elsewhere on the board
/KBD7: U1.9 (PA7); also elsewhere on the board
/KBD_REPT: U1.15 (PB4); also elsewhere on the board
/KBD_S: C23.1, J4.S
/KeyboardMCU/KBCLOCK: J4.5, TP8.1; also elsewhere on the board
/KeyboardMCU/KBDATA: J4.1, TP7.1; also elsewhere on the board
/PH2: J1.10, U1.27 (PHI2); also elsewhere on the board
/RDY: J1.16
/SD_CS: J6.5, U1.14 (PB3)
/SD_MISO: J6.1, U1.10 (PB0)
/SD_MOSI: J6.4, U1.12 (PB1)
/SD_SCK: J6.3, U1.13 (PB2)
/SPKR: U1.16 (PB5); also elsewhere on the board
/SYNC: J1.34
/Speaker Amp/SPKR_OUT: J8.2; also elsewhere on the board
/USR0: J1.42
/USR1: J1.44
/USR2: J1.48
/USR3: J1.50
/~IOSEL: J1.40, U1.25 (~CS2)
/~IRQ: D1.2 (A), J1.22
/~NMI: J1.28
/~RES: J1.12, U1.37 (~RES); also elsewhere on the board
/~RW: J1.18, U1.24 (~RW)
/~VIAIRQ: D1.1 (K), U1.23 (~IRQ)
GND: C1.2, C2.2, C23.2, J1.8, J1.14, J1.20, J1.26, J1.32, J1.33, J1.38, J1.46, J2.1 (Ext), J3.1 (Ext), J4.3, J6.6, J8.1, TP9.1, U1.1 (VSS); also elsewhere on the board

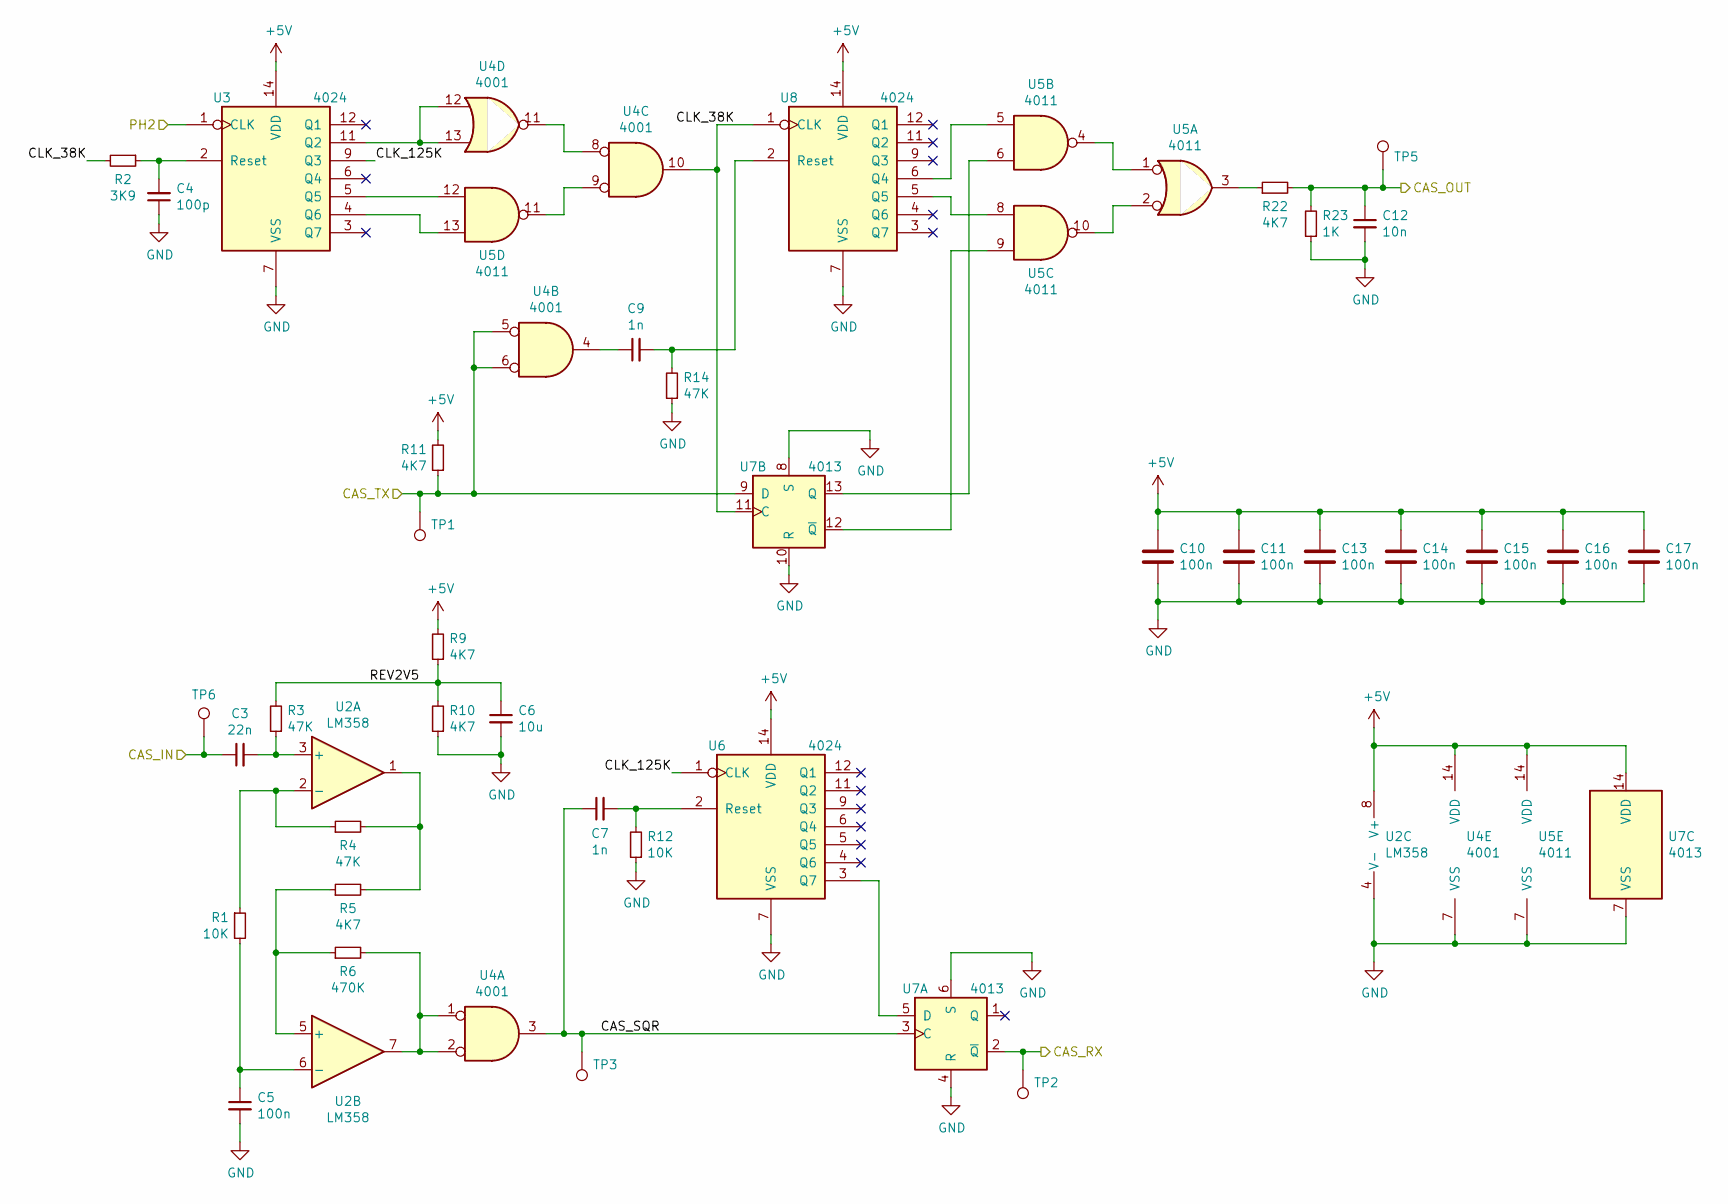
[picture p42: schematic CassetteModem.sch, VIA I/O Card - Cassette Modem]

Parts:
C3: 22n; C_0805_2012Metric; MPN CL21B223KBANNWC
C4: 100p; C_0805_2012Metric; MPN 885012007034
C5, C10, C11, C13, C14, C15, C16, C17: 100n; C_0805_2012Metric; MPN 08055C104JAT2A
C6: 10u; C_0805_2012Metric; MPN GRM21BR61E106KA73L
C7, C9: 1n; C_0805_2012Metric; MPN CL21B102KBANNND
C12: 10n; C_0805_2012Metric; MPN CL21B103KBANFNC
R1, R12: 10K; R_0805_2012Metric; MPN MCSR08X1002FTL
R2: 3K9; R_0805_2012Metric; MPN CR0805-FX-3901ELF
R3, R4, R14: 47K; R_0805_2012Metric; MPN RC0805FR-0747KL
R5, R9, R10, R11, R22: 4K7; R_0805_2012Metric; MPN CRCW08054K70FKTA
R6: 470K; R_0805_2012Metric; MPN RC0805FR-07470KL
R23: 1K; R_0805_2012Metric; MPN CRCW08051K00FKEB
TP1, TP2, TP3, TP5, TP6: TestPoint; TestPoint_Keystone_5015_Micro-Minature; MPN S1751-46R
U2: LM358; SOIC-8_3.9x4.9mm_P1.27mm; MPN LM358PSR
U3, U6, U8: 4024; SOIC-14_3.9x8.7mm_P1.27mm; MPN CD4024BM96
U4: 4001; SOIC-14_3.9x8.7mm_P1.27mm; MPN HEF4001BT-Q100J
U5: 4011; SOIC-14_3.9x8.7mm_P1.27mm; MPN MC14011BDR2G
U7: 4013; SOIC-14_3.9x8.7mm_P1.27mm; MPN HEF4013BT,653

Connections:
+5V: C10.1, C11.1, C13.1, C14.1, C15.1, C16.1, C17.1, R9.2, R11.2, U2.8 (V+), U3.14 (VDD), U4.14 (VDD), U5.14 (VDD), U6.14 (VDD), U7.14 (VDD), U8.14 (VDD); also elsewhere on the board
/CAS_RX: TP2.1, U7.2 (~Q); also elsewhere on the board
/CAS_TX: R11.1, TP1.1, U4.5, U4.6, U7.9 (D); also elsewhere on the board
/CassetteModem/CAS_IN: C3.1, TP6.1; also elsewhere on the board
/CassetteModem/CAS_OUT: C12.1, R22.2, R23.2, TP5.1; also elsewhere on the board
/CassetteModem/CAS_SQR: C7.1, TP3.1, U4.3, U7.3 (C)
/CassetteModem/CLK_38K: R2.2, U4.10, U7.11 (C), U8.1 (CLK)
/CassetteModem/CLK_125K: U3.9 (Q3), U6.1 (CLK)
/CassetteModem/REV2V5: C6.1, R3.2, R9.1, R10.2
/PH2: U3.1 (CLK); also elsewhere on the board
GND: C4.1, C5.2, C6.2, C10.2, C11.2, C12.2, C13.2, C14.2, C15.2, C16.2, C17.2, R10.1, R12.1, R14.1, R23.1, U2.4 (V-), U3.7 (VSS), U4.7 (VSS), U5.7 (VSS), U6.7 (VSS), U7.4 (R), U7.6 (S), U7.7 (VSS), U7.8 (S), U7.10 (R), U8.7 (VSS); also elsewhere on the board
unnamed: C3.2, R3.1, U2.3 (+)
unnamed: C4.2, R2.1, U3.2 (Reset)
unnamed: C5.1, R1.2, U2.6 (-)
unnamed: C7.2, R12.2, U6.2 (Reset)
unnamed: C9.1, U4.4
unnamed: C9.2, R14.2, U8.2 (Reset)
unnamed: R1.1, R4.1, U2.2 (-)
unnamed: R4.2, R5.2, U2.1
unnamed: R5.1, R6.1, U2.5 (+)
unnamed: R6.2, U2.7, U4.1, U4.2
unnamed: R22.1, U5.3
unnamed: U3.4 (Q6), U5.13
unnamed: U3.5 (Q5), U5.12
unnamed: U3.11 (Q2), U4.12, U4.13
unnamed: U4.9, U5.11
unnamed: U4.8, U4.11
unnamed: U5.1, U5.4
unnamed: U5.5, U8.6 (Q4)
unnamed: U5.6, U7.13 (Q)
unnamed: U5.8, U8.5 (Q5)
unnamed: U5.9, U7.12 (~Q)
unnamed: U5.2, U5.10
unnamed: U6.3 (Q7), U7.5 (D)

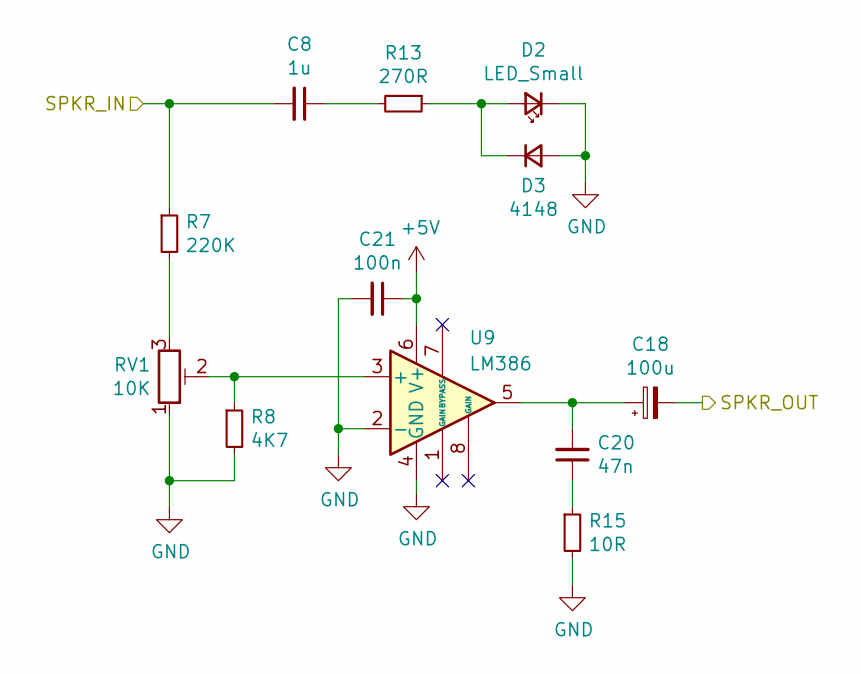
[picture p43: schematic SpeakerAmp.sch, VIA I/O Card - Speaker Amplifier]

Parts:
C8: 1u; C_0805_2012Metric; MPN 08053C105K4Z4A
C18: 100u; CP_Elec_6.3x5.4; MPN 865080343009
C20: 47n; C_0805_2012Metric; MPN CL21B473KBCNNNC
C21: 100n; C_0805_2012Metric; MPN 08055C104JAT2A
D2: LED_Small; LED_0805_2012Metric; MPN 598-8170-107F
D3: 4148; D_SOD-123; MPN MMSD4148T1G
R7: 220K; R_0805_2012Metric; MPN RC0805FR-07220KL
R8: 4K7; R_0805_2012Metric; MPN CRCW08054K70FKTA
R13: 270R; R_0805_2012Metric; MPN RC0805FR-07270RL
R15: 10R; R_0805_2012Metric; MPN CR0805-FX-10R0ELF
RV1: 10K; Potentiometer_Copal_CT-6EP; MPN CT6EP103
U9: LM386; SOIC-8_3.9x4.9mm_P1.27mm; MPN LM386M-1/NOPB

Connections:
+5V: C21.1, U9.6 (V+); also elsewhere on the board
/SPKR: C8.2, R7.1; also elsewhere on the board
/Speaker Amp/SPKR_OUT: C18.2; also elsewhere on the board
GND: C21.2, D2.1 (K), D3.2 (A), R8.2, R15.2, RV1.1, U9.2 (-), U9.4 (GND); also elsewhere on the board
unnamed: C8.1, R13.2
unnamed: C18.1, C20.2, U9.5
unnamed: C20.1, R15.1
unnamed: D2.2 (A), D3.1 (K), R13.1
unnamed: R7.2, RV1.3
unnamed: R8.1, RV1.2, U9.3 (+)

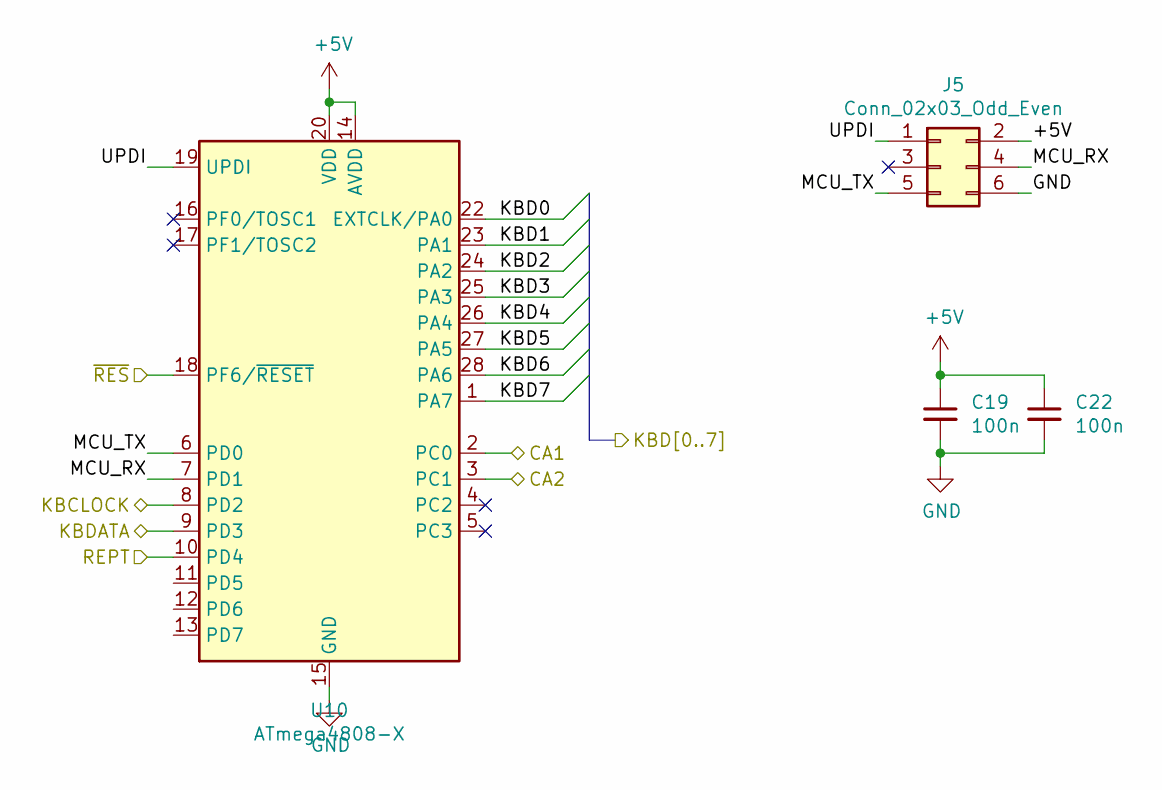
[picture p44: schematic KeyboardMCU.sch, VIA I/O Card - Keyboard MCU]

Parts:
C19, C22: 100n; C_0805_2012Metric; MPN 08055C104JAT2A
J5: Conn_02x03_Odd_Even; IDC-Header_2x03_P2.54mm_Vertical; MPN 54020-44030LF
U10: ATmega4808-X; SSOP-28_5.3x10.2mm_P0.65mm; MPN ATMEGA4808-XUR

Connections:
+5V: C19.1, C22.1, J5.2, U10.14 (AVDD), U10.20 (VDD); also elsewhere on the board
/CA1: U10.2 (PC0); also elsewhere on the board
/CA2: U10.3 (PC1); also elsewhere on the board
/KBD0: U10.22 (EXTCLK/PA0); also elsewhere on the board
/KBD1: U10.23 (PA1); also elsewhere on the board
/KBD2: U10.24 (PA2); also elsewhere on the board
/KBD3: U10.25 (PA3); also elsewhere on the board
/KBD4: U10.26 (PA4); also elsewhere on the board
/KBD5: U10.27 (PA5); also elsewhere on the board
/KBD6: U10.28 (PA6); also elsewhere on the board
/KBD7: U10.1 (PA7); also elsewhere on the board
/KBD_REPT: U10.10 (PD4); also elsewhere on the board
/KeyboardMCU/KBCLOCK: U10.8 (PD2); also elsewhere on the board
/KeyboardMCU/KBDATA: U10.9 (PD3); also elsewhere on the board
/KeyboardMCU/MCU_RX: J5.4, U10.7 (PD1)
/KeyboardMCU/MCU_TX: J5.5, U10.6 (PD0)
/KeyboardMCU/UPDI: J5.1, U10.19 (UPDI)
/~RES: U10.18 (PF6/~RESET); also elsewhere on the board
GND: C19.2, C22.2, J5.6, U10.15 (GND), U10.21 (GND); also elsewhere on the board

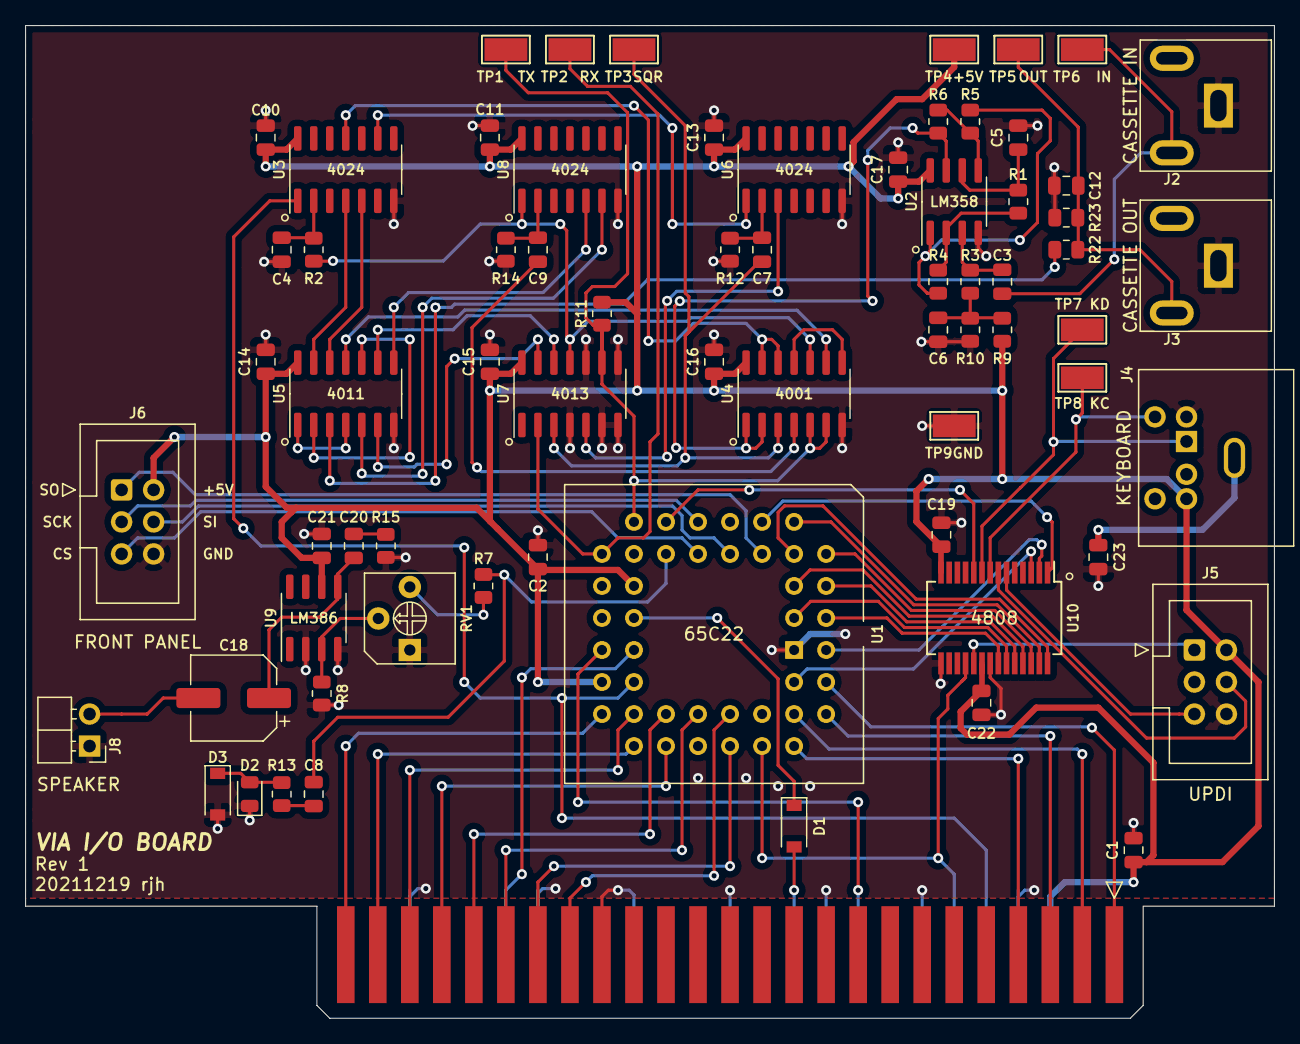
[picture p45: board io_card.kicad_pcb from above]

Board: 2 copper layers, 99.1 x 78.7 mm, 70 parts (0 on the bottom side), 80 nets.
