rjhelms/compe6502/Hardware/proto_card/proto_card.kicad_pcb

## KiCad design Hardware/proto_card/proto_card.kicad_pcb (2021-12-24)

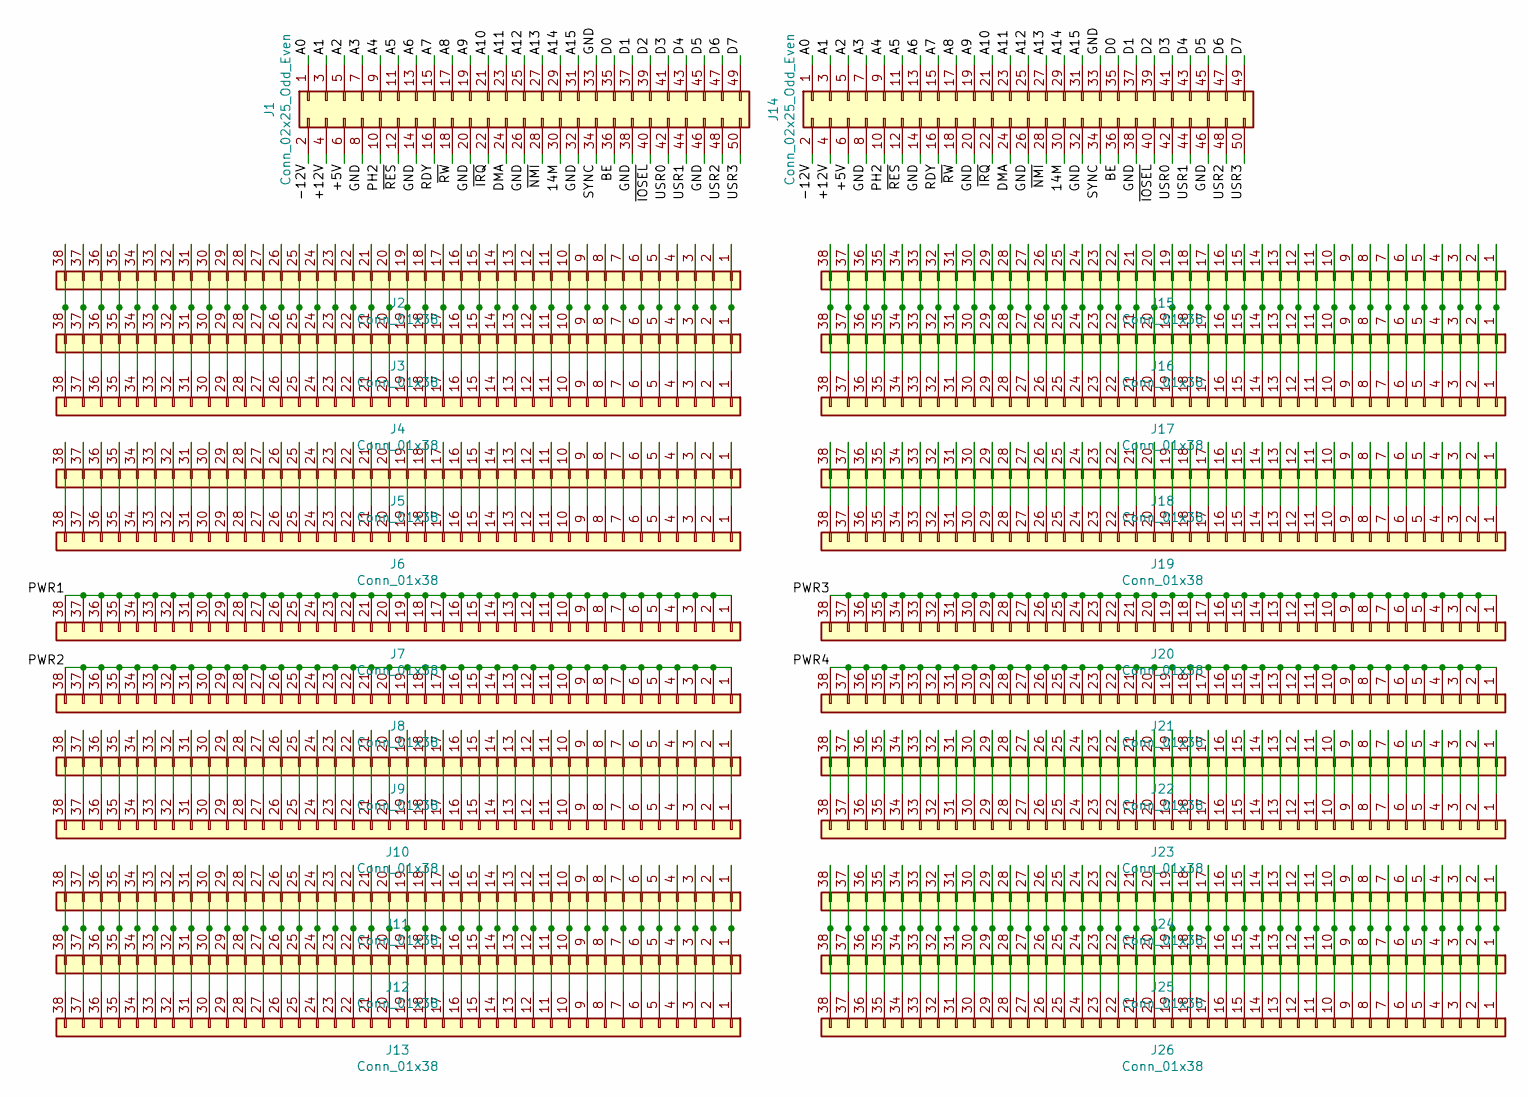
[picture p46: schematic proto_card.sch, Compe 6502 Protocard]

Parts:
J1: Conn_02x25_Odd_Even; EDAC_345-050-520-202_CardEdge; MPN 345-050-520-202
J2, J3, J4, J5, J6, J7, J8, J9, J10, J11, J12, J13, J15, J16, J17, J18, J19, J20, J21, J22, J23, J24, J25, J26: Conn_01x38; BreadboardRow_1x38_P2.54
J14: Conn_02x25_Odd_Even; PinHeader_2x25_P2.54mm_Vertical; MPN 345-050-520-202

Connections:
/14M: J1.30, J14.30
/+5V: J1.6, J14.6
/+12V: J1.4, J14.4
/-12V: J1.2, J14.2
/A0: J1.1, J14.1
/A1: J1.3, J14.3
/A2: J1.5, J14.5
/A3: J1.7, J14.7
/A4: J1.9, J14.9
/A5: J1.11, J14.11
/A6: J1.13, J14.13
/A7: J1.15, J14.15
/A8: J1.17, J14.17
/A9: J1.19, J14.19
/A10: J1.21, J14.21
/A11: J1.23, J14.23
/A12: J1.25, J14.25
/A13: J1.27, J14.27
/A14: J1.29, J14.29
/A15: J1.31, J14.31
/BE: J1.36, J14.36
/D0: J1.35, J14.35
/D1: J1.37, J14.37
/D2: J1.39, J14.39
/D3: J1.41, J14.41
/D4: J1.43, J14.43
/D5: J1.45, J14.45
/D6: J1.47, J14.47
/D7: J1.49, J14.49
/DMA: J1.24, J14.24
/GND: J1.8, J1.14, J1.20, J1.26, J1.32, J1.33, J1.38, J1.46, J14.8, J14.14, J14.20, J14.26, J14.32, J14.33, J14.38, J14.46
/PH2: J1.10, J14.10
/PWR1: J7.1, J7.2, J7.3, J7.4, J7.5, J7.6, J7.7, J7.8, J7.9, J7.10, J7.11, J7.12, J7.13, J7.14, J7.15, J7.16, J7.17, J7.18, J7.19, J7.20, J7.21, J7.22, J7.23, J7.24, J7.25, J7.26, J7.27, J7.28, J7.29, J7.30, J7.31, J7.32, J7.33, J7.34, J7.35, J7.36, J7.37, J7.38
/PWR2: J8.1, J8.2, J8.3, J8.4, J8.5, J8.6, J8.7, J8.8, J8.9, J8.10, J8.11, J8.12, J8.13, J8.14, J8.15, J8.16, J8.17, J8.18, J8.19, J8.20, J8.21, J8.22, J8.23, J8.24, J8.25, J8.26, J8.27, J8.28, J8.29, J8.30, J8.31, J8.32, J8.33, J8.34, J8.35, J8.36, J8.37, J8.38
/PWR3: J20.1, J20.2, J20.3, J20.4, J20.5, J20.6, J20.7, J20.8, J20.9, J20.10, J20.11, J20.12, J20.13, J20.14, J20.15, J20.16, J20.17, J20.18, J20.19, J20.20, J20.21, J20.22, J20.23, J20.24, J20.25, J20.26, J20.27, J20.28, J20.29, J20.30, J20.31, J20.32, J20.33, J20.34, J20.35, J20.36, J20.37, J20.38
/PWR4: J21.1, J21.2, J21.3, J21.4, J21.5, J21.6, J21.7, J21.8, J21.9, J21.10, J21.11, J21.12, J21.13, J21.14, J21.15, J21.16, J21.17, J21.18, J21.19, J21.20, J21.21, J21.22, J21.23, J21.24, J21.25, J21.26, J21.27, J21.28, J21.29, J21.30, J21.31, J21.32, J21.33, J21.34, J21.35, J21.36, J21.37, J21.38
/RDY: J1.16, J14.16
/SYNC: J1.34, J14.34
/USR0: J1.42, J14.42
/USR1: J1.44, J14.44
/USR2: J1.48, J14.48
/USR3: J1.50, J14.50
/~IOSEL: J1.40, J14.40
/~IRQ: J1.22, J14.22
/~NMI: J1.28, J14.28
/~RES: J1.12, J14.12
/~RW: J1.18, J14.18
unnamed: J2.1, J3.1, J4.1
unnamed: J2.2, J3.2, J4.2
unnamed: J2.3, J3.3, J4.3
unnamed: J2.4, J3.4, J4.4
unnamed: J2.5, J3.5, J4.5
unnamed: J2.6, J3.6, J4.6
unnamed: J2.7, J3.7, J4.7
unnamed: J2.8, J3.8, J4.8
unnamed: J2.9, J3.9, J4.9
unnamed: J2.10, J3.10, J4.10
unnamed: J2.11, J3.11, J4.11
unnamed: J2.12, J3.12, J4.12
unnamed: J2.13, J3.13, J4.13
unnamed: J2.14, J3.14, J4.14
unnamed: J2.15, J3.15, J4.15
unnamed: J2.16, J3.16, J4.16
unnamed: J2.17, J3.17, J4.17
unnamed: J2.18, J3.18, J4.18
unnamed: J2.19, J3.19, J4.19
unnamed: J2.20, J3.20, J4.20
unnamed: J2.21, J3.21, J4.21
unnamed: J2.22, J3.22, J4.22
unnamed: J2.23, J3.23, J4.23
unnamed: J2.24, J3.24, J4.24
unnamed: J2.25, J3.25, J4.25
unnamed: J2.26, J3.26, J4.26
unnamed: J2.27, J3.27, J4.27
unnamed: J2.28, J3.28, J4.28
unnamed: J2.29, J3.29, J4.29
unnamed: J2.30, J3.30, J4.30
unnamed: J2.31, J3.31, J4.31
unnamed: J2.32, J3.32, J4.32
unnamed: J2.33, J3.33, J4.33
unnamed: J2.34, J3.34, J4.34
unnamed: J2.35, J3.35, J4.35
unnamed: J2.36, J3.36, J4.36
unnamed: J2.37, J3.37, J4.37
unnamed: J2.38, J3.38, J4.38
unnamed: J5.1, J6.1
unnamed: J5.2, J6.2
unnamed: J5.3, J6.3
unnamed: J5.4, J6.4
unnamed: J5.5, J6.5
unnamed: J5.6, J6.6
unnamed: J5.7, J6.7
unnamed: J5.8, J6.8
unnamed: J5.9, J6.9
unnamed: J5.10, J6.10
unnamed: J5.11, J6.11
unnamed: J5.12, J6.12
unnamed: J5.13, J6.13
unnamed: J5.14, J6.14
unnamed: J5.15, J6.15
unnamed: J5.16, J6.16
unnamed: J5.17, J6.17
unnamed: J5.18, J6.18
unnamed: J5.19, J6.19
unnamed: J5.20, J6.20
unnamed: J5.21, J6.21
unnamed: J5.22, J6.22
unnamed: J5.23, J6.23
unnamed: J5.24, J6.24
unnamed: J5.25, J6.25
unnamed: J5.26, J6.26
unnamed: J5.27, J6.27
unnamed: J5.28, J6.28
unnamed: J5.29, J6.29
unnamed: J5.30, J6.30
unnamed: J5.31, J6.31
unnamed: J5.32, J6.32
unnamed: J5.33, J6.33
unnamed: J5.34, J6.34
unnamed: J5.35, J6.35
unnamed: J5.36, J6.36
unnamed: J5.37, J6.37
unnamed: J5.38, J6.38
unnamed: J9.1, J10.1
unnamed: J9.2, J10.2
unnamed: J9.3, J10.3
unnamed: J9.4, J10.4
unnamed: J9.5, J10.5
unnamed: J9.6, J10.6
unnamed: J9.7, J10.7
unnamed: J9.8, J10.8
unnamed: J9.9, J10.9
unnamed: J9.10, J10.10
unnamed: J9.11, J10.11
unnamed: J9.12, J10.12
unnamed: J9.13, J10.13
unnamed: J9.14, J10.14
unnamed: J9.15, J10.15
unnamed: J9.16, J10.16
unnamed: J9.17, J10.17
unnamed: J9.18, J10.18
unnamed: J9.19, J10.19
unnamed: J9.20, J10.20
unnamed: J9.21, J10.21
unnamed: J9.22, J10.22
unnamed: J9.23, J10.23
unnamed: J9.24, J10.24
unnamed: J9.25, J10.25
unnamed: J9.26, J10.26
unnamed: J9.27, J10.27
unnamed: J9.28, J10.28
unnamed: J9.29, J10.29
unnamed: J9.30, J10.30
unnamed: J9.31, J10.31
unnamed: J9.32, J10.32
unnamed: J9.33, J10.33
unnamed: J9.34, J10.34
unnamed: J9.35, J10.35
unnamed: J9.36, J10.36
unnamed: J9.37, J10.37
unnamed: J9.38, J10.38
unnamed: J11.1, J12.1, J13.1
unnamed: J11.2, J12.2, J13.2
unnamed: J11.3, J12.3, J13.3
unnamed: J11.4, J12.4, J13.4
unnamed: J11.5, J12.5, J13.5
unnamed: J11.6, J12.6, J13.6
unnamed: J11.7, J12.7, J13.7
unnamed: J11.8, J12.8, J13.8
unnamed: J11.9, J12.9, J13.9
unnamed: J11.10, J12.10, J13.10
unnamed: J11.11, J12.11, J13.11
unnamed: J11.12, J12.12, J13.12
unnamed: J11.13, J12.13, J13.13
unnamed: J11.14, J12.14, J13.14
unnamed: J11.15, J12.15, J13.15
unnamed: J11.16, J12.16, J13.16
unnamed: J11.17, J12.17, J13.17
unnamed: J11.18, J12.18, J13.18
unnamed: J11.19, J12.19, J13.19
unnamed: J11.20, J12.20, J13.20
unnamed: J11.21, J12.21, J13.21
unnamed: J11.22, J12.22, J13.22
unnamed: J11.23, J12.23, J13.23
unnamed: J11.24, J12.24, J13.24
unnamed: J11.25, J12.25, J13.25
unnamed: J11.26, J12.26, J13.26
unnamed: J11.27, J12.27, J13.27
unnamed: J11.28, J12.28, J13.28
unnamed: J11.29, J12.29, J13.29
unnamed: J11.30, J12.30, J13.30
unnamed: J11.31, J12.31, J13.31
unnamed: J11.32, J12.32, J13.32
unnamed: J11.33, J12.33, J13.33
unnamed: J11.34, J12.34, J13.34
unnamed: J11.35, J12.35, J13.35
unnamed: J11.36, J12.36, J13.36
unnamed: J11.37, J12.37, J13.37
unnamed: J11.38, J12.38, J13.38
unnamed: J15.1, J16.1, J17.1
unnamed: J15.2, J16.2, J17.2
unnamed: J15.3, J16.3, J17.3
unnamed: J15.4, J16.4, J17.4
unnamed: J15.5, J16.5, J17.5
unnamed: J15.6, J16.6, J17.6
unnamed: J15.7, J16.7, J17.7
unnamed: J15.8, J16.8, J17.8
unnamed: J15.9, J16.9, J17.9
unnamed: J15.10, J16.10, J17.10
unnamed: J15.11, J16.11, J17.11
unnamed: J15.12, J16.12, J17.12
unnamed: J15.13, J16.13, J17.13
unnamed: J15.14, J16.14, J17.14
unnamed: J15.15, J16.15, J17.15
unnamed: J15.16, J16.16, J17.16
unnamed: J15.17, J16.17, J17.17
unnamed: J15.18, J16.18, J17.18
unnamed: J15.19, J16.19, J17.19
unnamed: J15.20, J16.20, J17.20
unnamed: J15.21, J16.21, J17.21
unnamed: J15.22, J16.22, J17.22
unnamed: J15.23, J16.23, J17.23
unnamed: J15.24, J16.24, J17.24
unnamed: J15.25, J16.25, J17.25
unnamed: J15.26, J16.26, J17.26
unnamed: J15.27, J16.27, J17.27
unnamed: J15.28, J16.28, J17.28
unnamed: J15.29, J16.29, J17.29
unnamed: J15.30, J16.30, J17.30
unnamed: J15.31, J16.31, J17.31
unnamed: J15.32, J16.32, J17.32
unnamed: J15.33, J16.33, J17.33
unnamed: J15.34, J16.34, J17.34
unnamed: J15.35, J16.35, J17.35
unnamed: J15.36, J16.36, J17.36
unnamed: J15.37, J16.37, J17.37
unnamed: J15.38, J16.38, J17.38
unnamed: J18.1, J19.1
unnamed: J18.2, J19.2
unnamed: J18.3, J19.3
unnamed: J18.4, J19.4
unnamed: J18.5, J19.5
unnamed: J18.6, J19.6
unnamed: J18.7, J19.7
unnamed: J18.8, J19.8
unnamed: J18.9, J19.9
unnamed: J18.10, J19.10
unnamed: J18.11, J19.11
unnamed: J18.12, J19.12
unnamed: J18.13, J19.13
unnamed: J18.14, J19.14
unnamed: J18.15, J19.15
unnamed: J18.16, J19.16
unnamed: J18.17, J19.17
unnamed: J18.18, J19.18
unnamed: J18.19, J19.19
unnamed: J18.20, J19.20
unnamed: J18.21, J19.21
unnamed: J18.22, J19.22
unnamed: J18.23, J19.23
unnamed: J18.24, J19.24
unnamed: J18.25, J19.25
unnamed: J18.26, J19.26
unnamed: J18.27, J19.27
unnamed: J18.28, J19.28
unnamed: J18.29, J19.29
unnamed: J18.30, J19.30
unnamed: J18.31, J19.31
unnamed: J18.32, J19.32
unnamed: J18.33, J19.33
unnamed: J18.34, J19.34
unnamed: J18.35, J19.35
unnamed: J18.36, J19.36
unnamed: J18.37, J19.37
unnamed: J18.38, J19.38
unnamed: J22.1, J23.1
unnamed: J22.2, J23.2
unnamed: J22.3, J23.3
unnamed: J22.4, J23.4
unnamed: J22.5, J23.5
unnamed: J22.6, J23.6
unnamed: J22.7, J23.7
unnamed: J22.8, J23.8
unnamed: J22.9, J23.9
unnamed: J22.10, J23.10
unnamed: J22.11, J23.11
unnamed: J22.12, J23.12
unnamed: J22.13, J23.13
unnamed: J22.14, J23.14
unnamed: J22.15, J23.15
unnamed: J22.16, J23.16
unnamed: J22.17, J23.17
unnamed: J22.18, J23.18
unnamed: J22.19, J23.19
unnamed: J22.20, J23.20
unnamed: J22.21, J23.21
unnamed: J22.22, J23.22
unnamed: J22.23, J23.23
unnamed: J22.24, J23.24
unnamed: J22.25, J23.25
unnamed: J22.26, J23.26
unnamed: J22.27, J23.27
unnamed: J22.28, J23.28
unnamed: J22.29, J23.29
unnamed: J22.30, J23.30
unnamed: J22.31, J23.31
unnamed: J22.32, J23.32
unnamed: J22.33, J23.33
unnamed: J22.34, J23.34
unnamed: J22.35, J23.35
unnamed: J22.36, J23.36
unnamed: J22.37, J23.37
unnamed: J22.38, J23.38
unnamed: J24.1, J25.1, J26.1
unnamed: J24.2, J25.2, J26.2
unnamed: J24.3, J25.3, J26.3
unnamed: J24.4, J25.4, J26.4
unnamed: J24.5, J25.5, J26.5
unnamed: J24.6, J25.6, J26.6
unnamed: J24.7, J25.7, J26.7
unnamed: J24.8, J25.8, J26.8
unnamed: J24.9, J25.9, J26.9
unnamed: J24.10, J25.10, J26.10
unnamed: J24.11, J25.11, J26.11
unnamed: J24.12, J25.12, J26.12
unnamed: J24.13, J25.13, J26.13
unnamed: J24.14, J25.14, J26.14
unnamed: J24.15, J25.15, J26.15
unnamed: J24.16, J25.16, J26.16
unnamed: J24.17, J25.17, J26.17
unnamed: J24.18, J25.18, J26.18
unnamed: J24.19, J25.19, J26.19
unnamed: J24.20, J25.20, J26.20
unnamed: J24.21, J25.21, J26.21
unnamed: J24.22, J25.22, J26.22
unnamed: J24.23, J25.23, J26.23
unnamed: J24.24, J25.24, J26.24
unnamed: J24.25, J25.25, J26.25
unnamed: J24.26, J25.26, J26.26
unnamed: J24.27, J25.27, J26.27
unnamed: J24.28, J25.28, J26.28
unnamed: J24.29, J25.29, J26.29
unnamed: J24.30, J25.30, J26.30
unnamed: J24.31, J25.31, J26.31
unnamed: J24.32, J25.32, J26.32
unnamed: J24.33, J25.33, J26.33
unnamed: J24.34, J25.34, J26.34
unnamed: J24.35, J25.35, J26.35
unnamed: J24.36, J25.36, J26.36
unnamed: J24.37, J25.37, J26.37
unnamed: J24.38, J25.38, J26.38

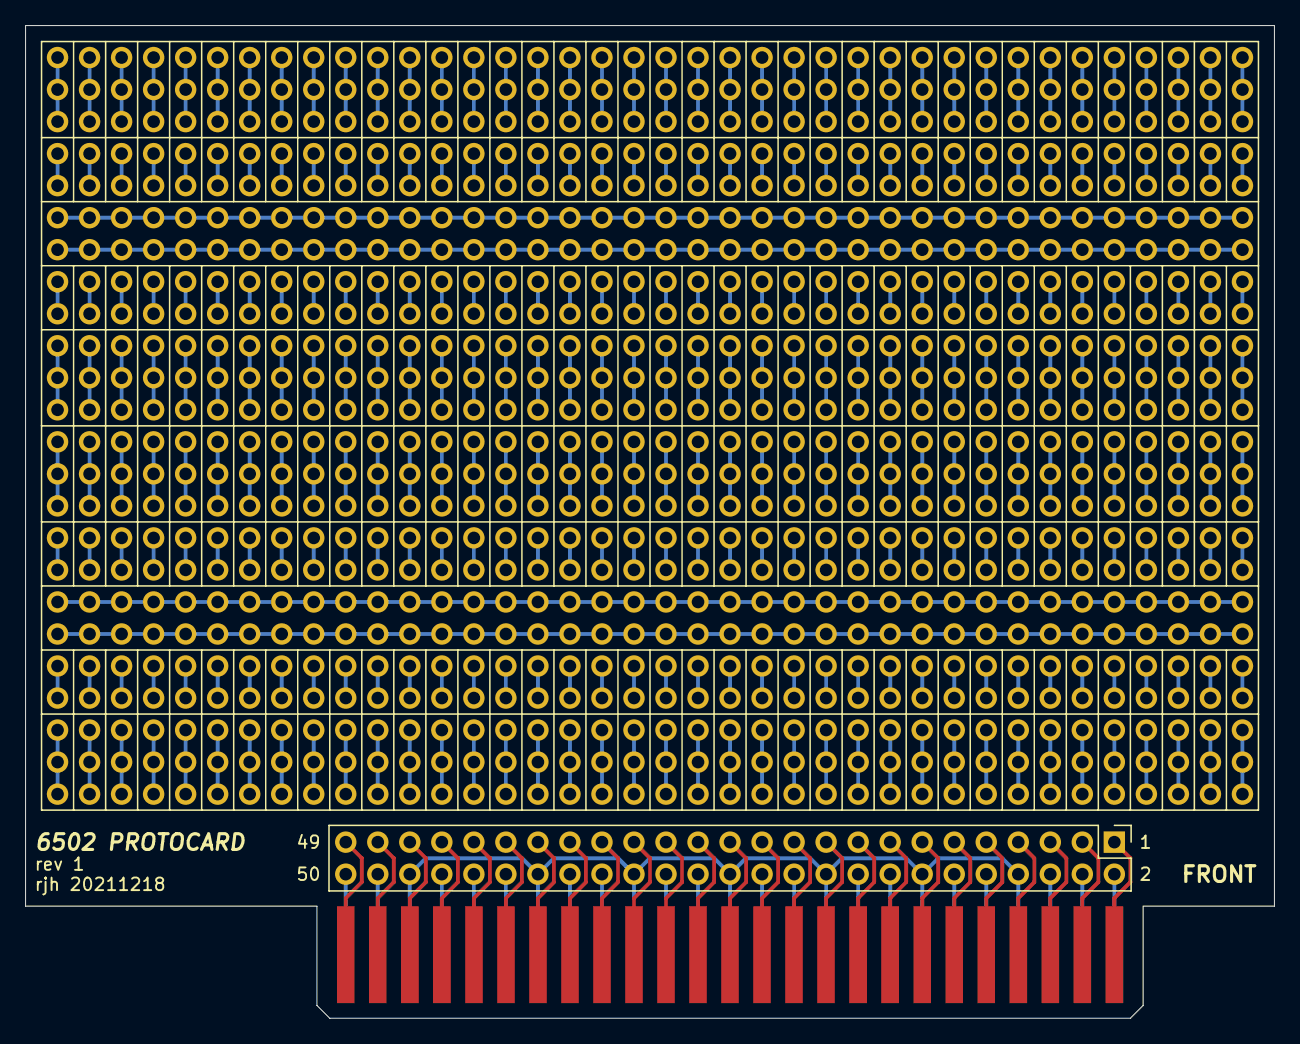
[picture p47: board proto_card.kicad_pcb from above]

Board: 2 copper layers, 99.1 x 78.7 mm, 26 parts (0 on the bottom side), 351 nets.
