rjhelms/compe6502/PicoVGA/compe_picovid/src/main.cpp

// ****************************************************************************
//
//                                 Main code
//
// ****************************************************************************

#include "include.h"

#define PIN_DATA_FIRST 10
#define PIN_READ 18
#define PIN_WRITE 19
#define PIN_EF 20
#define PIN_FF 21
#define PIN_OE 22

#define VID_HEIGHT 192
#define VID_WIDTH_XS 160
#define VID_WIDTH_LO 320
#define VID_WIDTH_HI 640
#define VID_WFULL_XS 160
#define VID_WFULL_LO 320
#define VID_WFULL_HI 640

#define TEXT_BOTTOM_4_HEIGHT (8 * 4)
#define TEXT_OFFSET_BOTTOM_4 (80 * 20)

#define CURSOR_XOR_MASK 0b10000000
#define CURSOR_BLINK_MS 250

u8 bg_color;
u8 fg_color;
u8 gr_color;

enum DispMode
{
	TEXT40 = 0,
	TEXT80 = 1,
	GR4BPP_TEXT = 2,
	GR1BPP_TEXT = 3,
	GR8BPP = 4,
	INVALID = 5,
	GR4BPP = 6,
	GR1BPP = 8
} dispMode;

enum CmdState
{
	DEFAULT,
	TEXT,
	CMD_C0_PUSH_GR_BYTE,
	CMD_D0_WRITE_CHAR,
	CMD_DC_MOVE_X_REL,
	CMD_DD_MOVE_Y_REL,
	CMD_DE_MOVE_X_ABS,
	CMD_DF_MOVE_Y_ABS,
	CMD_E0_SET_FG,
	CMD_E1_SET_BG
} state;

ALIGNED u8 textBuf[80 * 24];
ALIGNED u8 grBuf0[320 * 192 / 2];
ALIGNED u8 grBuf1[320 * 192 / 2];

u8 *grPtr;

u8 pal16[16];

u8 grViewPage = 0;
u8 grDrawPage = 0;
sSegm* grSeg;

bool cursorEnabled = true;
bool cursorState = false;
absolute_time_t cursorNextBlink;

// converts an X / Y position into a pointer offset
int GetTextBufOffset(int X, int Y)
{
	int offset = X + (Y * PrintBufWB); // offset common to all modes

	if (dispMode == GR4BPP_TEXT || dispMode == GR1BPP_TEXT)
	{
		// if in a graphics mode, Y coords are 20 lines down
		offset += TEXT_OFFSET_BOTTOM_4;
	}

	if (PrintBufWB >= PrintBufW * 2)
	{
		// in color modes, need to double X offset
		offset += X;
	}

	return offset;
}

void FlipCursorIfActive()
{
	if (cursorEnabled && cursorState)
	{
		textBuf[GetTextBufOffset(PrintX, PrintY)] ^= CURSOR_XOR_MASK;
	}
}

void TextAdvanceWrap()
{
	FlipCursorIfActive();
	PrintX++;
	if (PrintX >= PrintBufW)
	{
		PrintX -= PrintBufW;
		PrintY++;
	}
	FlipCursorIfActive();
}

// print character without advancing pointer
void PrintChar0NoAdv(char ch)
{
	if (((u32)PrintX < (u32)PrintBufW) && ((u32)PrintY < (u32)PrintBufH))
	{
		if ((PrintBufWB < 2 * PrintBufW))
		{
			u8 *d = &PrintBuf[PrintX + PrintY * PrintBufWB];
			*d = ch;
		}
		else
		{
			u8 *d = &PrintBuf[PrintX * 2 + PrintY * PrintBufWB];
			*d++ = ch;
			*d = PrintCol;
		}
	}
}

void PrintChar0Wrap(char ch)
{
	PrintChar0(ch);
	if (PrintX >= PrintBufW)
	{
		PrintX -= PrintBufW;
		PrintY++;
	}
}

// print character, using control characters CR, LF, TAB
void PrintCharCompe(char ch)
{
	FlipCursorIfActive();

	// BS
	if (ch == 0x08) // backspace
	{
		// TODO: handle below 0
		PrintX -= 1;
	}

	// CR
	else if (ch == CHAR_CR)
	{
		PrintX = 0;
	}

	// LF
	else if (ch == CHAR_LF)
	{
		PrintX = 0;
		PrintY++;
	}

	// Tab
	else if (ch == CHAR_TAB)
	{
		PrintX = (PrintX + 7) & ~7;
	}

	// character
	else
		PrintChar0Wrap(ch);

	FlipCursorIfActive();
}

void text_scroll()
{
	FlipCursorIfActive();
	for (int i = 0; i < (80 * 23); i++)
	{
		// for the first 23 lines of textBuf, copy the next line
		textBuf[i] = textBuf[i + 80];
	}
	if (dispMode == TEXT40 || dispMode == GR4BPP_TEXT)
	{
		for (int i = (80 * 23); i < (80 * 24); i += 2)
		{
			textBuf[i] = 0x20;
			textBuf[i + 1] = PrintCol;
		}
	}
	else if (dispMode == TEXT80 || dispMode == GR1BPP_TEXT)
	{
		for (int i = (80 * 23); i < (80 * 24); i++)
		{
			textBuf[i] = 0x20;
		}
	}

	PrintAddPos(0, -1); // move cursor up one
	FlipCursorIfActive();
}

void check_text_scroll()
{
	if (dispMode <= TEXT80)
	{
		if (PrintY >= 24)
		{
			text_scroll();
		}
		return;
	}

	if (dispMode <= GR1BPP_TEXT && PrintY >= 4)
	{
		text_scroll();
	}
	return;
}

void cmd_ef_reset_palette()
{
	memcpy(pal16, DefPal16, 16);
	GenPal16Trans(Pal16Trans, pal16);
}

void rotate_palette_forward_full()
{
	u8 c0 = pal16[0];
	for (int i = 0; i < 15; i++)
	{
		pal16[i] = pal16[i + 1];
	}
	pal16[15] = c0;
	GenPal16Trans(Pal16Trans, pal16);
}

void rotate_palette_backward_full()
{
	u8 c15 = pal16[15];
	for (int i = 15; i > 0; i--)
	{
		pal16[i] = pal16[i - 1];
	}
	pal16[0] = c15;
	GenPal16Trans(Pal16Trans, pal16);
}

void rotate_palette_forward_high()
{
	u8 c12 = pal16[12];
	for (int i = 12; i < 15; i++)
	{
		pal16[i] = pal16[i + 1];
	}
	pal16[15] = c12;
	GenPal16Trans(Pal16Trans, pal16);
}

void rotate_palette_backward_high()
{
	u8 c15 = pal16[15];
	for (int i = 15; i > 12; i--)
	{
		pal16[i] = pal16[i - 1];
	}
	pal16[12] = c15;
	GenPal16Trans(Pal16Trans, pal16);
}

void setupScreen()
{
	while (gpio_get(8))
	{

	}

	ScreenClear(pScreen);
	sStrip *strip;
	sSegm *segm;
	switch (dispMode)
	{
	case TEXT40:
		strip = ScreenAddStrip(pScreen, VID_HEIGHT);
		segm = ScreenAddSegm(strip, VID_WIDTH_LO);
		ScreenSegmAText(segm, textBuf, FontBold8x8, 8, pal16, 80);
		break;
	case TEXT80:
		strip = ScreenAddStrip(pScreen, VID_HEIGHT);
		segm = ScreenAddSegm(strip, VID_WIDTH_HI);
		ScreenSegmMText(segm, textBuf, FontBold8x8, 8, COL_BLACK, COL_WHITE, 80);
		break;
	case GR4BPP_TEXT:
		strip = ScreenAddStrip(pScreen, (VID_HEIGHT - TEXT_BOTTOM_4_HEIGHT));
		segm = ScreenAddSegm(strip, VID_WIDTH_LO);
		grSeg = segm;
		if (grViewPage == 0)
		{
			ScreenSegmGraph4(segm, grBuf0, Pal16Trans, VID_WIDTH_LO / 2);
		}
		else
		{
			ScreenSegmGraph4(segm, grBuf1, Pal16Trans, VID_WIDTH_LO / 2);
		}
		if (grDrawPage == 0)
		{
			Canvas.img = grBuf0;
			grPtr = grBuf0;
		}
		else
		{
			Canvas.img = grBuf1;
			grPtr = grBuf1;
		}
		Canvas.w = VID_WIDTH_LO;
		Canvas.h = (VID_HEIGHT - TEXT_BOTTOM_4_HEIGHT);
		Canvas.wb = VID_WIDTH_LO / 2;
		Canvas.format = CANVAS_4;
		strip = ScreenAddStrip(pScreen, TEXT_BOTTOM_4_HEIGHT);
		segm = ScreenAddSegm(strip, VID_WIDTH_LO);
		ScreenSegmAText(segm, textBuf + TEXT_OFFSET_BOTTOM_4, FontBold8x8, 8, pal16, 80);
		break;
	case GR1BPP_TEXT:
		strip = ScreenAddStrip(pScreen, (VID_HEIGHT - TEXT_BOTTOM_4_HEIGHT));
		segm = ScreenAddSegm(strip, VID_WIDTH_HI);
		grSeg = segm;
		if (grViewPage == 0)
		{
			ScreenSegmGraph1(segm, grBuf0, COL_BLACK, COL_WHITE, VID_WIDTH_HI / 8);
		}
		else
		{
			ScreenSegmGraph1(segm, grBuf1, COL_BLACK, COL_WHITE, VID_WIDTH_HI / 8);
		}
		if (grDrawPage == 0)
		{
			Canvas.img = grBuf0;
			grPtr = grBuf0;
		}
		else
		{
			Canvas.img = grBuf1;
			grPtr = grBuf1;
		}

		Canvas.w = VID_WIDTH_HI;
		Canvas.h = (VID_HEIGHT - TEXT_BOTTOM_4_HEIGHT);
		Canvas.wb = VID_WIDTH_HI / 8;
		Canvas.format = CANVAS_1;

		strip = ScreenAddStrip(pScreen, TEXT_BOTTOM_4_HEIGHT);
		segm = ScreenAddSegm(strip, VID_WIDTH_HI);
		ScreenSegmMText(segm, textBuf + TEXT_OFFSET_BOTTOM_4, FontBold8x8, 8, COL_BLACK, COL_WHITE, 80);
		break;
	case GR8BPP:
		strip = ScreenAddStrip(pScreen, (VID_HEIGHT));
		segm = ScreenAddSegm(strip, VID_WIDTH_XS);
		grSeg = segm;
		if (grViewPage == 0)
		{
			ScreenSegmGraph8(segm, grBuf0, VID_WIDTH_XS);
		}
		else
		{
			ScreenSegmGraph8(segm, grBuf1, VID_WIDTH_XS);
		}
		if (grDrawPage == 0)
		{
			Canvas.img = grBuf0;
			grPtr = grBuf0;
		}
		else
		{
			Canvas.img = grBuf1;
			grPtr = grBuf1;
		}
		Canvas.w = VID_WIDTH_XS;
		Canvas.h = (VID_HEIGHT);
		Canvas.wb = VID_WIDTH_XS;
		Canvas.format = CANVAS_8;
		break;
	case GR4BPP:
		strip = ScreenAddStrip(pScreen, (VID_HEIGHT));
		segm = ScreenAddSegm(strip, VID_WIDTH_LO);
		grSeg = segm;
		if (grViewPage == 0)
		{
			ScreenSegmGraph4(segm, grBuf0, Pal16Trans, VID_WIDTH_LO / 2);
		}
		else
		{
			ScreenSegmGraph4(segm, grBuf1, Pal16Trans, VID_WIDTH_LO / 2);
		}
		if (grDrawPage == 0)
		{
			Canvas.img = grBuf0;
			grPtr = grBuf0;
		}
		else
		{
			Canvas.img = grBuf1;
			grPtr = grBuf1;
		}

		Canvas.w = VID_WIDTH_LO;
		Canvas.h = (VID_HEIGHT);
		Canvas.wb = VID_WIDTH_LO / 2;
		Canvas.format = CANVAS_4;
		break;
	case GR1BPP:
		strip = ScreenAddStrip(pScreen, (VID_HEIGHT));
		segm = ScreenAddSegm(strip, VID_WIDTH_HI);
		grSeg = segm;
		if (grViewPage == 0)
		{
			ScreenSegmGraph1(segm, grBuf0, COL_BLACK, COL_WHITE, VID_WIDTH_HI / 8);
		}
		else
		{
			ScreenSegmGraph1(segm, grBuf1, COL_BLACK, COL_WHITE, VID_WIDTH_HI / 8);
		}
		if (grDrawPage == 0)
		{
			Canvas.img = grBuf0;
			grPtr = grBuf0;
		}
		else
		{
			Canvas.img = grBuf1;
			grPtr = grBuf1;
		}
		Canvas.w = VID_WIDTH_HI;
		Canvas.h = (VID_HEIGHT);
		Canvas.wb = VID_WIDTH_HI / 8;
		Canvas.format = CANVAS_1;
		break;
	}
}

void configure_vid(u16 width, u16 wfull)
{
	VgaCfgDef(&Cfg);
	Cfg.width = width;
	Cfg.height = VID_HEIGHT;
	Cfg.wfull = wfull;
	Cfg.video = &VideoNTSCp;
	VgaCfg(&Cfg, &Vmode);
	set_sys_clock_pll(Vmode.vco * 1000, Vmode.pd1, Vmode.pd2);
	VgaInitReq(NULL); // call with null to clear any existing rendering
	VgaInitReq(&Vmode);
}

void cmd_f0_set_mode_text40()
{
	configure_vid(VID_WIDTH_LO, VID_WFULL_LO);
	dispMode = TEXT40;
	setupScreen();
	PrintSetup(textBuf, 40, 24, 80);
	PrintSetCol(PC_COLOR(bg_color, fg_color));
}

void cmd_f1_set_mode_text80()
{
	configure_vid(VID_WIDTH_HI, VID_WFULL_HI);
	dispMode = TEXT80;
	setupScreen();
	PrintSetup(textBuf, 80, 24, 80);
}

void cmd_f2_set_mode_gr4_text()
{
	configure_vid(VID_WIDTH_LO, VID_WFULL_LO);
	dispMode = GR4BPP_TEXT;
	setupScreen();
	PrintSetup(textBuf + TEXT_OFFSET_BOTTOM_4, 40, 4, 80);
	PrintSetCol(PC_COLOR(bg_color, fg_color));
}

void cmd_f3_set_mode_gr1_text()
{
	configure_vid(VID_WIDTH_HI, VID_WFULL_HI);
	dispMode = GR1BPP_TEXT;
	setupScreen();
	PrintSetup(textBuf + TEXT_OFFSET_BOTTOM_4, 80, 4, 80);
}

void cmd_f4_set_mode_gr8()
{
	configure_vid(VID_WIDTH_XS, VID_WFULL_XS);
	dispMode = GR8BPP;
	setupScreen();
}

void cmd_f6_set_mode_gr4()
{
	configure_vid(VID_WIDTH_LO, VID_WFULL_LO);
	dispMode = GR4BPP;
	setupScreen();
}

void cmd_f7_set_mode_gr1()
{
	configure_vid(VID_WIDTH_HI, VID_WFULL_HI);
	dispMode = GR1BPP;
	setupScreen();
}

void init_gpio()
{
	for (int i = 0; i < 8; i++)
	{
		gpio_init(PIN_DATA_FIRST + i);
		gpio_set_dir(PIN_DATA_FIRST + i, false);
	}

	gpio_init(PIN_EF);
	gpio_set_dir(PIN_EF, false);

	gpio_init(PIN_FF);
	gpio_set_dir(PIN_FF, false);

	gpio_init(PIN_READ);
	gpio_init(PIN_WRITE);
	gpio_init(PIN_OE);

	gpio_put(PIN_READ, true);
	gpio_put(PIN_WRITE, true);
	gpio_put(PIN_OE, false);

	gpio_set_dir(PIN_READ, true);
	gpio_set_dir(PIN_WRITE, true);
	gpio_set_dir(PIN_OE, true);

	stdio_init_all();
}

void cmd_ff_reset_display()
{
	cmd_f0_set_mode_text40();
	bg_color = PC_BLACK;
	fg_color = PC_WHITE;
	PrintSetCol(PC_COLOR(bg_color, fg_color));
	PrintClear();
	PrintHome();
	dispMode = TEXT40;
	cmd_ef_reset_palette();
	cursorEnabled = true;
	cursorState = false;
	cursorNextBlink = make_timeout_time_ms(CURSOR_BLINK_MS);
	grViewPage = 0;
}

// set GPIO direction - false for read, true for write
void set_direction(bool direction)
{
	for (int i = 0; i < 8; i++)
	{
		gpio_set_dir(PIN_DATA_FIRST + i, direction);
	}
}

void write_byte(u8 val)
{
	// spin until buffer is not full
	while (!gpio_get(PIN_FF))
	{
	}

	gpio_put(PIN_WRITE, false);

	for (int i = 0; i < 8; i++)
	{
		gpio_put(PIN_DATA_FIRST + i, val & 1 << i);
	}

	gpio_put(PIN_OE, true);
	sleep_us(1);
	gpio_put(PIN_WRITE, true);
	gpio_put(PIN_OE, false);
}

void write_single_byte(u8 val)
{
	set_direction(true);
	write_byte(val);
	set_direction(false);
}

u8 read_byte()
{
	u8 val = 0;
	gpio_put(PIN_READ, false);
	gpio_put(PIN_OE, true);

	sleep_us(1);

	val = 0;
	for (int i = 7; i >= 0; i--)
	{
		val <<= 1;
		if (gpio_get(PIN_DATA_FIRST + i))
		{
			val++;
		}
	}
	gpio_put(PIN_READ, true);
	gpio_put(PIN_OE, false);

	return val;
}

u8 read_byte_blocking()
{
	// spin until there is a byte
	while (!gpio_get(PIN_EF))
	{
	}
	return read_byte();
}

void cmd_b2_draw_pixel()
{
	u8 x_lo = read_byte_blocking();
	u8 x_hi = read_byte_blocking();
	u8 y_lo = read_byte_blocking();
	u8 y_hi = read_byte_blocking();
	DrawPoint(&Canvas, x_lo + (x_hi << 8), y_lo + (y_hi << 8), gr_color);
}

void cmd_b3_get_pixel()
{
	u8 result = 0;

	u8 x_lo = read_byte_blocking();
	u8 x_hi = read_byte_blocking();
	u8 y_lo = read_byte_blocking();
	u8 y_hi = read_byte_blocking();

	int x = x_lo + (x_hi << 8);
	int y = y_lo + (y_hi << 8);

	u8 *d;

	switch ((&Canvas)->format)
	{
	case CANVAS_8:
		result = (&Canvas)->img[x + y * (&Canvas)->wb];
		break;
	case CANVAS_4:
		d = (&Canvas)->img + x / 2 + y * (&Canvas)->wb;
		if ((x & 1) == 0) // first pixel
		{
			result = *d >> 4;
		}
		else
		{ // second pixel
			result = *d & 0xF;
		}
		break;
	case CANVAS_1:
		d = (&Canvas)->img + x / 8 + y * (&Canvas)->wb;
		switch (x & 7)
		{
		case 0:
			result = (*d & 0x80) >> 7;
			break;
		case 1:
			result = (*d & 0x40) >> 6;
			break;
		case 2:
			result = (*d & 0x20) >> 5;
			break;
		case 3:
			result = (*d & 0x10) >> 4;
			break;
		case 4:
			result = (*d & 0x08) >> 3;
			break;
		case 5:
			result = (*d & 0x04) >> 2;
			break;
		case 6:
			result = (*d & 0x02) >> 1;
			break;
		case 7:
			result = (*d & 0x01);
			break;
		}
		break;
	}
	write_single_byte(result);
}

void cmd_b4_draw_line()
{
	u8 x1_lo = read_byte_blocking();
	u8 x1_hi = read_byte_blocking();
	u8 y1_lo = read_byte_blocking();
	u8 y1_hi = read_byte_blocking();
	u8 x2_lo = read_byte_blocking();
	u8 x2_hi = read_byte_blocking();
	u8 y2_lo = read_byte_blocking();
	u8 y2_hi = read_byte_blocking();
	DrawLine(&Canvas, x1_lo + (x1_hi << 8), y1_lo + (y1_hi << 8), x2_lo + (x2_hi << 8), y2_lo + (y2_hi << 8), gr_color);
}

void cmd_b5_draw_rect()
{
	u8 x1_lo = read_byte_blocking();
	u8 x1_hi = read_byte_blocking();
	u8 y1_lo = read_byte_blocking();
	u8 y1_hi = read_byte_blocking();
	u8 x2_lo = read_byte_blocking();
	u8 x2_hi = read_byte_blocking();
	u8 y2_lo = read_byte_blocking();
	u8 y2_hi = read_byte_blocking();
	DrawRect(&Canvas, x1_lo + (x1_hi << 8), y1_lo + (y1_hi << 8), x2_lo + (x2_hi << 8), y2_lo + (y2_hi << 8), gr_color);
}

void cmd_c8_blit_bytestream()
{
	u8 startx = read_byte_blocking();
	u8 starty = read_byte_blocking();
	u8 w = read_byte_blocking();
	u8 h = read_byte_blocking();

	if (grViewPage = 0)
	{
		grPtr = grBuf0;
	}
	else
	{
		grPtr = grBuf1;
	}
	grPtr += starty * Canvas.wb;
	grPtr += startx;

	for (u8 y = 0; y < h; y++)
	{
		for (u8 x = 0; x < w; x++)
		{
			*grPtr = read_byte_blocking();
			grPtr++;
		}
		grPtr += (Canvas.wb - w);
	}
}

void cmd_cc_set_view_page(u8 page)
{
	grViewPage = page;
	if (page == 0)
	{
		grSeg->data = grBuf0;
	} else {
		grSeg->data = grBuf1;
	}
}

void cmd_ce_set_draw_page(u8 page)
{
	grDrawPage = page;
	if (page == 0)
	{
		Canvas.img = grBuf0;
	} else {
		Canvas.img = grBuf1;
	}
}

void cmd_e2_set_all_text_fg()
{
	if (dispMode != TEXT40 && dispMode != GR4BPP_TEXT)
	{
		return;
	}
	for (int i = 1; i < (80 * 24); i += 2)
	{
		textBuf[i] = (textBuf[i] & 0xF0) + fg_color;
	}
}

void cmd_e3_set_all_text_bg()
{
	for (int i = 1; i < (80 * 24); i += 2)
	{
		textBuf[i] = (textBuf[i] & 0x0F) + (bg_color << 4);
	}
}

void cmd_ee_load_palette()
{
	for (int i = 0; i < 16; i++)
	{
		pal16[i] = read_byte_blocking();
	}
	GenPal16Trans(Pal16Trans, pal16);
	return;
}

int main()
{
	u8 last_byte = 0;
	state = DEFAULT;

	multicore_reset_core1();
	multicore_launch_core1(VgaCore);

	init_gpio();

	cmd_ff_reset_display();

	while (true)
	{
		if (cursorEnabled && absolute_time_diff_us(get_absolute_time(), cursorNextBlink) < 0)
		{
			cursorNextBlink = make_timeout_time_ms(CURSOR_BLINK_MS);
			cursorState = !cursorState;
			textBuf[GetTextBufOffset(PrintX, PrintY)] ^= CURSOR_XOR_MASK;
		}

		if (gpio_get(PIN_EF)) // EF goes high when FIFO has content
		{
			last_byte = read_byte();
			switch (state)
			{
			case TEXT:
				switch (last_byte)
				{
				case 0x03:
					state = DEFAULT;
					break;
				default:
					PrintCharCompe(last_byte);
					check_text_scroll();
					break;
				}
				break;

			case CMD_C0_PUSH_GR_BYTE:
				*grPtr = last_byte;
				grPtr++;
				state = DEFAULT;
				break;

			case CMD_D0_WRITE_CHAR:
				FlipCursorIfActive();
				PrintChar0NoAdv(last_byte);
				FlipCursorIfActive();
				state = DEFAULT;
				break;

			case CMD_DC_MOVE_X_REL:
				FlipCursorIfActive();
				PrintAddPos((s8)last_byte, 0);
				FlipCursorIfActive();
				state = DEFAULT;
				break;

			case CMD_DD_MOVE_Y_REL:
				FlipCursorIfActive();
				PrintAddPos(0, (s8)last_byte);
				FlipCursorIfActive();
				state = DEFAULT;
				break;

			case CMD_DE_MOVE_X_ABS:
				FlipCursorIfActive();
				PrintSetPos((s8)last_byte, PrintY);
				FlipCursorIfActive();
				state = DEFAULT;
				break;

			case CMD_DF_MOVE_Y_ABS:
				FlipCursorIfActive();
				PrintSetPos(PrintX, (s8)last_byte);
				FlipCursorIfActive();
				state = DEFAULT;
				break;

			case CMD_E0_SET_FG:
				fg_color = last_byte & 0x0F;
				PrintSetCol(PC_COLOR(bg_color, fg_color));
				state = DEFAULT;
				break;

			case CMD_E1_SET_BG:
				bg_color = last_byte & 0x0F;
				PrintSetCol(PC_COLOR(bg_color, fg_color));
				state = DEFAULT;
				break;

			default:
				switch (last_byte)
				{
				case 0x02: // enter text mode
					state = TEXT;
					break;
				case 0xB0: // set drawing color
					gr_color = read_byte_blocking();
					break;
				case 0xB1: // get drawing color
					write_single_byte(gr_color);
					break;
				case 0xB2: // draw single pixel
					cmd_b2_draw_pixel();
					break;
				case 0xB4: // draw line
					cmd_b4_draw_line();
					break;
				case 0xB5: // draw box
					cmd_b5_draw_rect();
					break;
				case 0xC0: // push graphics byte
					state = CMD_C0_PUSH_GR_BYTE;
					break;
				case 0xC8: // blit bytestream;
					cmd_c8_blit_bytestream();
					break;
				case 0xCC: // set view page 0
					cmd_cc_set_view_page(0);
					break;
				case 0xCD: // set view page 1
					cmd_cc_set_view_page(1);
					break;
				case 0xCE: // set draw page 0
					cmd_ce_set_draw_page(0);
					break;
				case 0xCF: // set draw page 1
					cmd_ce_set_draw_page(1);
					break;
				case 0xD0: // write single text char
					state = CMD_D0_WRITE_CHAR;
					break;
				case 0xD1: // get byte at current position
					write_single_byte((u8)textBuf[GetTextBufOffset(PrintX, PrintY)]);
					break;
				case 0xD6: // advance cursor one position w/ wrap
					TextAdvanceWrap();
					break;
				case 0xD8: // get X position
					write_single_byte((u8)PrintX);
					break;
				case 0xD9: // get Y position
					write_single_byte((u8)PrintY);
					break;
				case 0xDA: // get X size
					write_single_byte((u8)PrintBufW);
					break;
				case 0xDB: // get Y size
					write_single_byte((u8)PrintBufH);
					break;
				case 0xDC: // move X relative
					state = CMD_DC_MOVE_X_REL;
					break;
				case 0xDD: // move Y relative
					state = CMD_DD_MOVE_Y_REL;
					break;
				case 0xDE: // move X absolute
					state = CMD_DE_MOVE_X_ABS;
					break;
				case 0xDF: // move Y absolute
					state = CMD_DF_MOVE_Y_ABS;
					break;
				case 0xE0: // set foreground color
					state = CMD_E0_SET_FG;
					break;
				case 0xE1: // set background color
					state = CMD_E1_SET_BG;
					break;
				case 0xE2: // set all text to fg_color
					cmd_e2_set_all_text_fg();
					break;
				case 0xE3: // set all text to bg_color
					cmd_e3_set_all_text_bg();
					break;
				case 0xE4: // get current fg_color - returns 15 in mono modes
					if (dispMode == TEXT80 || dispMode == GR1BPP_TEXT)
					{
						write_single_byte(0x0F);
					}
					else
					{
						write_single_byte(fg_color);
					}
					break;
				case 0xE5: // get current bg_color - returns 0 in mono modes
					if (dispMode == TEXT80 || dispMode == GR1BPP_TEXT)
					{
						write_single_byte(0x00);
					}
					else
					{
						write_single_byte(bg_color);
					}
					break;
				case 0xE8: // rotate palette forward
					rotate_palette_forward_full();
					break;
				case 0xE9: // rotate palette backward
					rotate_palette_backward_full();
					break;
				case 0xEA: // rotate high 4 forward
					rotate_palette_forward_high();
					break;
				case 0xEB:
					rotate_palette_backward_high();
					break;
				case 0xEE:
					cmd_ee_load_palette();
					break;
				case 0xEF: // reset palette
					cmd_ef_reset_palette();
					break;
				case 0xF0: // set 40 col text mode
					cmd_f0_set_mode_text40();
					break;
				case 0xF1: // set 80 col text mode
					cmd_f1_set_mode_text80();
					break;
				case 0xF2: // set 4bpp with text mode
					cmd_f2_set_mode_gr4_text();
					break;
				case 0xF3: // set 1bpp with text mode
					cmd_f3_set_mode_gr1_text();
					break;
				case 0xF4: // set 8bpp mode
					cmd_f4_set_mode_gr8();
					break;
				case 0xF6: // set 4bpp mode
					cmd_f6_set_mode_gr4();
					break;
				case 0xF7: // set 1bpp mode
					cmd_f7_set_mode_gr1();
					break;
				case 0xF8:				  // disable cursor
					FlipCursorIfActive(); // turn off if currently displayed
					cursorEnabled = false;
					break;
				case 0xF9:				  // enable cursor
					FlipCursorIfActive(); // turn off if currently displayed just in case it's already active
					cursorNextBlink = make_timeout_time_ms(CURSOR_BLINK_MS);
					cursorState = false;
					cursorEnabled = true;
					break;
				case 0xFE: //
					if (dispMode <= GR1BPP_TEXT)
					{
						PrintClear();
						PrintHome();
						cursorNextBlink = make_timeout_time_ms(CURSOR_BLINK_MS);
						cursorState = false;
					}
					if (dispMode >= GR4BPP_TEXT)
					{
						DrawClear(&Canvas);
					}
					break;
				case 0xFF:
					cmd_ff_reset_display();
				default:
					break;
				}
			}
		}
	}
}
