rjhelms/compe6502/(commit log)

2021-12-24 Add existing ROM
    [compe6502_ROM.cfg]
2021-12-24 Tweak LORAM size
    Will need 4 pages:
    - input buffer
    - vector page
    - 2 pages for SD card workspace
    [compe6502_ROM.cfg]
2021-12-24 Add hardware
    [CassetteModem.sch, Decoupling_Bypass.sch, HTiming.sch, KeyboardMCU.sch, SpeakerAmp.sch, SystemIO.sch, VTiming.sch, backplane.kicad_pcb]
2021-12-24 Add vector tables
    [compe6502_ROM.cfg]
2021-12-24 Move status display into MON
    BIOS page was full - so bump MON up to 3 pages and move that method there.
    [compe6502_ROM.cfg]
2021-12-24 Fix video clear line
    Resolves #5.
    [Decoupling_Bypass.sch, HTiming.sch, SystemIO.sch, VTiming.sch, video_ribbons.kicad_pcb, video_ribbons.sch]
2021-12-24 Update video_ribbons.kicad_pcb
    Also part of fix for #5
    [video_ribbons.kicad_pcb]
2021-12-24 Fix backplane LEDs
    Resolves issue #4
    [backplane.kicad_pcb, backplane.sch]
2021-12-24 Change address decode on backplane
    Resolves issue #3
    [backplane.kicad_pcb, backplane.sch]
2021-12-24 Increment backplane rev & date
    [backplane.kicad_pcb, backplane.sch]
2021-12-31 Prep rom for I/O card
    Use handshake rather than pulse mode for keyboard reads, so keyboard MCU won't have to rely on interrupt
2022-01-09 Assemble ROM sources to separate objects
    [compe6502_ROM.cfg]
2022-01-09 Create SYS segment
    [compe6502_ROM.cfg]
2022-01-09 Change VECT_TAB and SD_WORK segs to type BSS
    Otherwise these show up as offsets in the output file for some reason
    [compe6502_ROM.cfg]
2022-01-10 Add MSBASIC to repo
    [aim65.cfg, applesoft.cfg, cbmbasic1.cfg, cbmbasic2.cfg, kb9.cfg, kbdbasic.cfg, microtan.cfg, osi.cfg]
2022-01-10 Update makefile and config to get ready for BASIC
    [compe6502_ROM.cfg]
2022-01-10 Minimum viable BASIC implementation
    [compe6502_ROM.cfg]
2022-01-10 Add in KBD GET_UPPER patch
    Part of #16 - this casts tokens the upper case.
    Lower-case variable names throw a syntax error, maybe there is a similar change needed elsewhere.
2022-01-16 Work on motherboard design
    [AddressDecode.kicad_sch, Expansion.kicad_sch, PowerDecoupling.kicad_sch, address_decoding.ods, motherboard.kicad_pcb, motherboard.kicad_sch]
2022-01-17 Complete mobo first draft
    [AddressDecode.kicad_sch, Expansion.kicad_sch, PowerDecoupling.kicad_sch, motherboard.kicad_pcb, motherboard.kicad_sch]
2022-02-02 Misc hardware work
    [AddressDecode.kicad_sch, Expansion.kicad_sch, PowerDecoupling.kicad_sch, motherboard.kicad_pcb, motherboard.kicad_sch, sd_panel.kicad_pcb, sd_panel.kicad_sch]
2022-08-16 Add picoVGA firmware (#26)
    * Begin ROM support for PicoVGA routines
    * Replace CR with LF for PicoVGA
    * More CR to LF changes
    Missed a few in EWOZ
    * Even more CR to LF
    In cassette routines
    * Even more CR-to-LF changes
    Again in EWOZ. I think this might be it?
    * Lol nope
    * Add bin2byte utility
    For converting binary data into cc65 .byte directives
    * Add PicoVGA SDK & project
    Not sure how/if this needs to be in here, lol
    * Add bin2tape_raw
    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
    [picovga interface.ods]
2022-08-17 TGI support & 1bpp driver
    [picovga interface.ods]
2022-08-18 Add partial 4bpp driver
    Dynamic palette support still to-do
    [picovga interface.ods]
2022-08-20 Add VIA timer to ROM
2022-08-20 Add _clock to assembly lib
    Or could this just be a pointer reference?
2022-08-20 Reinitialize timer on warm reset
    VIA loses all its state
2022-08-20 Fix: toggle cursor on TextAdvanceWrap
    Man the way conio does this is weird.
    [main.cpp]
2022-08-23 Update picovga interface doc
    [picovga interface.ods]
2022-08-24 Update interface doc
    [picovga interface.ods]
2022-08-24 Add 8bpp driver
2022-08-24 Add compile-time driver selection to clock.c
